ClemenceSul/FALCON_Hand/BuildingInstructions/Guide_Images/2_AssembleFinger/Components/Digital/Slide2.PNG

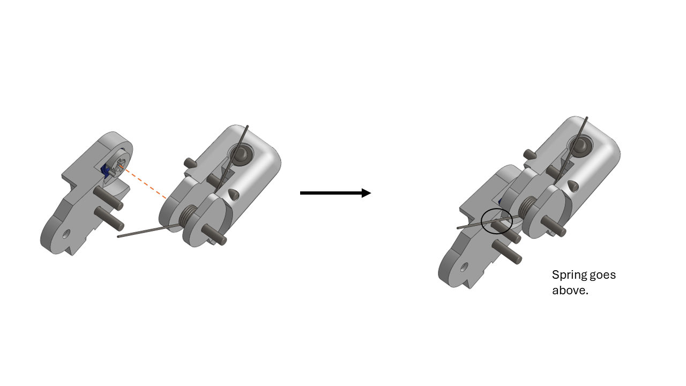
BuildingInstructions/Guide_Images/2_AssembleFinger/Components/Digital/Slide2.PNG
