ClemenceSul/FALCON_Hand/BuildingInstructions/Guide_Images/2_AssembleFinger/Components/Real/Slide4.PNG

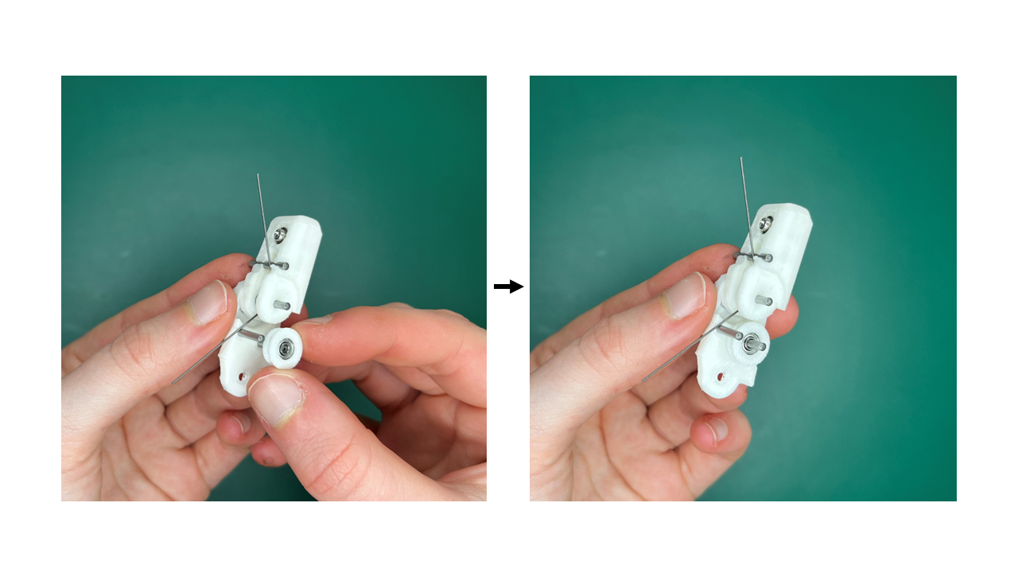
BuildingInstructions/Guide_Images/2_AssembleFinger/Components/Real/Slide4.PNG
