ClemenceSul/FALCON_Hand/3DFiles/Thumb/CMC_main.STL

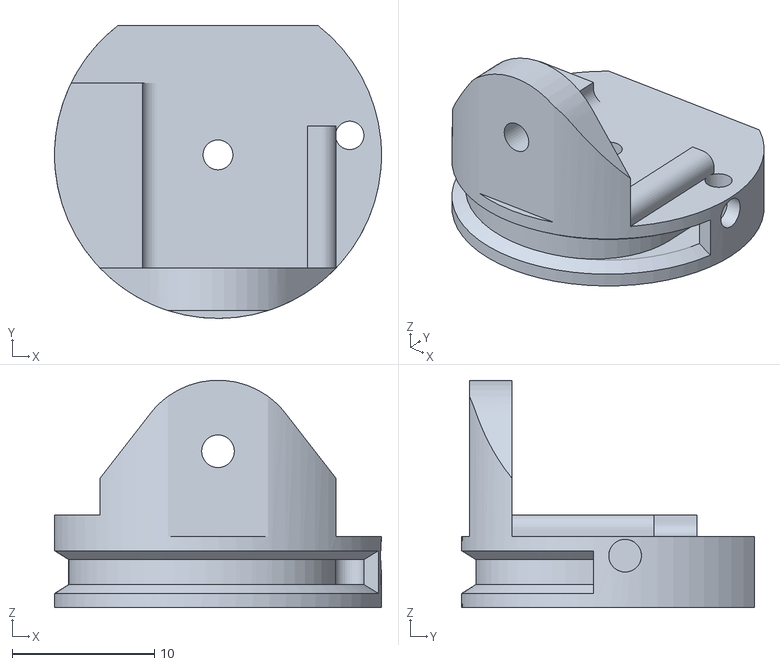
[picture p10: CAD file, 2024-06-19]
3DFiles/Thumb/CMC_main.STL
23.0 x 20.6 x 16.0
