ClemenceSul/FALCON_Hand/3DFiles/Fingers/PulleySpool.STL

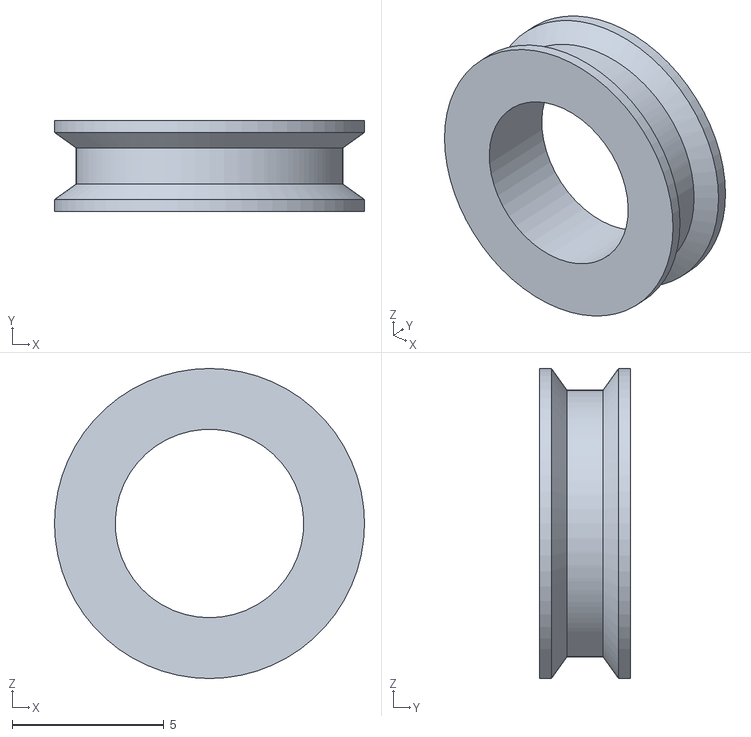
[picture p11: CAD file, 2024-06-19]
3DFiles/Fingers/PulleySpool.STL
10.2 x 3.00 x 10.2
