ClemenceSul/FALCON_Hand/3DFiles/Palm/Knuckles.STL

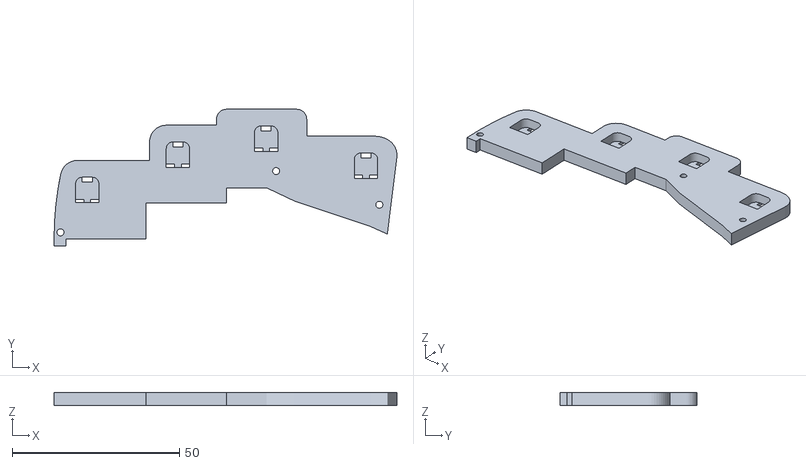
[picture p12: CAD file, 2024-06-19]
3DFiles/Palm/Knuckles.STL
102.6 x 40.8 x 4.00
