ClemenceSul/FALCON_Hand/3DFiles/Practice.STL

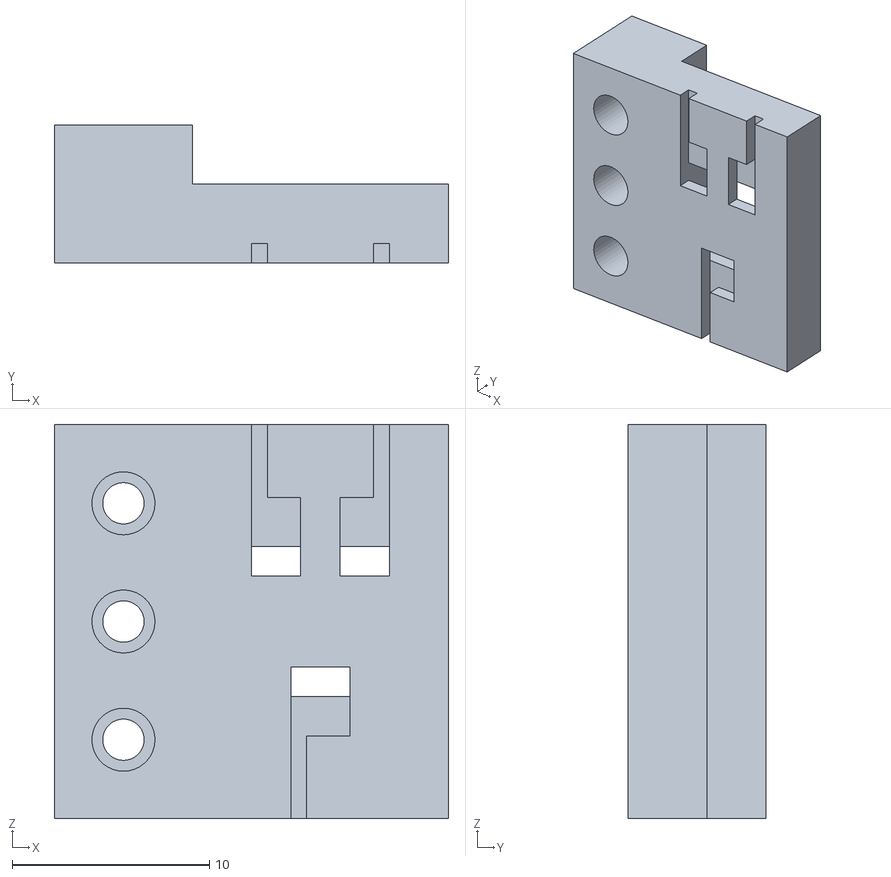
[picture p13: CAD file, 2024-06-19]
3DFiles/Practice.STL
20.0 x 7.00 x 20.0
