ClemenceSul/FALCON_Hand/3DFiles/Thumb/Thumb_ProximalRight.STL

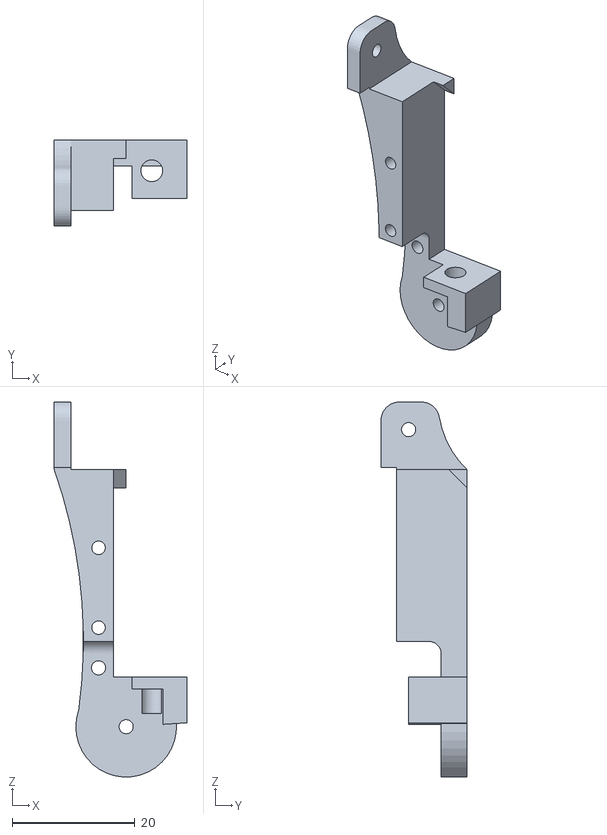
[picture p14: CAD file, 2024-06-19]
3DFiles/Thumb/Thumb_ProximalRight.STL
21.6 x 14.0 x 61.1
