ClemenceSul/FALCON_Hand/3DFiles/Fingers/MI_Metacarpal.STL

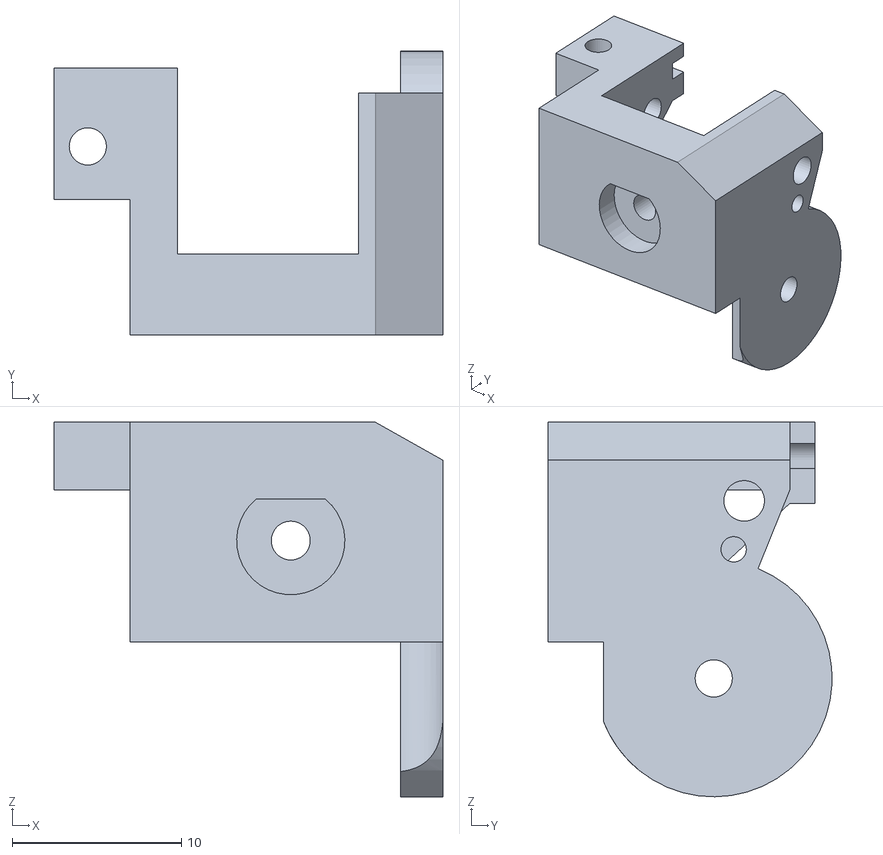
[picture p15: CAD file, 2024-06-19]
3DFiles/Fingers/MI_Metacarpal.STL
23.0 x 16.8 x 22.1
