ClemenceSul/FALCON_Hand/3DFiles/Palm/Palm.STL

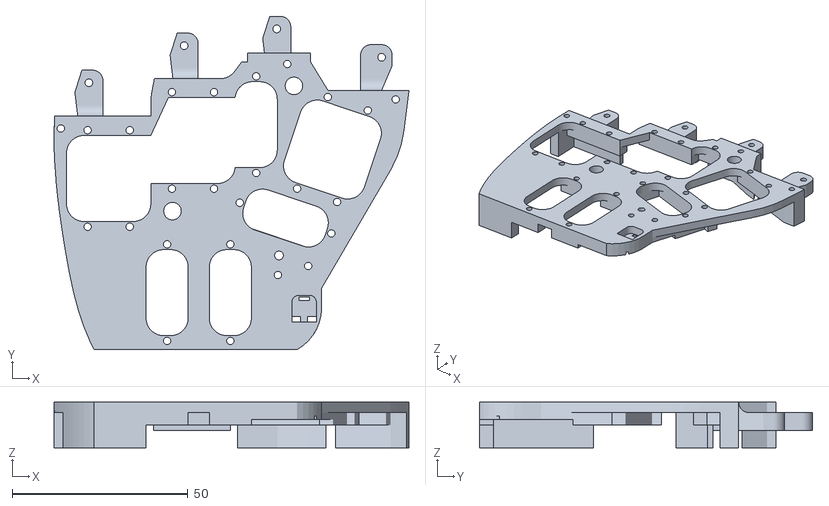
[picture p16: CAD file, 2024-06-19]
3DFiles/Palm/Palm.STL
101.1 x 94.9 x 13.0
