ClemenceSul/FALCON_Hand/3DFiles/Fingers/PR_ProximalRight_vN.STL

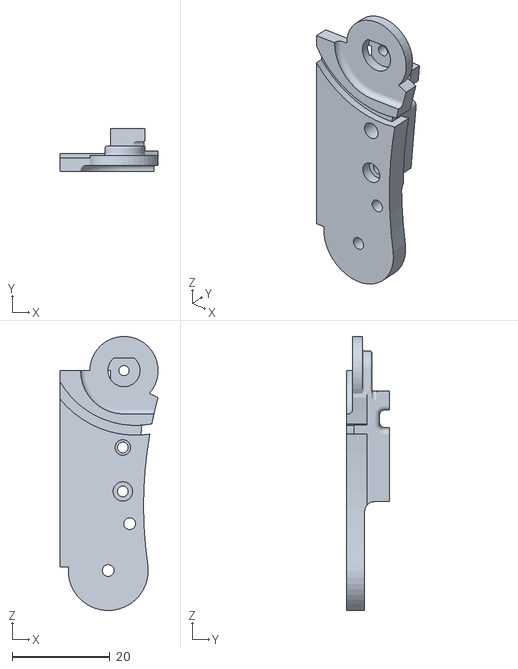
[picture p17: CAD file, 2024-06-19]
3DFiles/Fingers/PR_ProximalRight_vN.STL
20.1 x 8.75 x 56.1
