ClemenceSul/FALCON_Hand/3DFiles/Palm/Thumb_attach.STL

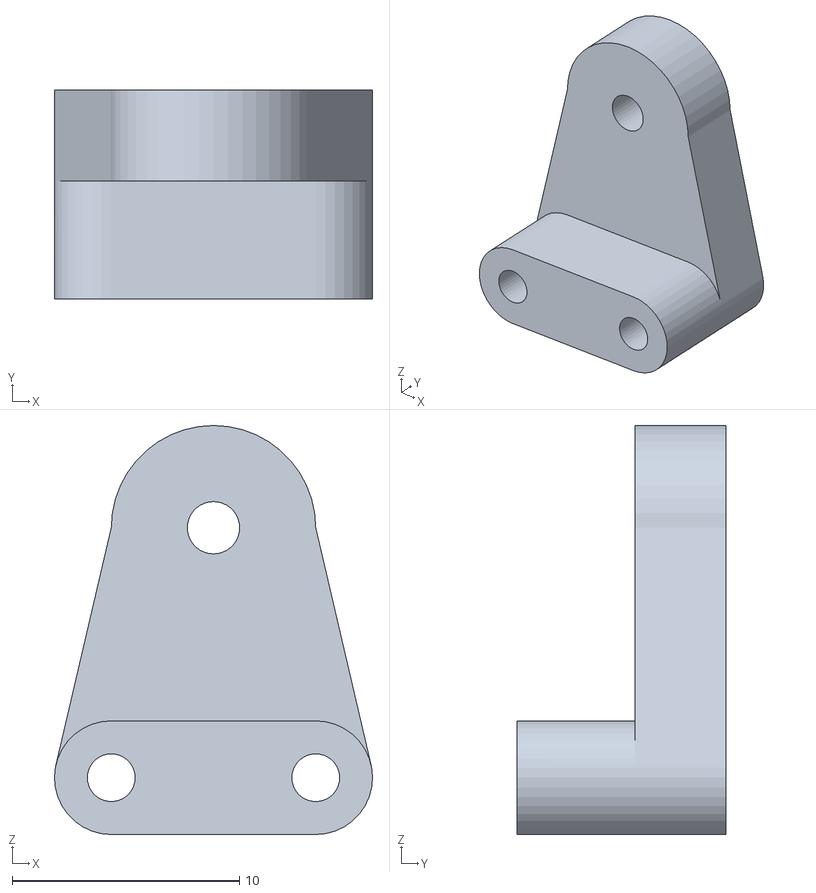
[picture p18: CAD file, 2024-06-19]
3DFiles/Palm/Thumb_attach.STL
14.0 x 9.20 x 18.0
