ClemenceSul/FALCON_Hand/3DFiles/Thumb/Thumb_MedialRight.STL

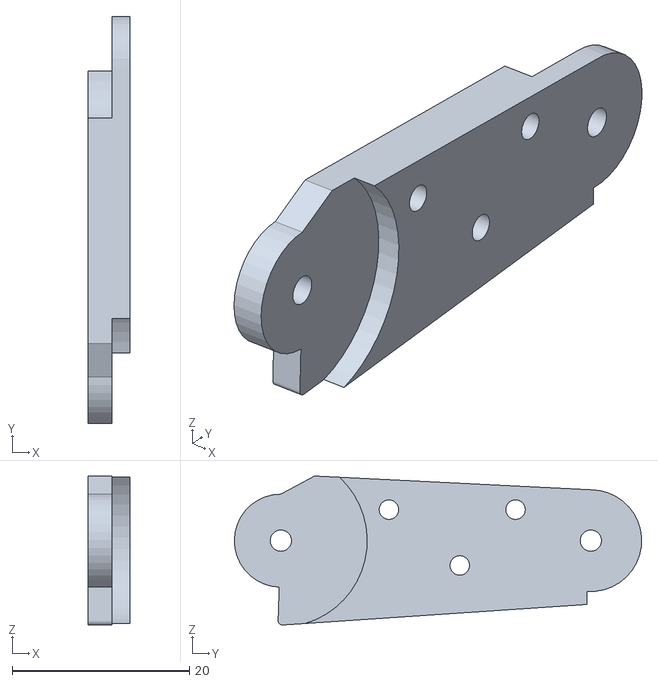
[picture p19: CAD file, 2024-06-19]
3DFiles/Thumb/Thumb_MedialRight.STL
4.70 x 46.0 x 16.8
