ClemenceSul/FALCON_Hand/3DFiles/Fingers/Motor_spool.STL

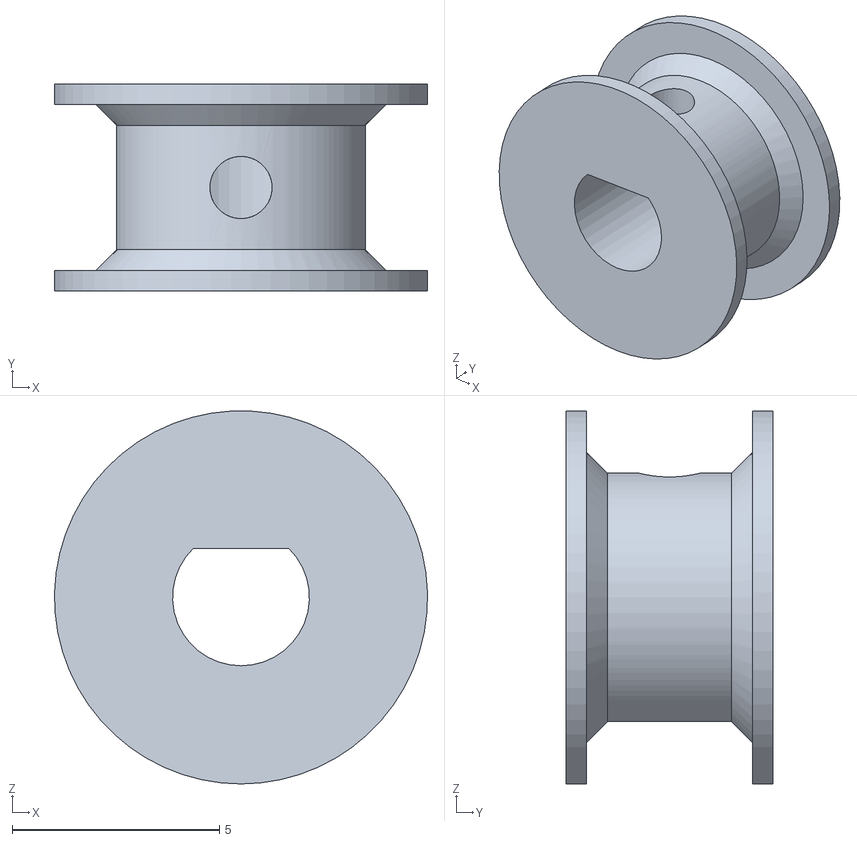
[picture p20: CAD file, 2024-06-19]
3DFiles/Fingers/Motor_spool.STL
9.00 x 5.00 x 8.99
