ClemenceSul/FALCON_Hand/3DFiles/Palm/FrontCover.STL

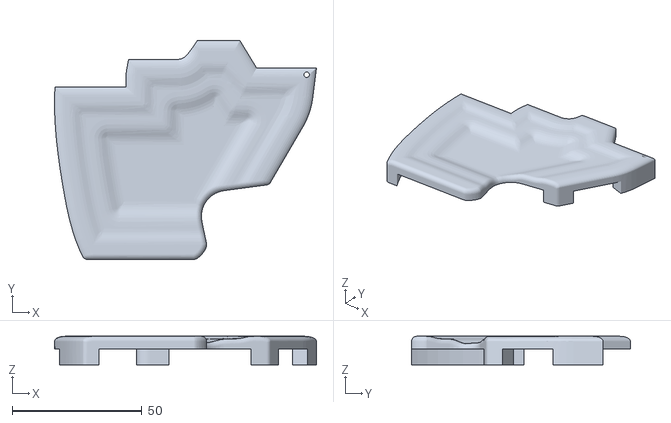
[picture p21: CAD file, 2024-06-19]
3DFiles/Palm/FrontCover.STL
101.1 x 84.4 x 11.0
