ClemenceSul/FALCON_Hand/3DFiles/Thumb/CMC_link.STL

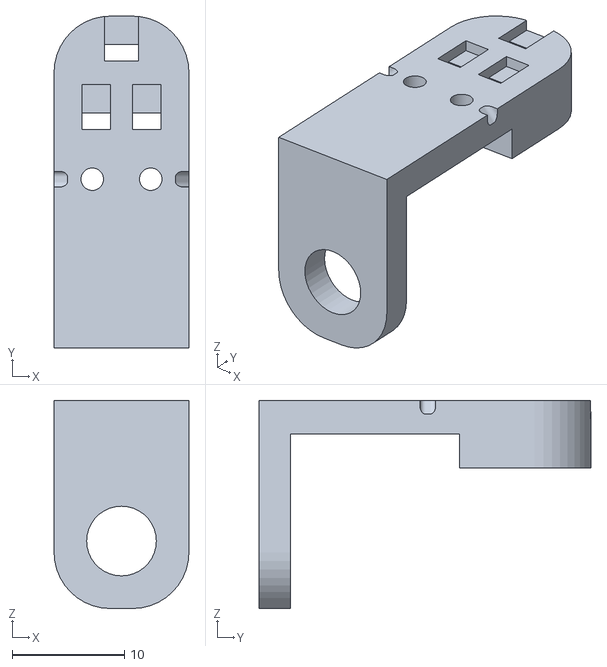
[picture p22: CAD file, 2024-06-19]
3DFiles/Thumb/CMC_link.STL
12.0 x 29.5 x 18.5
