ClemenceSul/FALCON_Hand/3DFiles/Fingers/PR_ProximalLeft_vN.STL

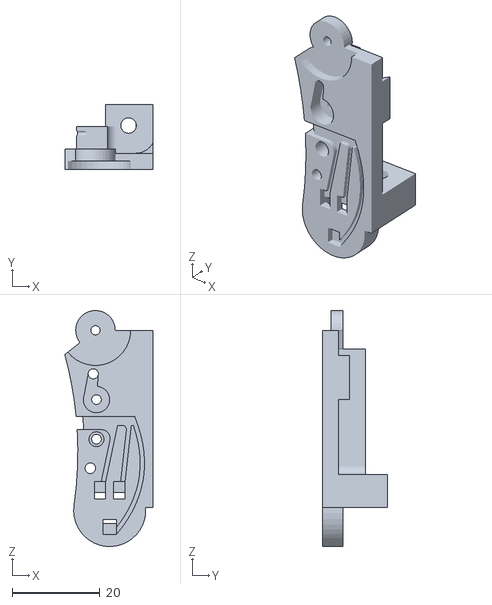
[picture p23: CAD file, 2024-06-19]
3DFiles/Fingers/PR_ProximalLeft_vN.STL
20.1 x 14.8 x 53.6
