ClemenceSul/FALCON_Hand/3DFiles/Thumb/CMC_part1.STL

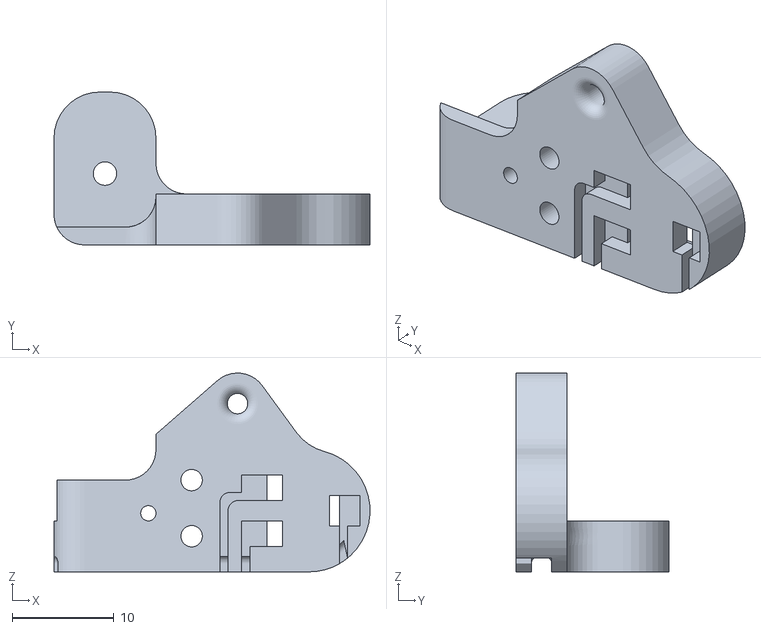
[picture p24: CAD file, 2024-06-19]
3DFiles/Thumb/CMC_part1.STL
31.0 x 15.0 x 19.5
