ClemenceSul/FALCON_Hand/3DFiles/Fingers/MedialLeft.STL

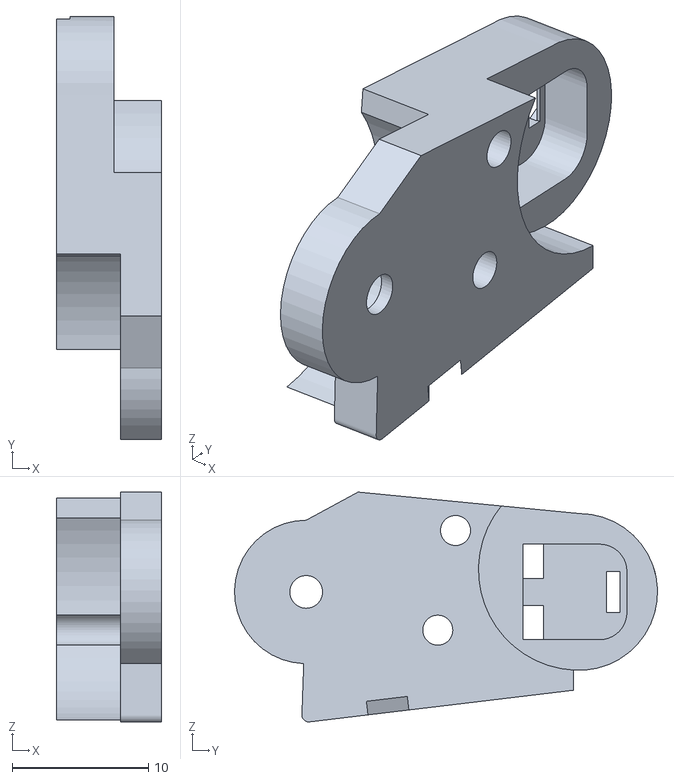
[picture p25: CAD file, 2024-06-19]
3DFiles/Fingers/MedialLeft.STL
7.70 x 31.0 x 16.8
