ClemenceSul/FALCON_Hand/3DFiles/Thumb/Thumb_MedialLeft.STL

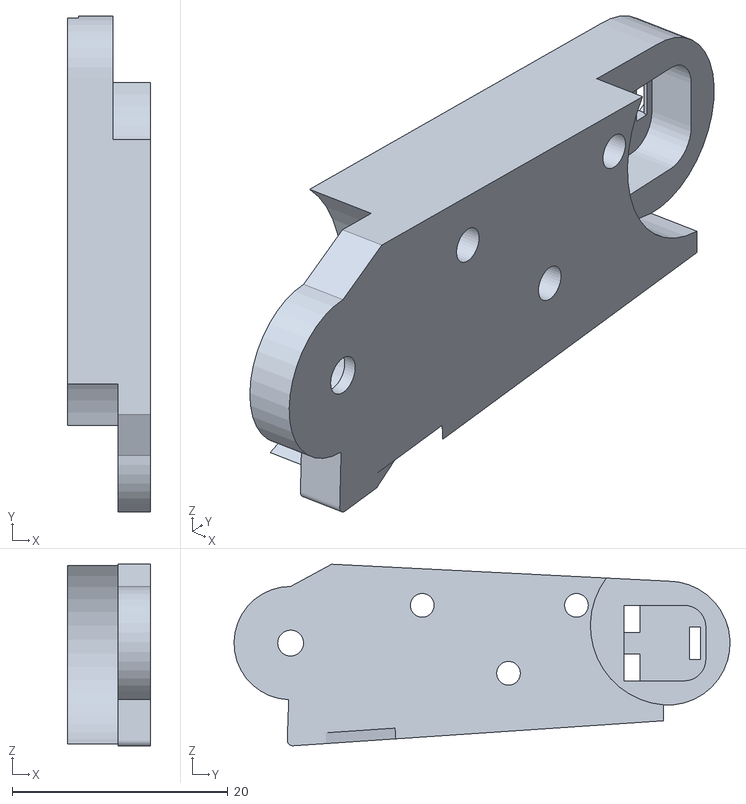
[picture p26: CAD file, 2024-06-19]
3DFiles/Thumb/Thumb_MedialLeft.STL
7.70 x 46.0 x 16.8
