ClemenceSul/FALCON_Hand/3DFiles/Thumb/CMC_part2.STL

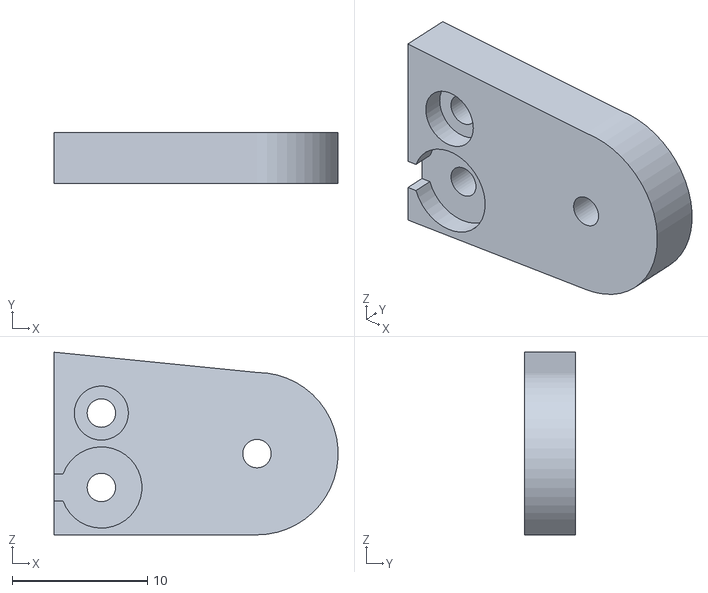
[picture p28: CAD file, 2024-06-19]
3DFiles/Thumb/CMC_part2.STL
21.0 x 3.75 x 13.5
