ClemenceSul/FALCON_Hand/3DFiles/Fingers/PR_MetacarpalBranch.STL

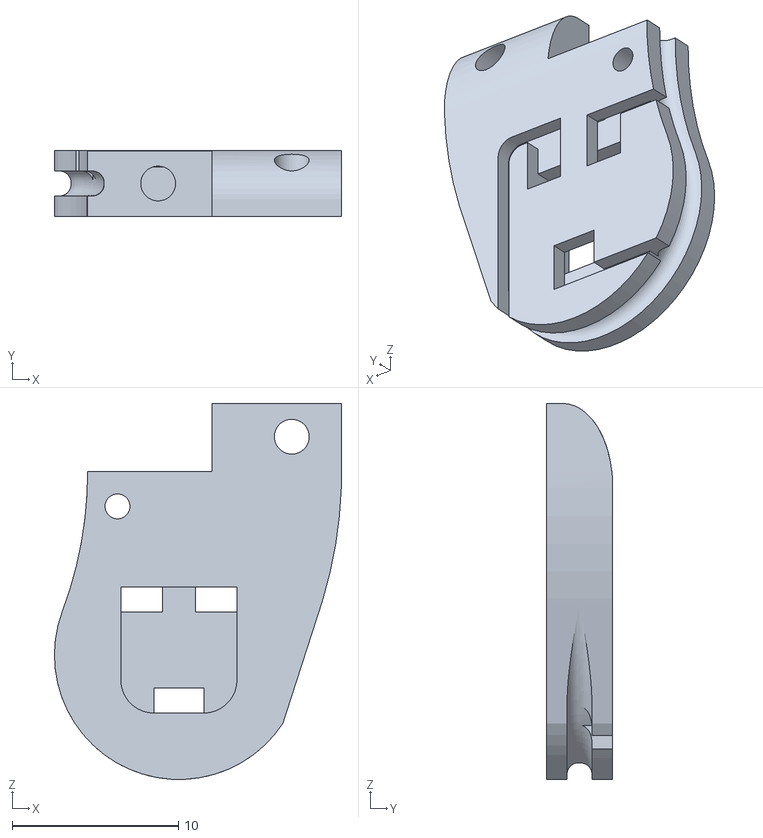
[picture p29: CAD file, 2024-06-19]
3DFiles/Fingers/PR_MetacarpalBranch.STL
17.3 x 4.00 x 22.6
