ClemenceSul/FALCON_Hand/3DFiles/Fingers/MedialRight.STL

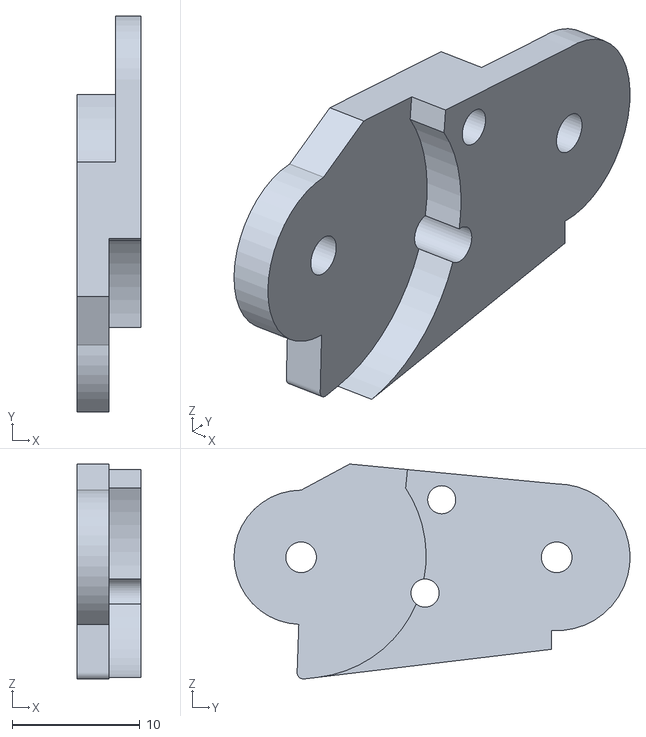
[picture p30: CAD file, 2024-06-19]
3DFiles/Fingers/MedialRight.STL
5.00 x 31.0 x 16.8
