ClemenceSul/FALCON_Hand/3DFiles/Thumb/Thumb_ProximalLeft.STL

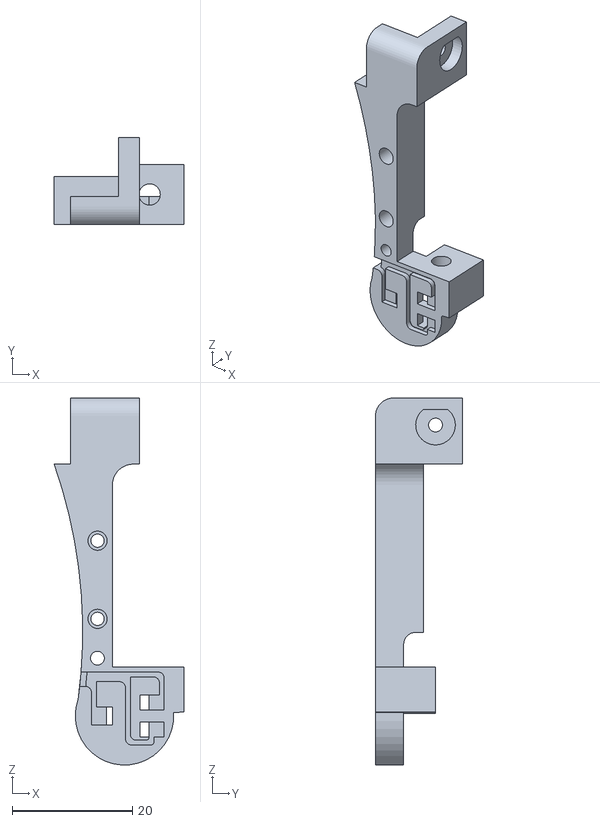
[picture p31: CAD file, 2024-06-19]
3DFiles/Thumb/Thumb_ProximalLeft.STL
21.6 x 14.5 x 61.1
