ClemenceSul/FALCON_Hand/3DFiles/Fingers/Fingertip.STL

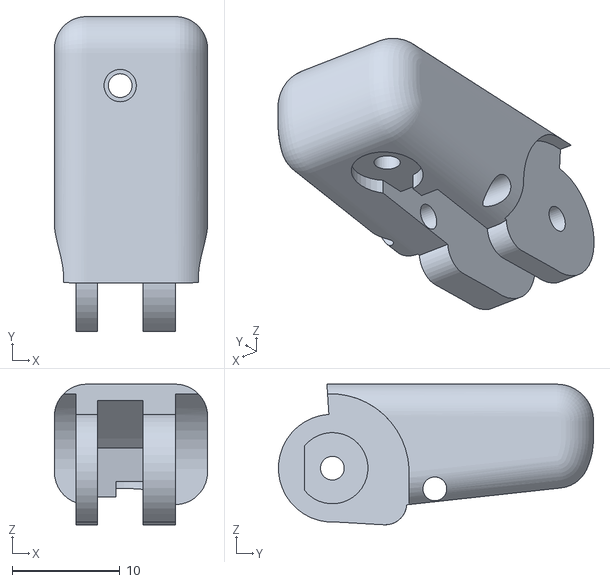
[picture p32: CAD file, 2024-06-19]
3DFiles/Fingers/Fingertip.STL
14.2 x 29.2 x 13.0
