ClemenceSul/FALCON_Hand/3DFiles/Thumb/Thumb_Fingertip.STL

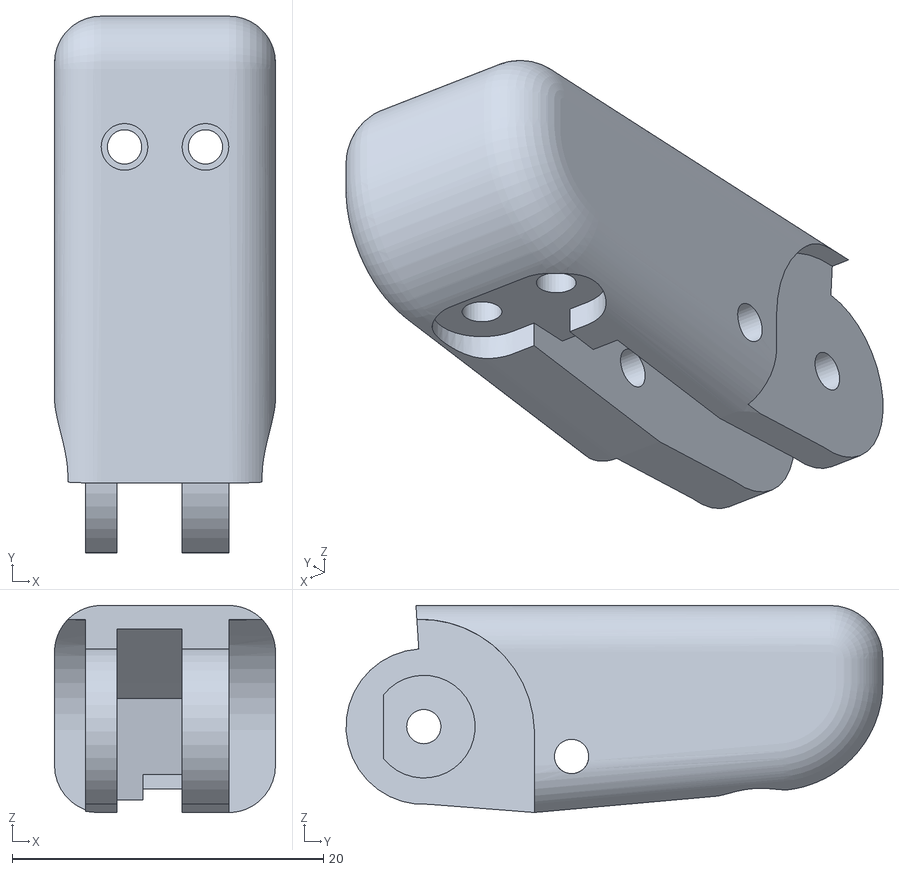
[picture p33: CAD file, 2024-06-19]
3DFiles/Thumb/Thumb_Fingertip.STL
14.2 x 34.5 x 13.3
