ClemenceSul/FALCON_Hand/3DFiles/Fingers/MI_ProximalLeft.STL

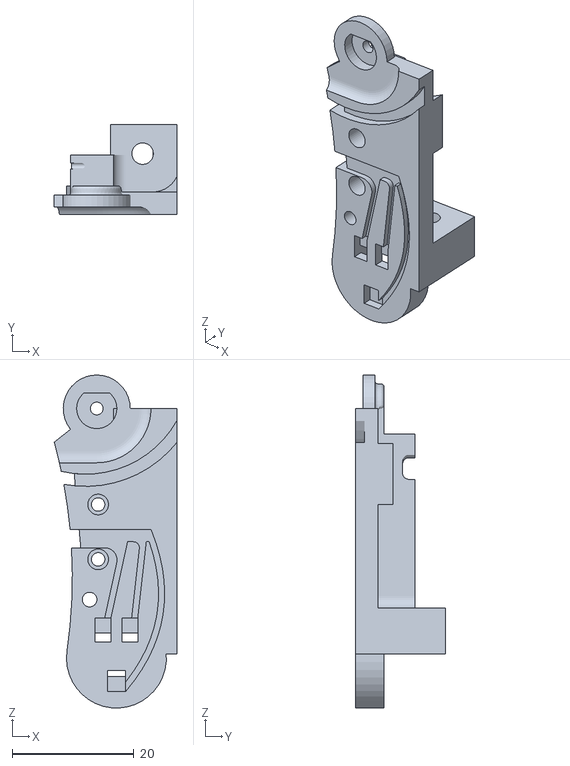
[picture p34: CAD file, 2024-06-19]
3DFiles/Fingers/MI_ProximalLeft.STL
20.1 x 14.8 x 54.6
