ClemenceSul/FALCON_Hand/3DFiles/Fingers/MI_ProximalRight.STL

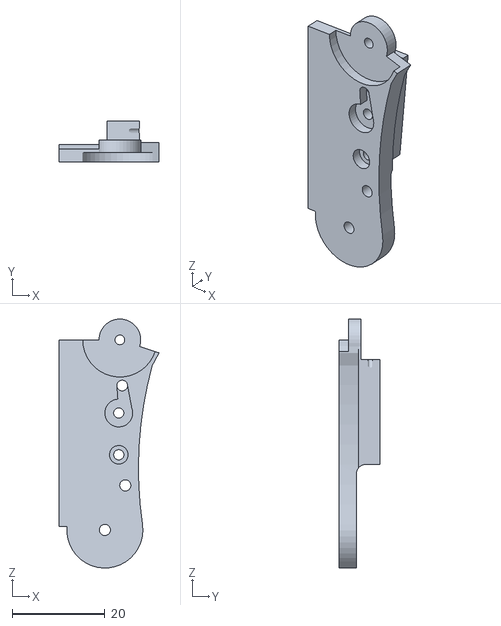
[picture p35: CAD file, 2024-06-19]
3DFiles/Fingers/MI_ProximalRight.STL
21.6 x 8.75 x 53.6
