ClemenceSul/FALCON_Hand/(list of files, cad)

Other CAD files:
3DFiles/Fingers/MI_MetacarpalBranch.STL
