ClemenceSul/FALCON_Hand/BuildingInstructions/Guide_Images/1_PrepPieces/DCMotor/Real/Frame1.png

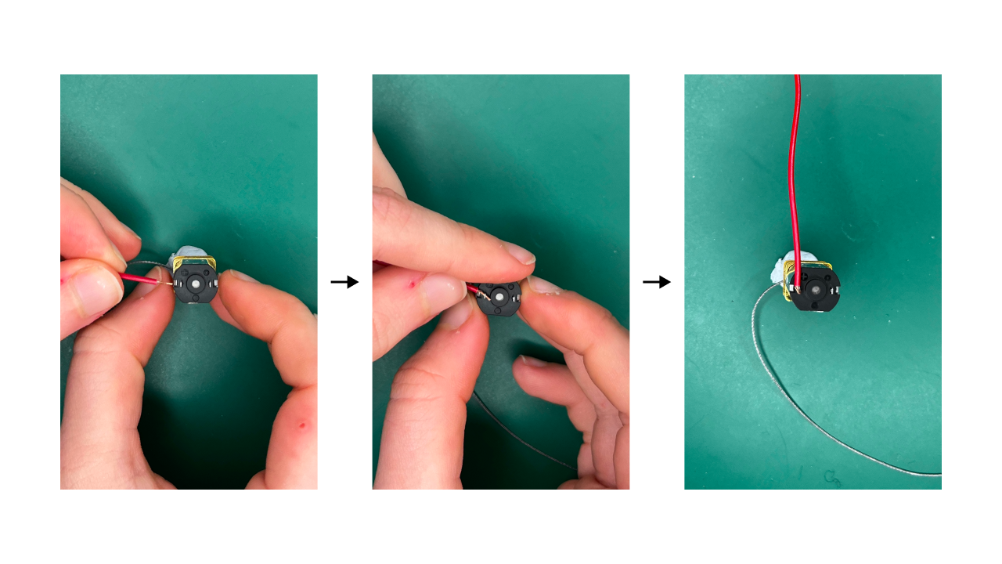
BuildingInstructions/Guide_Images/1_PrepPieces/DCMotor/Real/Frame1.png
