ClemenceSul/FALCON_Hand/BuildingInstructions/Guide_Images/1_PrepPieces/DCMotor/Real/Frame8.png

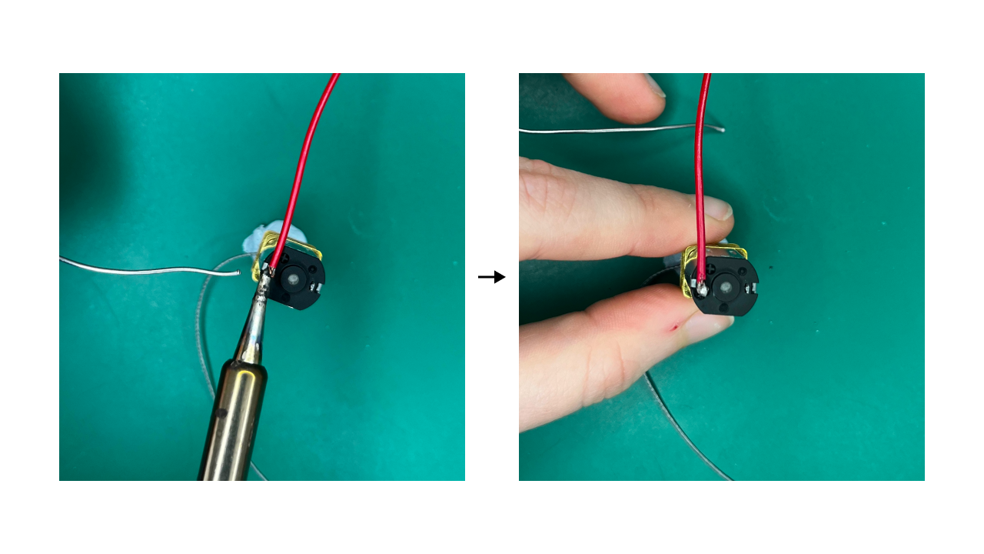
BuildingInstructions/Guide_Images/1_PrepPieces/DCMotor/Real/Frame8.png
