ClemenceSul/FALCON_Hand/BuildingInstructions/Guide_Images/1_PrepPieces/DCMotor/Real/Frame9.png

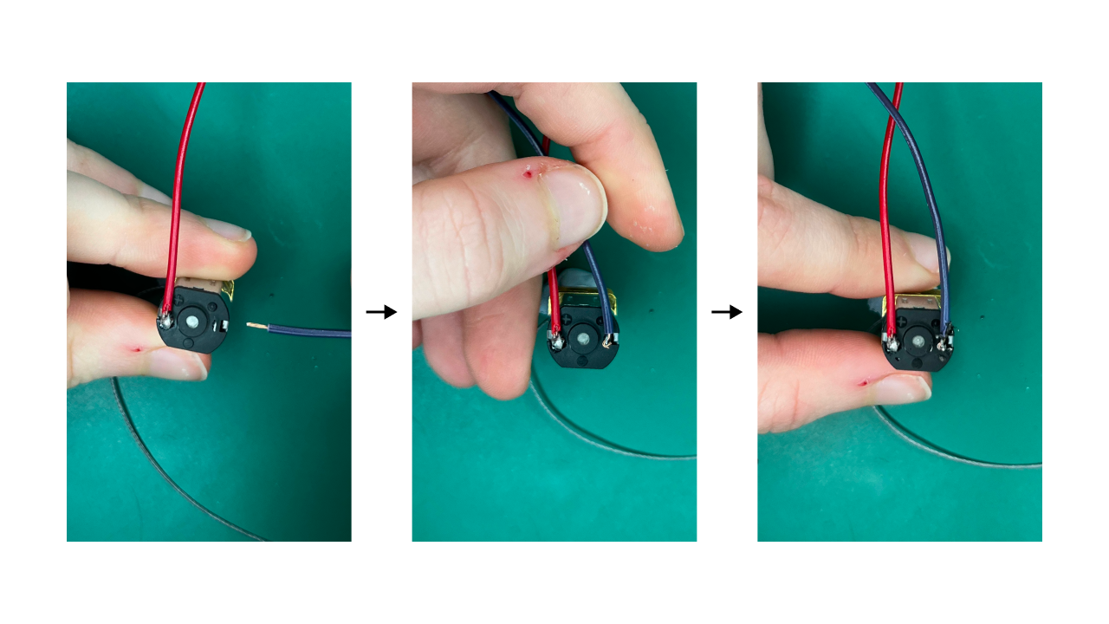
BuildingInstructions/Guide_Images/1_PrepPieces/DCMotor/Real/Frame9.png
