ClemenceSul/FALCON_Hand/BuildingInstructions/Guide_Images/1_PrepPieces/MedialRight/Digital/doc.png

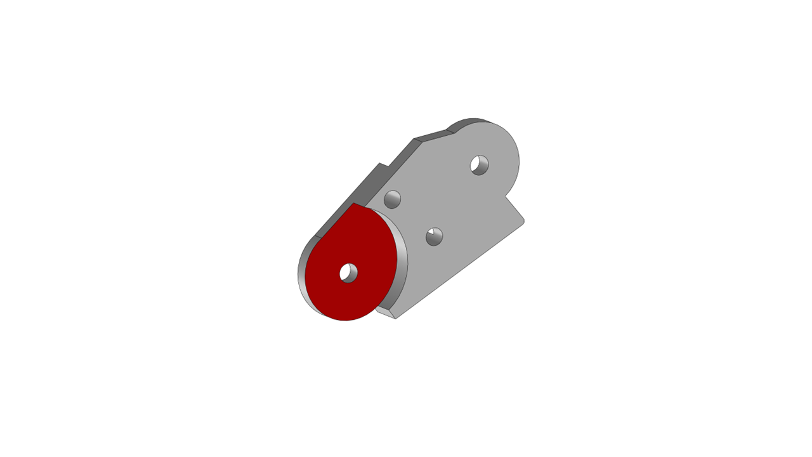
BuildingInstructions/Guide_Images/1_PrepPieces/MedialRight/Digital/doc.png
