ClemenceSul/FALCON_Hand/BuildingInstructions/Guide_Images/1_PrepPieces/MedialRight/Real/Slide5.PNG

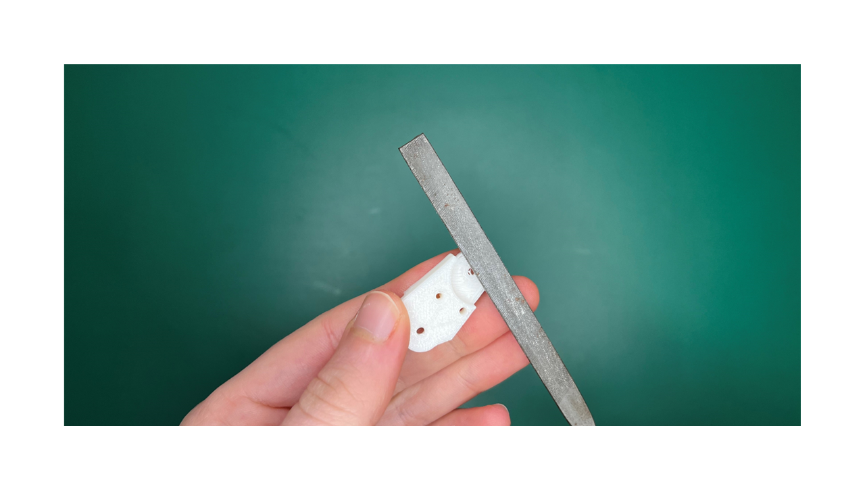
BuildingInstructions/Guide_Images/1_PrepPieces/MedialRight/Real/Slide5.PNG
