ClemenceSul/FALCON_Hand/BuildingInstructions/Guide_Images/1_PrepPieces/MedialRight_T/Slide5.PNG

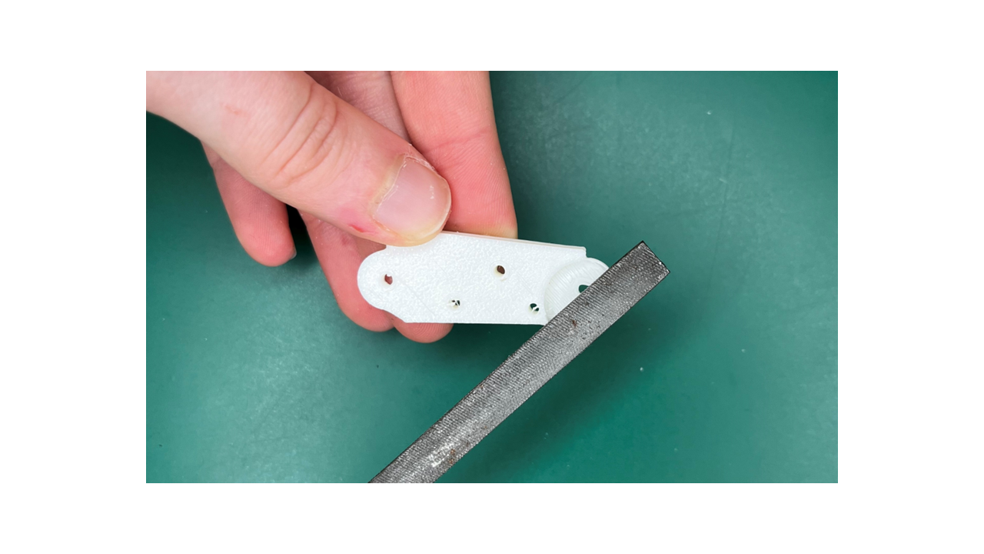
BuildingInstructions/Guide_Images/1_PrepPieces/MedialRight_T/Slide5.PNG
