ClemenceSul/FALCON_Hand/BuildingInstructions/Guide_Images/1_PrepPieces/ProximalRight_T/Slide12.PNG

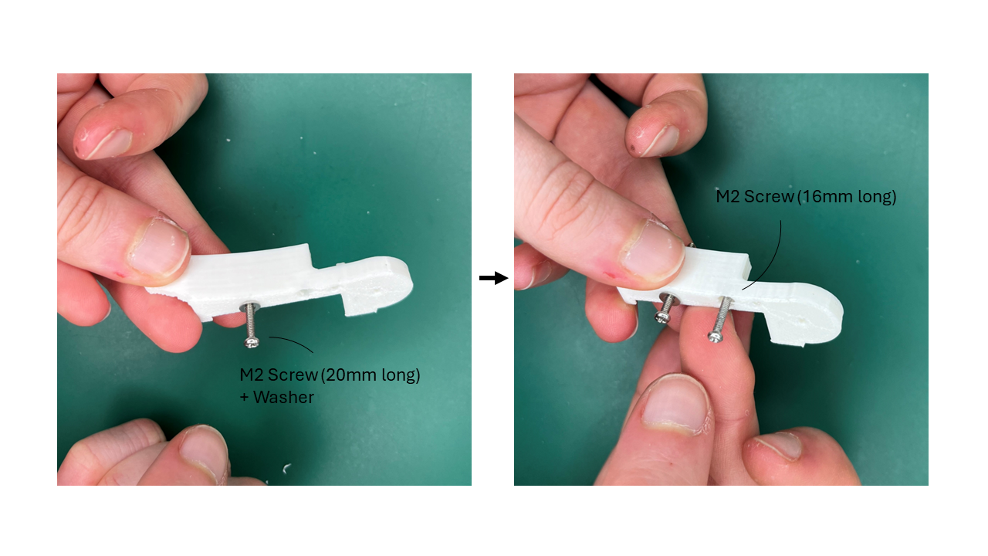
BuildingInstructions/Guide_Images/1_PrepPieces/ProximalRight_T/Slide12.PNG
