ClemenceSul/FALCON_Hand/BuildingInstructions/Guide_Images/1_PrepPieces/Pulley/Digital/Slide4.PNG

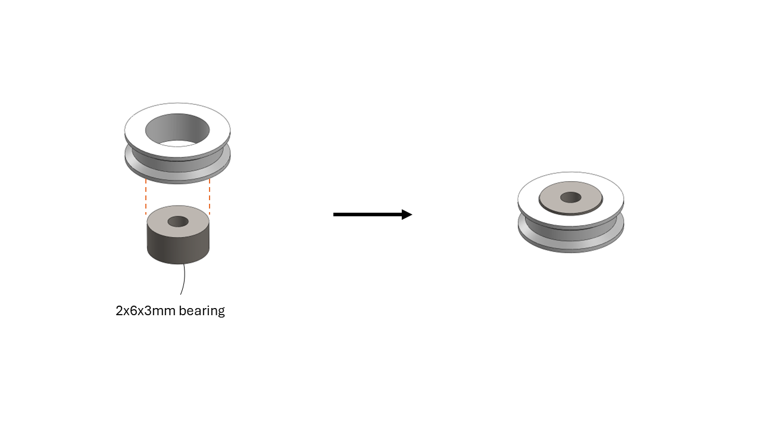
BuildingInstructions/Guide_Images/1_PrepPieces/Pulley/Digital/Slide4.PNG
