ClemenceSul/FALCON_Hand/BuildingInstructions/Guide_Images/1_PrepPieces/Pulley/Real/Slide4.PNG

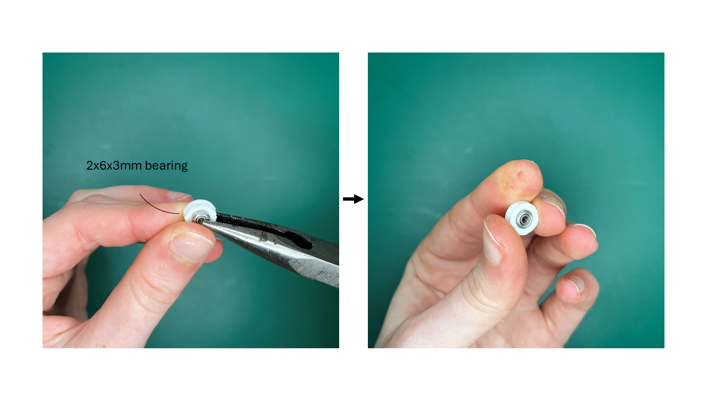
BuildingInstructions/Guide_Images/1_PrepPieces/Pulley/Real/Slide4.PNG
