ClemenceSul/FALCON_Hand/BuildingInstructions/Guide_Images/2_AssembleFinger/Padding/Slide2.PNG

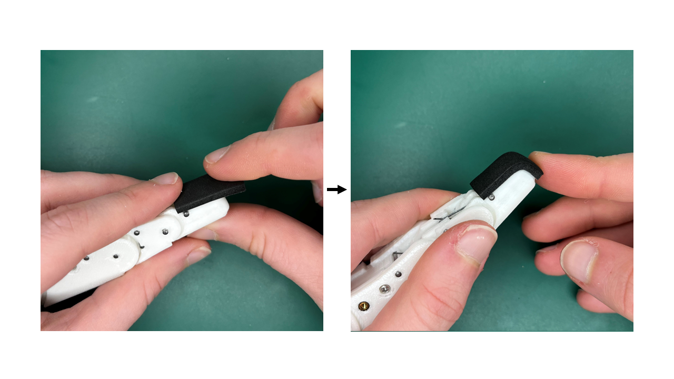
BuildingInstructions/Guide_Images/2_AssembleFinger/Padding/Slide2.PNG
