ClemenceSul/FALCON_Hand/BuildingInstructions/Guide_Images/2_AssembleFinger/Padding/Slide3.PNG

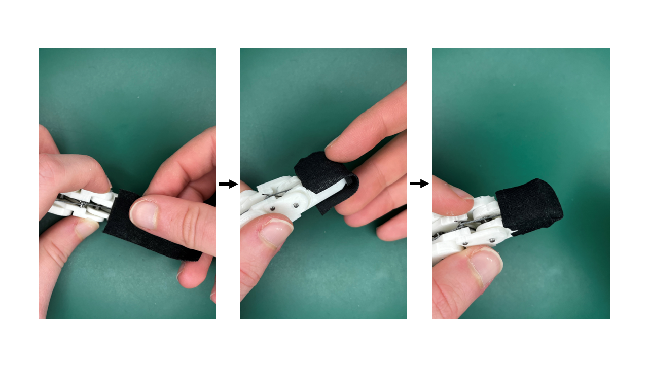
BuildingInstructions/Guide_Images/2_AssembleFinger/Padding/Slide3.PNG
