ClemenceSul/FALCON_Hand/BuildingInstructions/Guide_Images/2_AssembleFinger/Tendon/Digital/Frame130.png

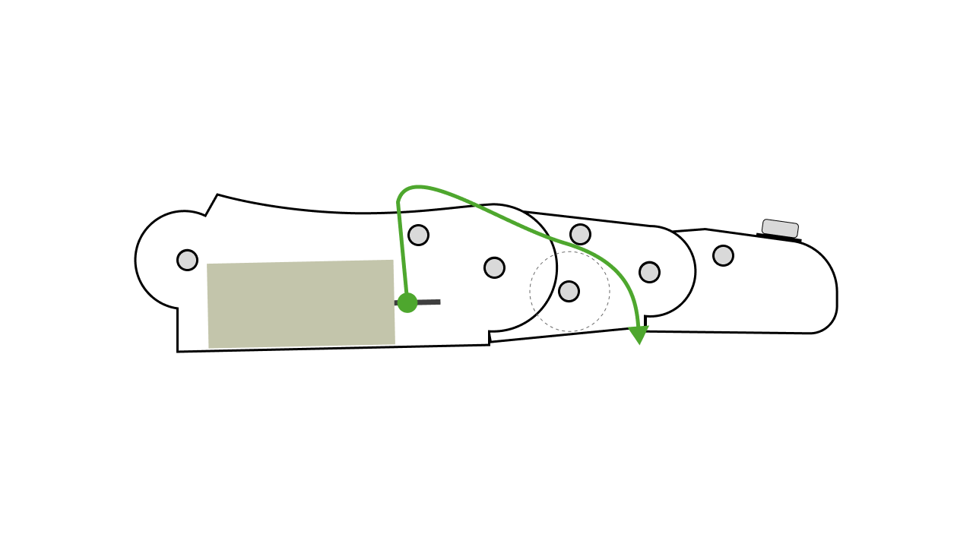
BuildingInstructions/Guide_Images/2_AssembleFinger/Tendon/Digital/Frame130.png
