ClemenceSul/FALCON_Hand/BuildingInstructions/Guide_Images/2_AssembleFinger/Tendon/Real/Slide2.PNG

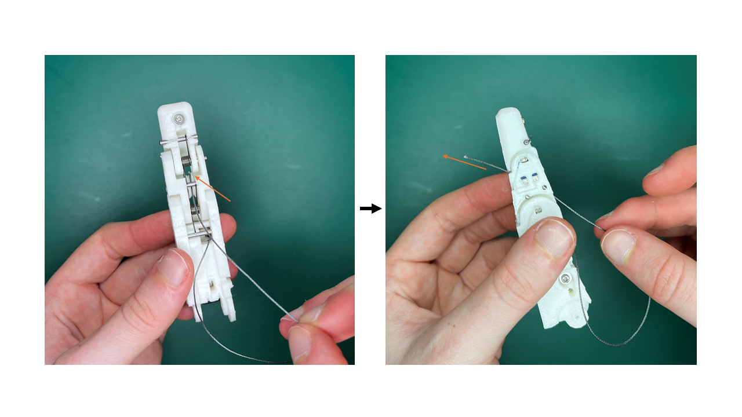
BuildingInstructions/Guide_Images/2_AssembleFinger/Tendon/Real/Slide2.PNG
