ClemenceSul/FALCON_Hand/BuildingInstructions/Guide_Images/2_AssembleFinger/Thumb/Frame1.png

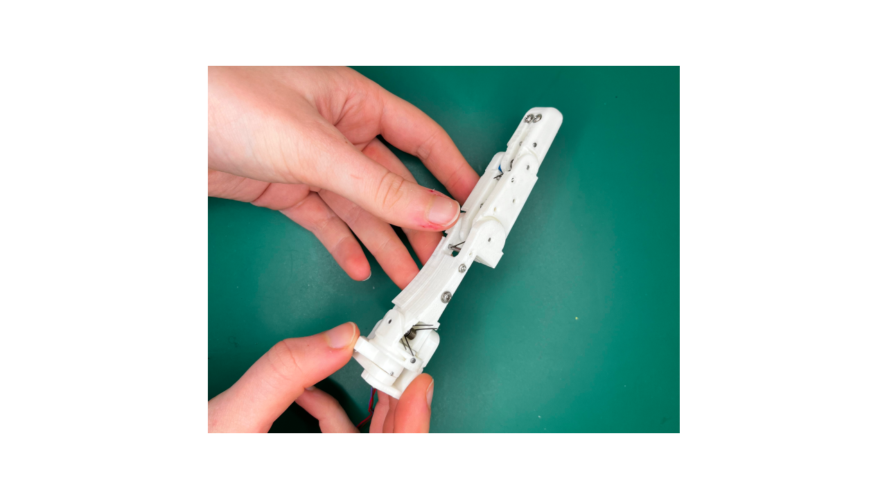
BuildingInstructions/Guide_Images/2_AssembleFinger/Thumb/Frame1.png
