ClemenceSul/FALCON_Hand/BuildingInstructions/Guide_Images/3_Metacarpal/Joint/Digital/Slide6.PNG

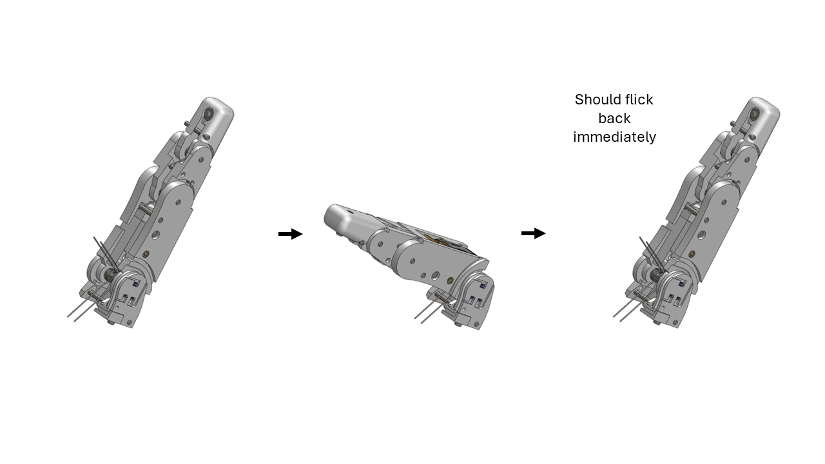
BuildingInstructions/Guide_Images/3_Metacarpal/Joint/Digital/Slide6.PNG
