ClemenceSul/FALCON_Hand/BuildingInstructions/Guide_Images/3_Metacarpal/Joint/Digital/Slide8.PNG

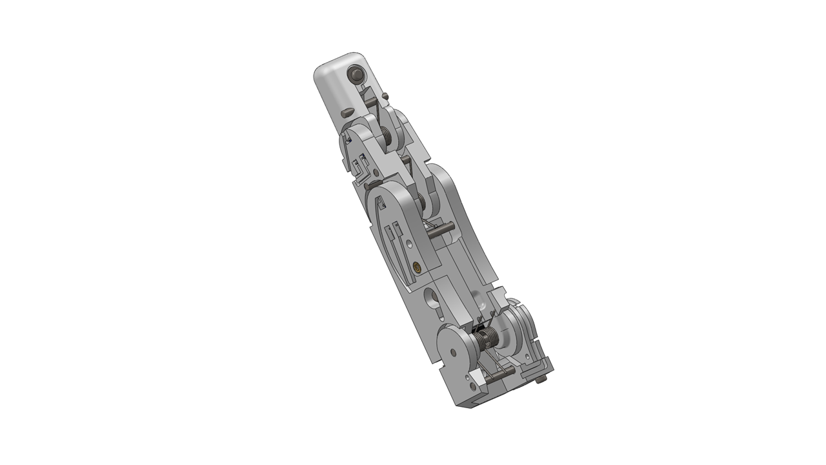
BuildingInstructions/Guide_Images/3_Metacarpal/Joint/Digital/Slide8.PNG
