ClemenceSul/FALCON_Hand/BuildingInstructions/Guide_Images/3_Metacarpal/Joint/Real/Slide1.PNG

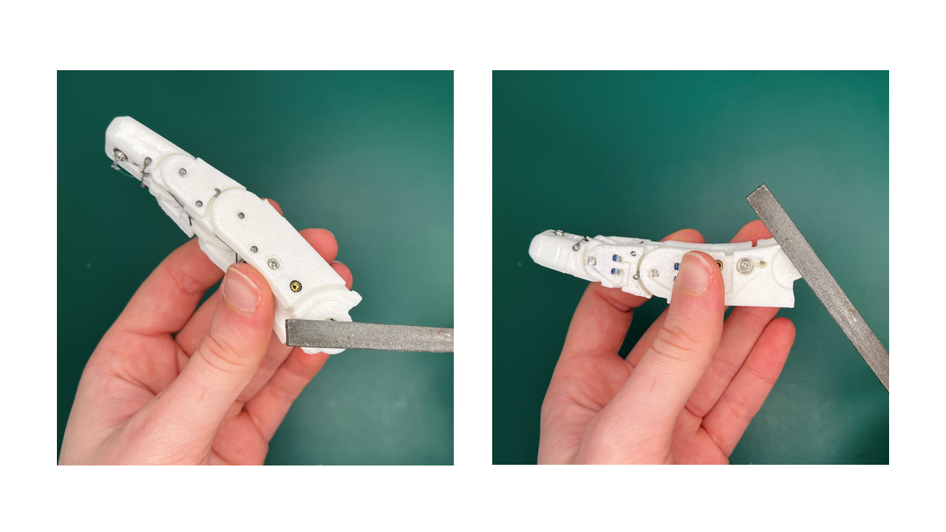
BuildingInstructions/Guide_Images/3_Metacarpal/Joint/Real/Slide1.PNG
