ClemenceSul/FALCON_Hand/BuildingInstructions/Guide_Images/3_Metacarpal/Joint/Real/Slide4.PNG

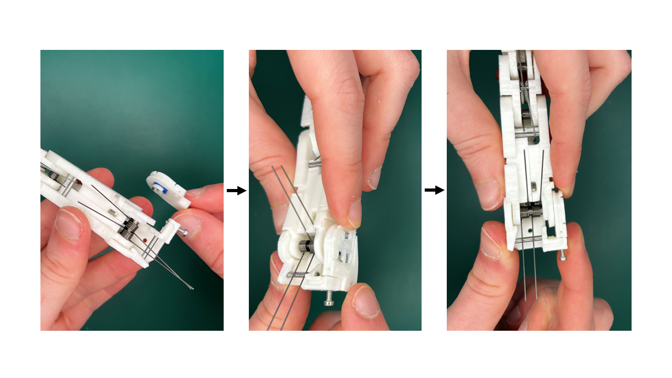
BuildingInstructions/Guide_Images/3_Metacarpal/Joint/Real/Slide4.PNG
