ClemenceSul/FALCON_Hand/BuildingInstructions/Guide_Images/3_Metacarpal/Joint_I/Digital/Slide7.PNG

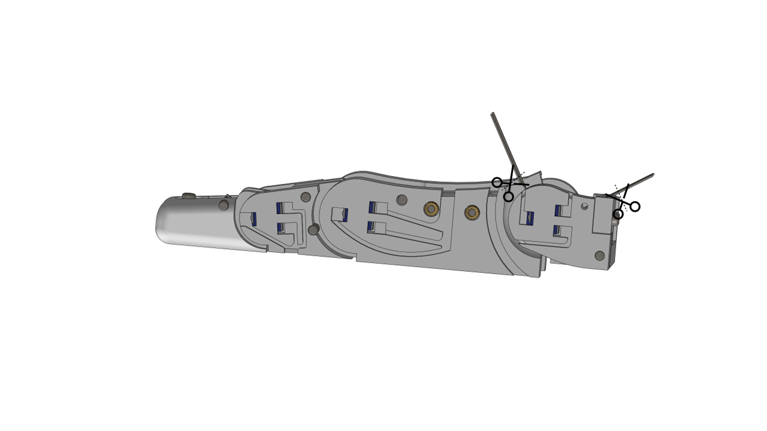
BuildingInstructions/Guide_Images/3_Metacarpal/Joint_I/Digital/Slide7.PNG
