ClemenceSul/FALCON_Hand/BuildingInstructions/Guide_Images/3_Metacarpal/Joint_I/Real/Slide3.PNG

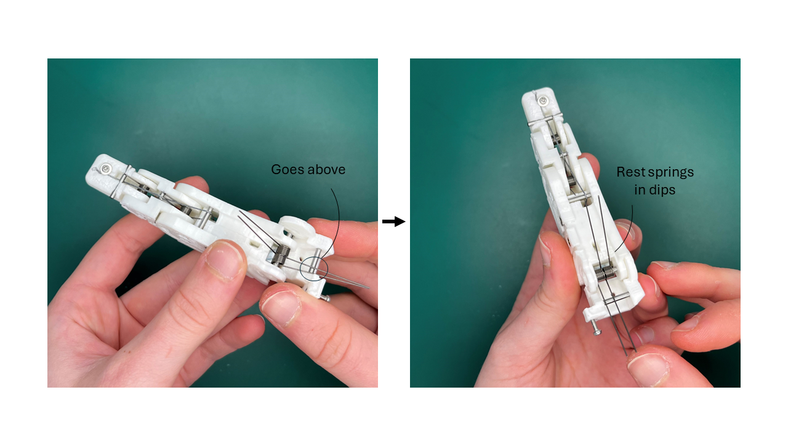
BuildingInstructions/Guide_Images/3_Metacarpal/Joint_I/Real/Slide3.PNG
