ClemenceSul/FALCON_Hand/BuildingInstructions/Guide_Images/3_Metacarpal/Metacarpal/Digital/Slide1.png

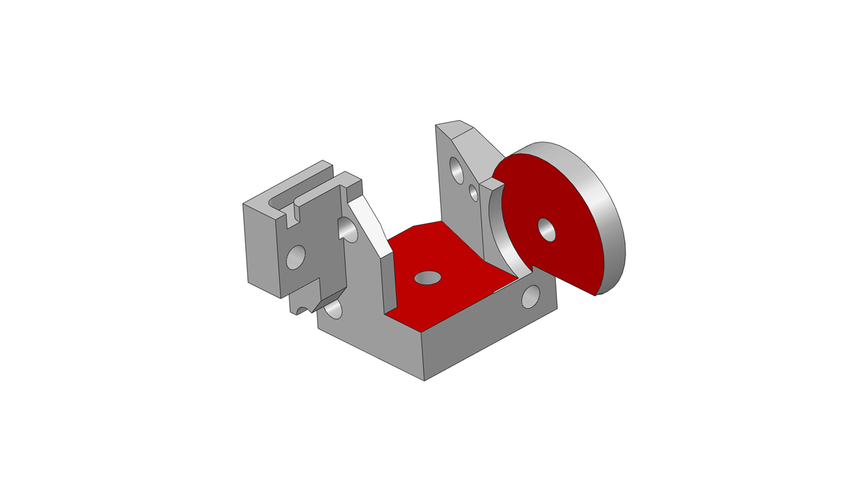
BuildingInstructions/Guide_Images/3_Metacarpal/Metacarpal/Digital/Slide1.png
