ClemenceSul/FALCON_Hand/BuildingInstructions/Guide_Images/3_Metacarpal/Metacarpal/Real/Slide1.PNG

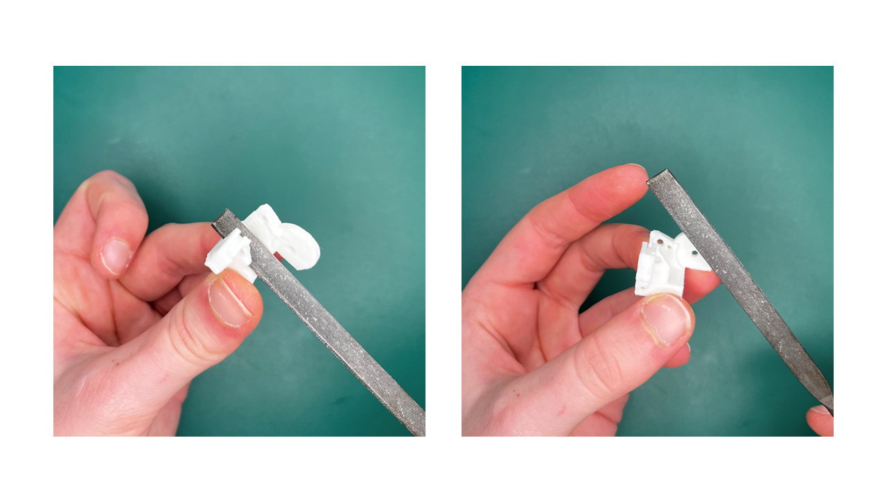
BuildingInstructions/Guide_Images/3_Metacarpal/Metacarpal/Real/Slide1.PNG
