ClemenceSul/FALCON_Hand/BuildingInstructions/Guide_Images/3_Metacarpal/Metacarpal_I/Digital/Slide3.PNG

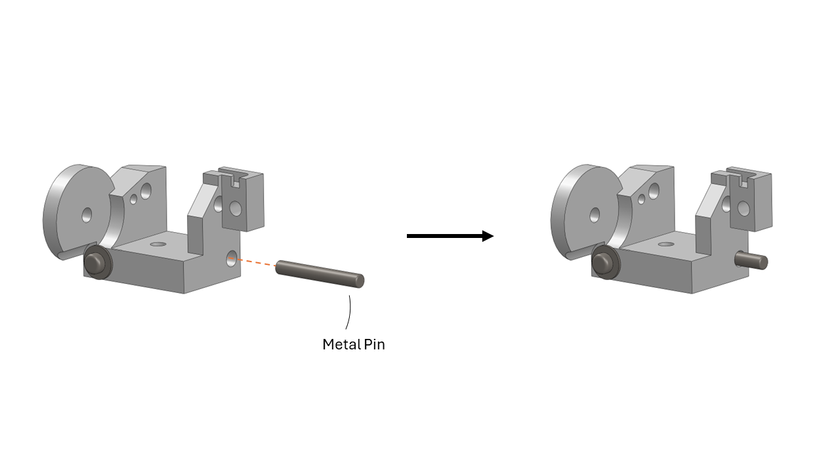
BuildingInstructions/Guide_Images/3_Metacarpal/Metacarpal_I/Digital/Slide3.PNG
