ClemenceSul/FALCON_Hand/BuildingInstructions/Guide_Images/3_Metacarpal/Metacarpal_I/Digital/Slide5.PNG

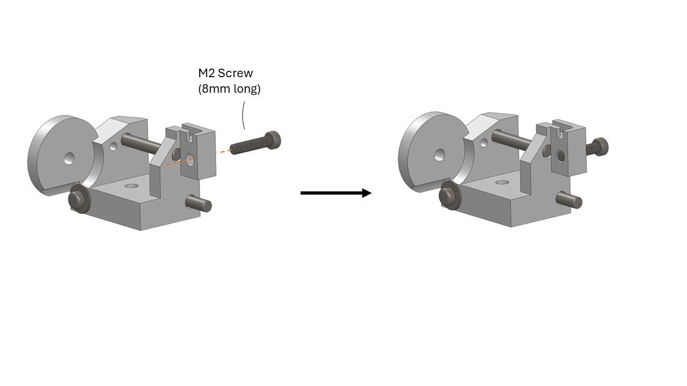
BuildingInstructions/Guide_Images/3_Metacarpal/Metacarpal_I/Digital/Slide5.PNG
