ClemenceSul/FALCON_Hand/BuildingInstructions/Guide_Images/3_Metacarpal/MetacarpalBranch/Digital/Slide1.PNG

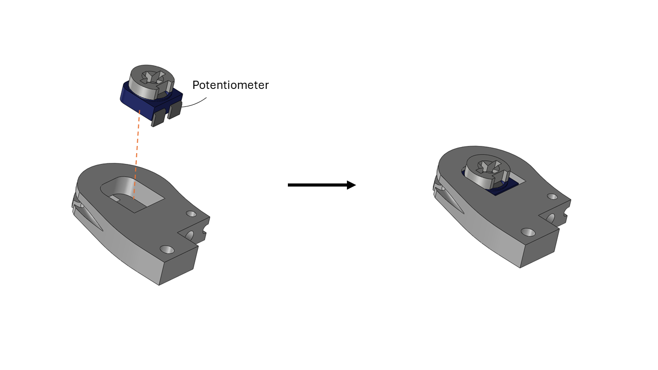
BuildingInstructions/Guide_Images/3_Metacarpal/MetacarpalBranch/Digital/Slide1.PNG
