ClemenceSul/FALCON_Hand/BuildingInstructions/Guide_Images/3_Metacarpal/MetacarpalBranch_I/Digital/MetacarpalBranchDOC.png

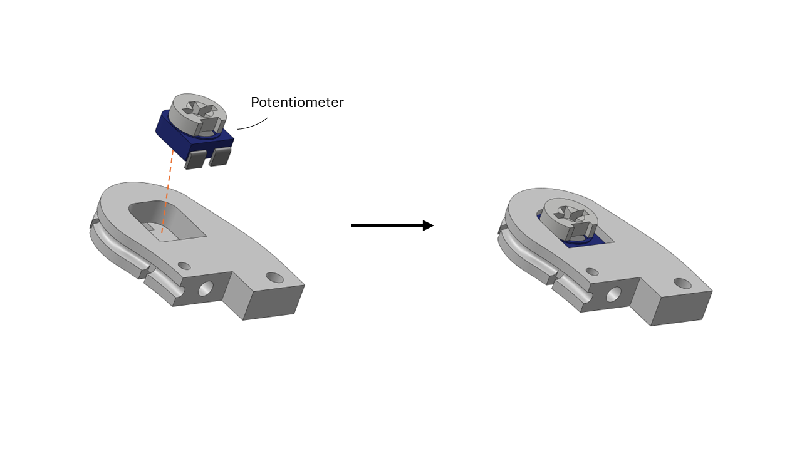
BuildingInstructions/Guide_Images/3_Metacarpal/MetacarpalBranch_I/Digital/MetacarpalBranchDOC.png
