ClemenceSul/FALCON_Hand/BuildingInstructions/Guide_Images/3_Metacarpal/MetacarpalBranch_I/Real/Slide2.PNG

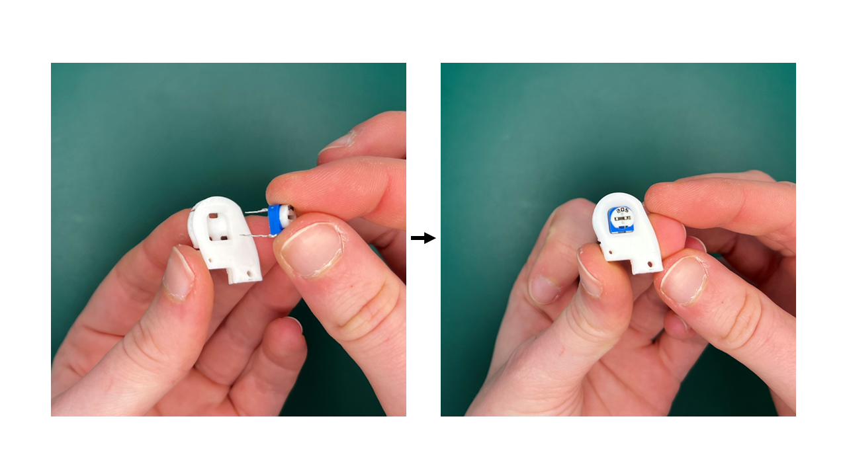
BuildingInstructions/Guide_Images/3_Metacarpal/MetacarpalBranch_I/Real/Slide2.PNG
