ClemenceSul/FALCON_Hand/BuildingInstructions/Guide_Images/4_Wiring/Finger/Slide1.PNG

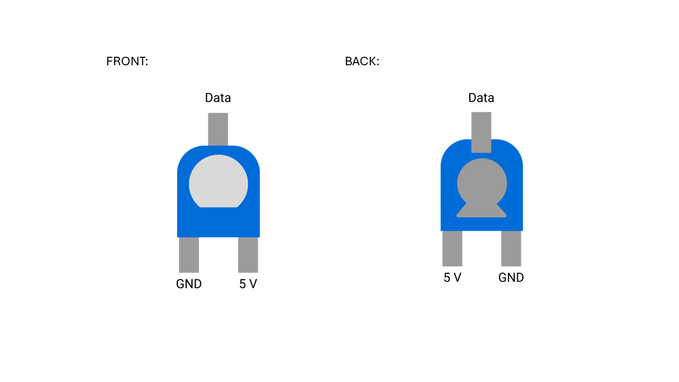
BuildingInstructions/Guide_Images/4_Wiring/Finger/Slide1.PNG
