ClemenceSul/FALCON_Hand/BuildingInstructions/Guide_Images/4_Wiring/Finger/Slide6.PNG

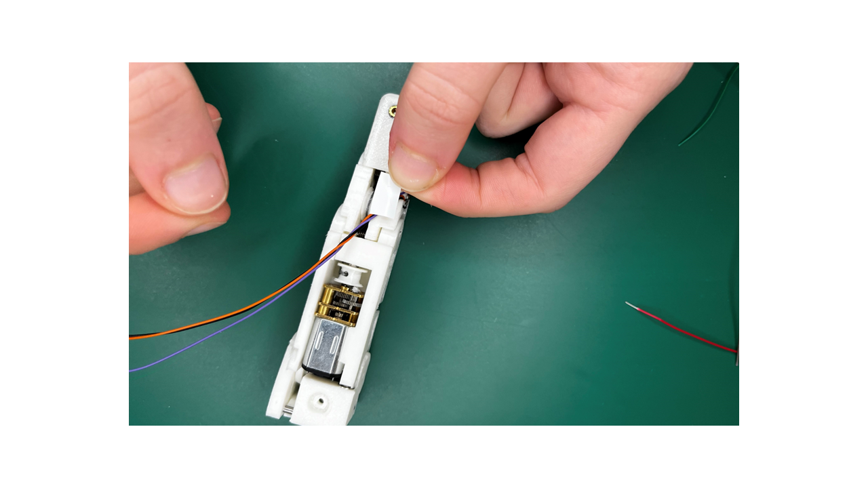
BuildingInstructions/Guide_Images/4_Wiring/Finger/Slide6.PNG
