ClemenceSul/FALCON_Hand/BuildingInstructions/Guide_Images/4_Wiring/Finger/Slide9.PNG

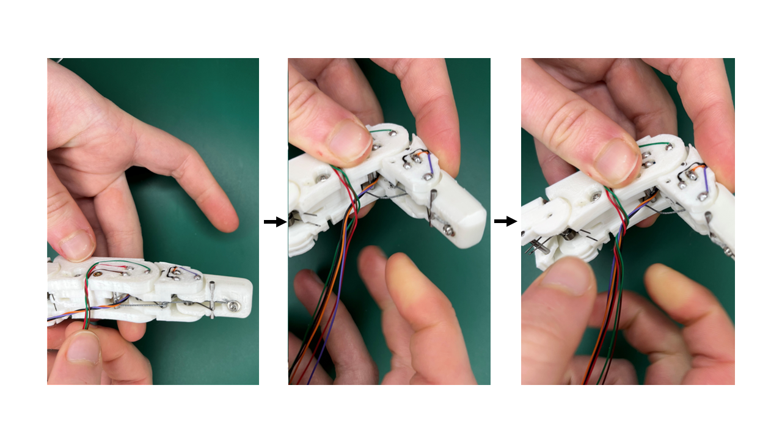
BuildingInstructions/Guide_Images/4_Wiring/Finger/Slide9.PNG
