ClemenceSul/FALCON_Hand/BuildingInstructions/Guide_Images/5_Thumb/1_CMC/Prepare/Frame5.png

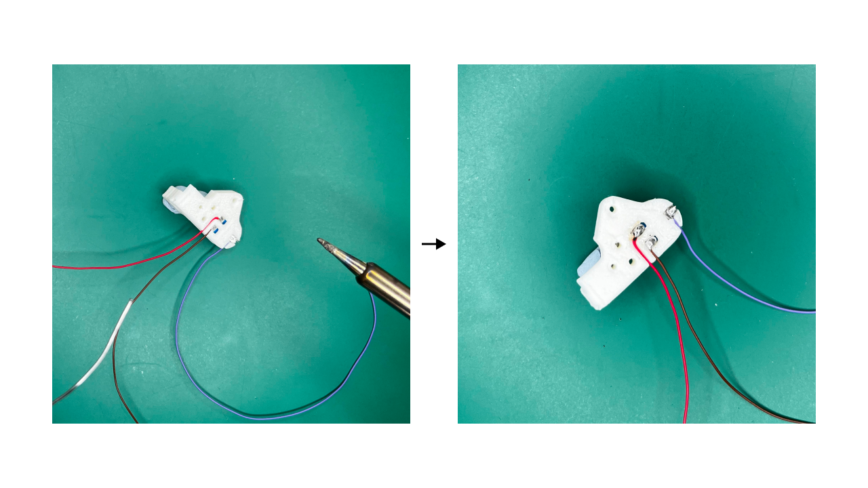
BuildingInstructions/Guide_Images/5_Thumb/1_CMC/Prepare/Frame5.png
