ClemenceSul/FALCON_Hand/BuildingInstructions/Guide_Images/5_Thumb/1_CMC/Prepare/Frame7.png

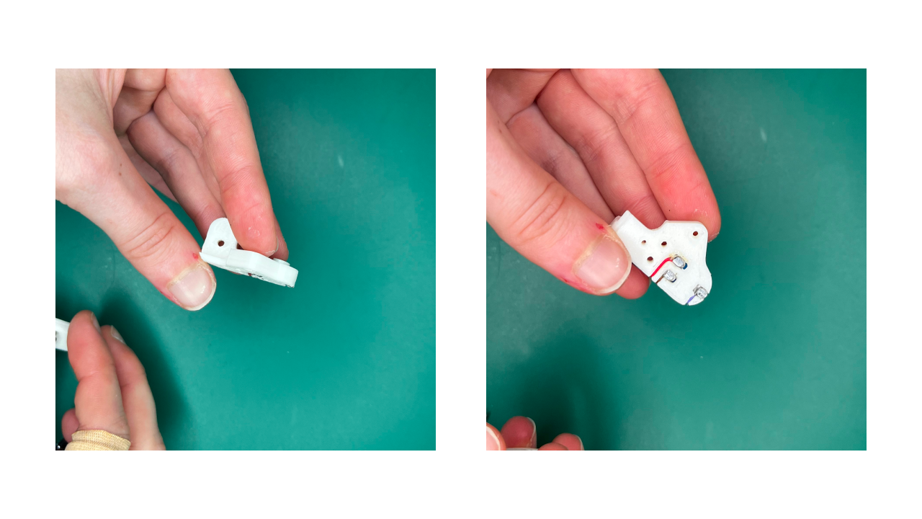
BuildingInstructions/Guide_Images/5_Thumb/1_CMC/Prepare/Frame7.png
