ClemenceSul/FALCON_Hand/BuildingInstructions/Guide_Images/5_Thumb/3_Tendon/Frame12.png

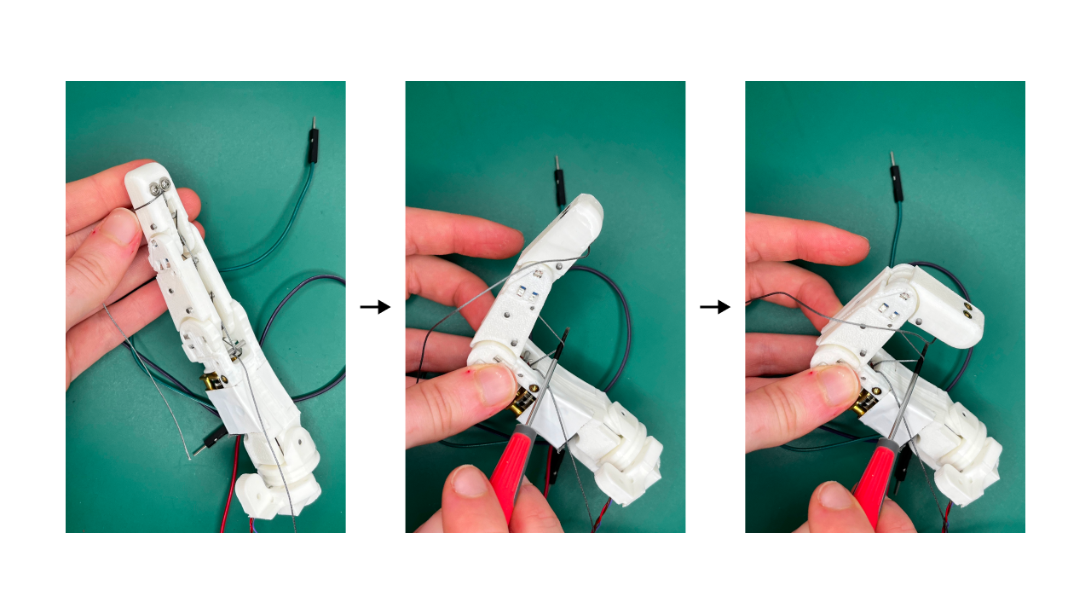
BuildingInstructions/Guide_Images/5_Thumb/3_Tendon/Frame12.png
