ClemenceSul/FALCON_Hand/BuildingInstructions/Guide_Images/5_Thumb/4_Wiring/Frame12.png

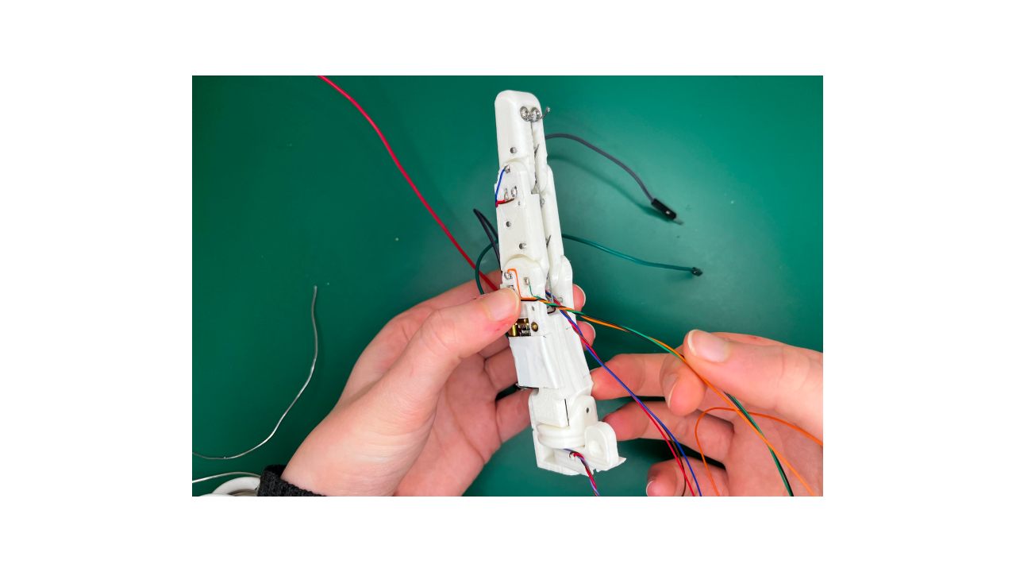
BuildingInstructions/Guide_Images/5_Thumb/4_Wiring/Frame12.png
