ClemenceSul/FALCON_Hand/BuildingInstructions/Guide_Images/5_Thumb/5_Padding/Frame8.png

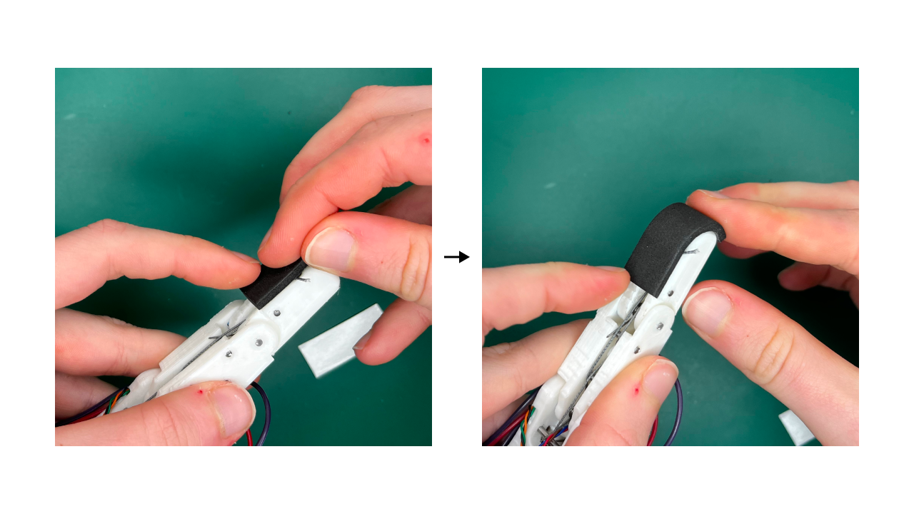
BuildingInstructions/Guide_Images/5_Thumb/5_Padding/Frame8.png
