ClemenceSul/FALCON_Hand/BuildingInstructions/Guide_Images/5_Thumb/5_Padding/Frame9.png

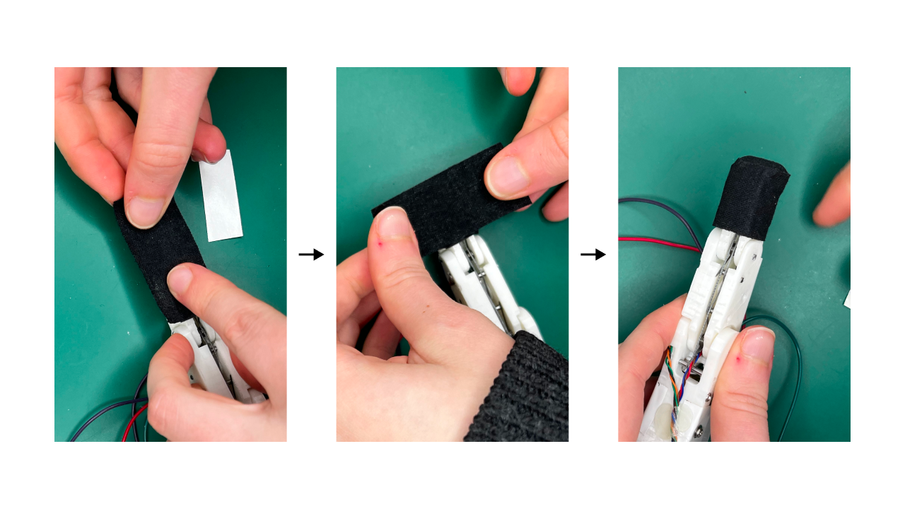
BuildingInstructions/Guide_Images/5_Thumb/5_Padding/Frame9.png
