ClemenceSul/FALCON_Hand/BuildingInstructions/Guide_Images/6_Palm/ADC_Block/Frame1.png

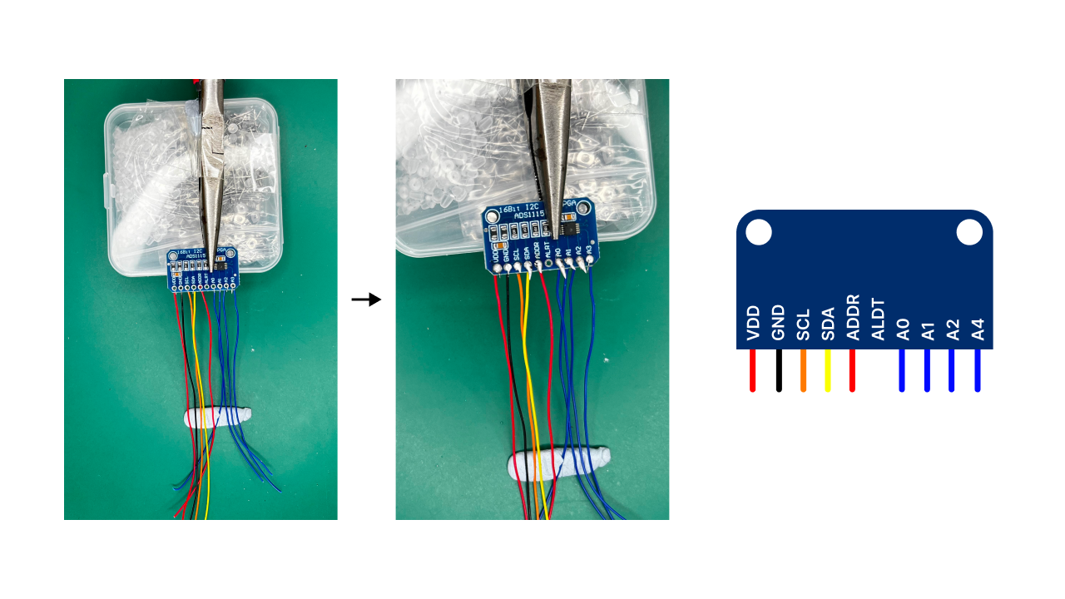
BuildingInstructions/Guide_Images/6_Palm/ADC_Block/Frame1.png
