ClemenceSul/FALCON_Hand/BuildingInstructions/Guide_Images/6_Palm/ADC_Block/Frame9.png

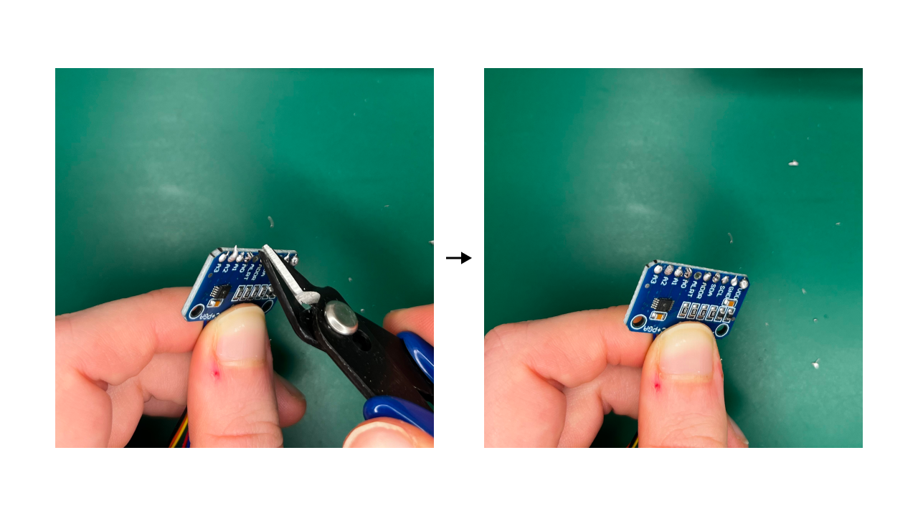
BuildingInstructions/Guide_Images/6_Palm/ADC_Block/Frame9.png
