ClemenceSul/FALCON_Hand/BuildingInstructions/Guide_Images/6_Palm/ADC_Block/Frame18.png

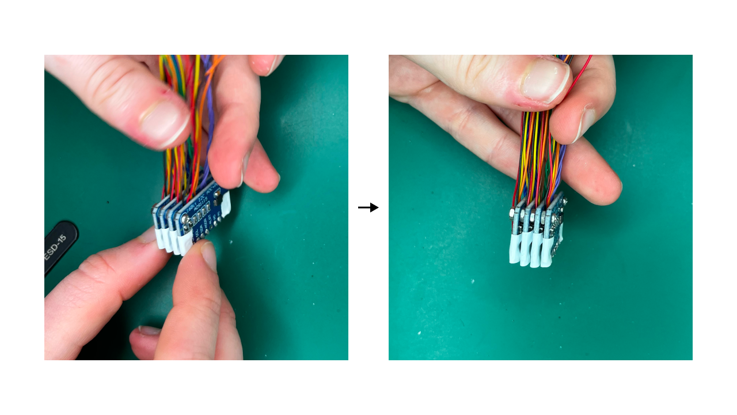
BuildingInstructions/Guide_Images/6_Palm/ADC_Block/Frame18.png
