ClemenceSul/FALCON_Hand/BuildingInstructions/Guide_Images/6_Palm/AddFingers/4.png

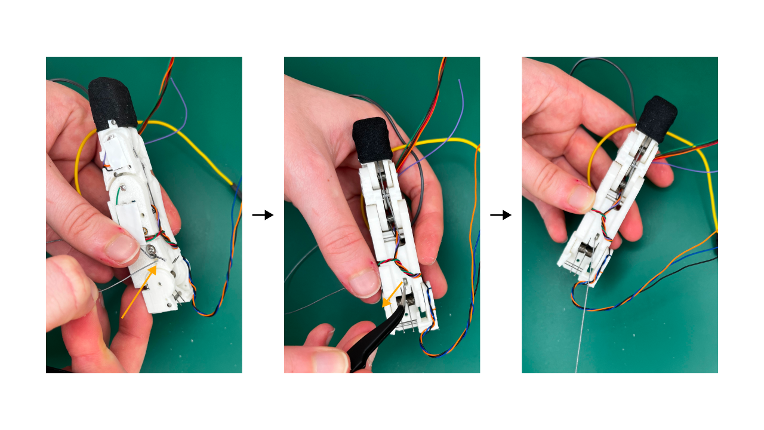
BuildingInstructions/Guide_Images/6_Palm/AddFingers/4.png
