ClemenceSul/FALCON_Hand/BuildingInstructions/Guide_Images/6_Palm/AddFingers/13.png

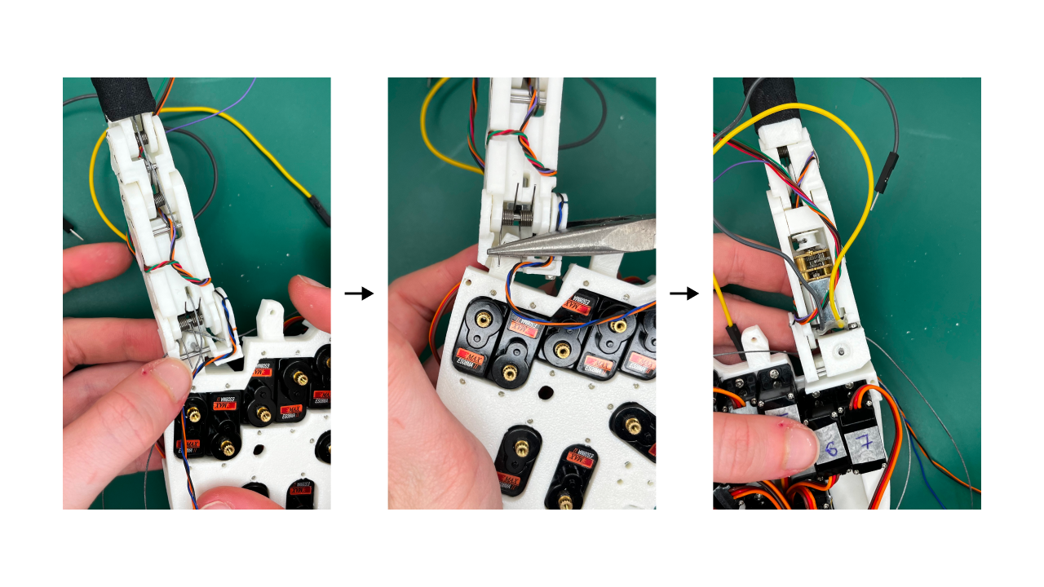
BuildingInstructions/Guide_Images/6_Palm/AddFingers/13.png
