ClemenceSul/FALCON_Hand/BuildingInstructions/Guide_Images/6_Palm/AddFingers/17.png

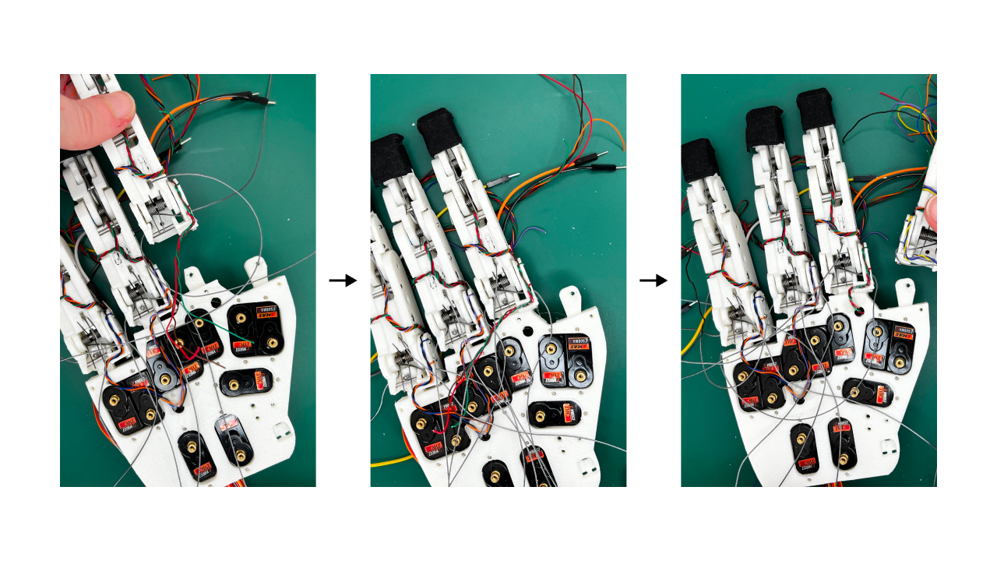
BuildingInstructions/Guide_Images/6_Palm/AddFingers/17.png
