ClemenceSul/FALCON_Hand/BuildingInstructions/Guide_Images/6_Palm/AddFingers/19.png

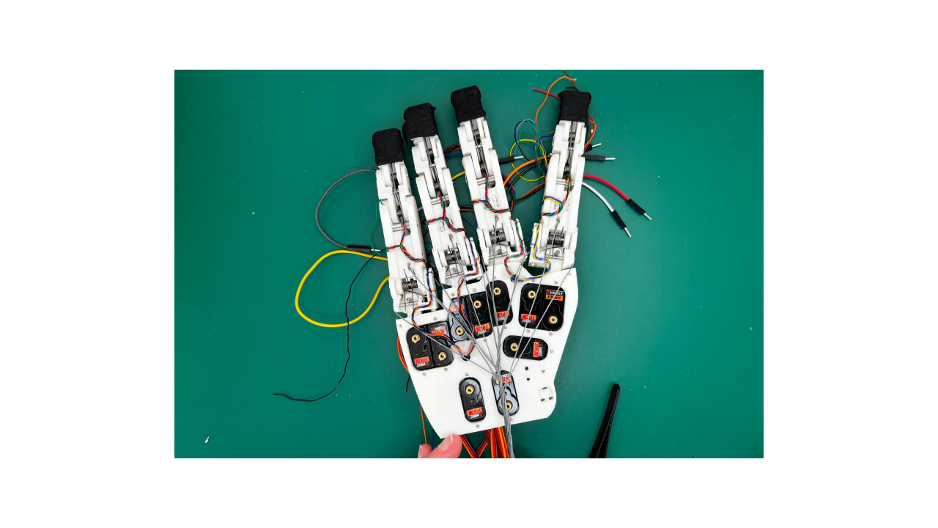
BuildingInstructions/Guide_Images/6_Palm/AddFingers/19.png
