ClemenceSul/FALCON_Hand/BuildingInstructions/Guide_Images/6_Palm/Assembly/Slide8.PNG

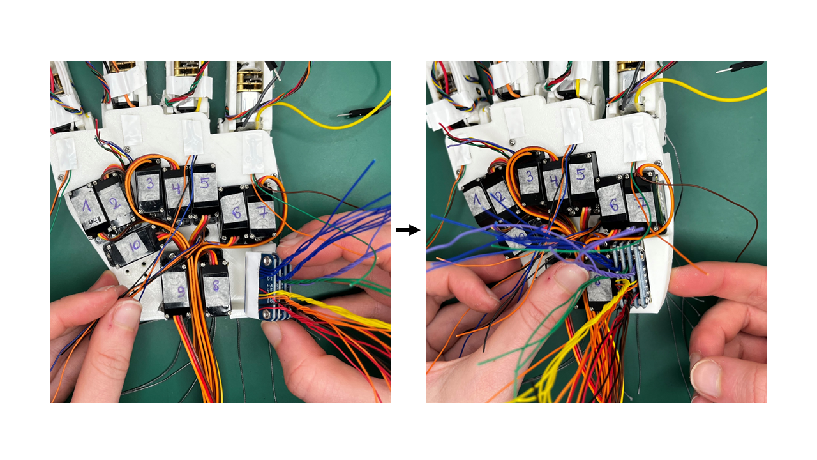
BuildingInstructions/Guide_Images/6_Palm/Assembly/Slide8.PNG
