ClemenceSul/FALCON_Hand/BuildingInstructions/Guide_Images/6_Palm/Assembly/Slide11.PNG

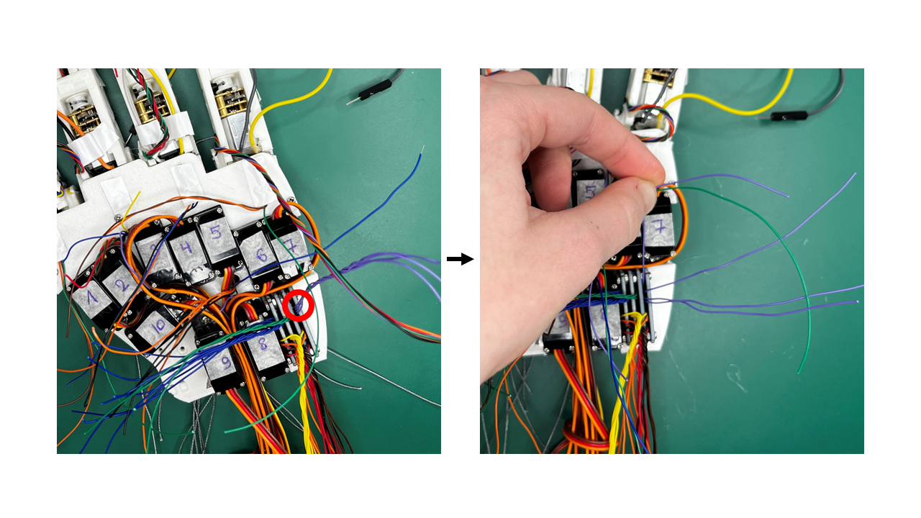
BuildingInstructions/Guide_Images/6_Palm/Assembly/Slide11.PNG
