ClemenceSul/FALCON_Hand/BuildingInstructions/Guide_Images/6_Palm/Assembly/Slide12.PNG

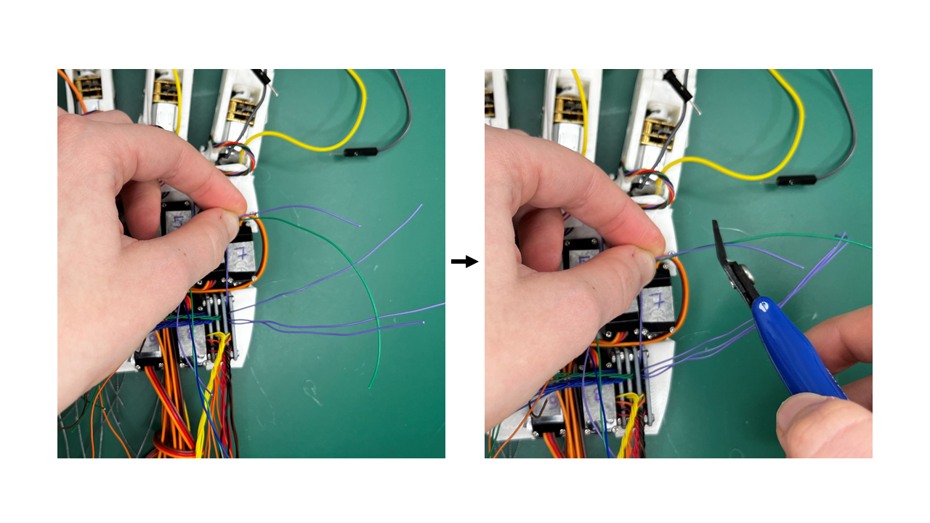
BuildingInstructions/Guide_Images/6_Palm/Assembly/Slide12.PNG
