ClemenceSul/FALCON_Hand/BuildingInstructions/Guide_Images/6_Palm/Assembly/Slide13.PNG

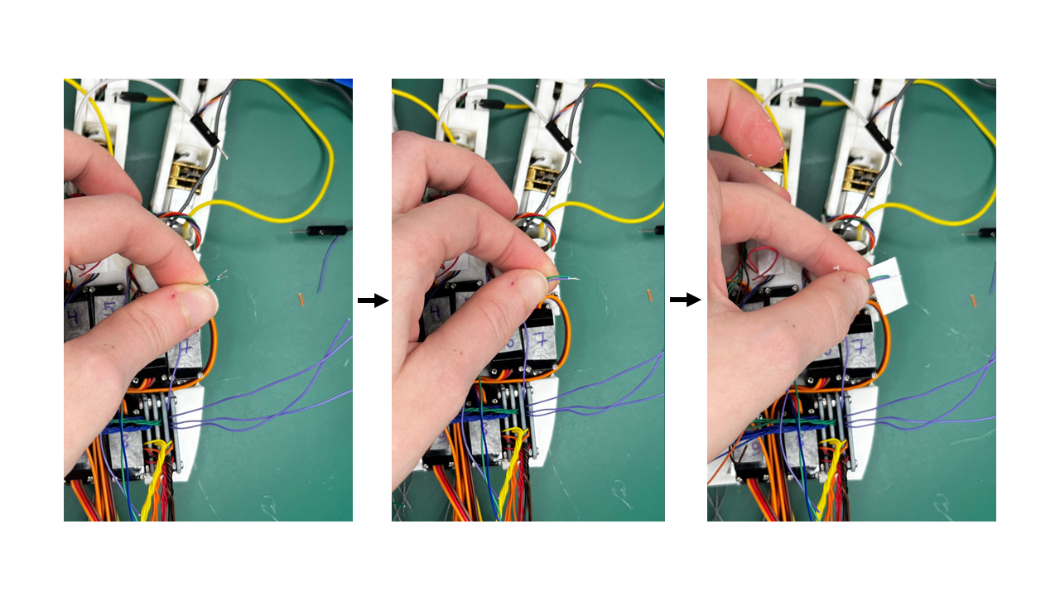
BuildingInstructions/Guide_Images/6_Palm/Assembly/Slide13.PNG
