ClemenceSul/FALCON_Hand/BuildingInstructions/Guide_Images/6_Palm/Assembly/Slide14.PNG

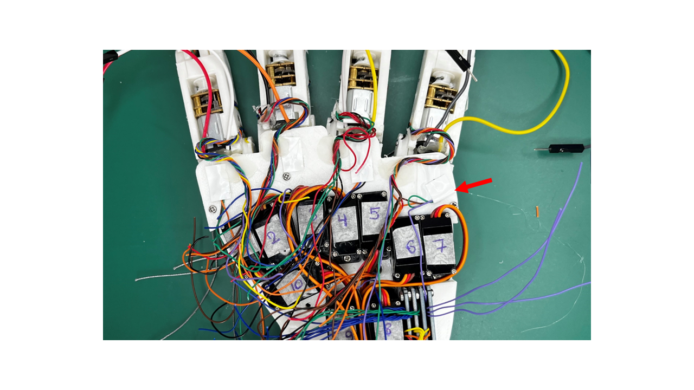
BuildingInstructions/Guide_Images/6_Palm/Assembly/Slide14.PNG
