ClemenceSul/FALCON_Hand/BuildingInstructions/Guide_Images/6_Palm/Assembly/Slide16.PNG

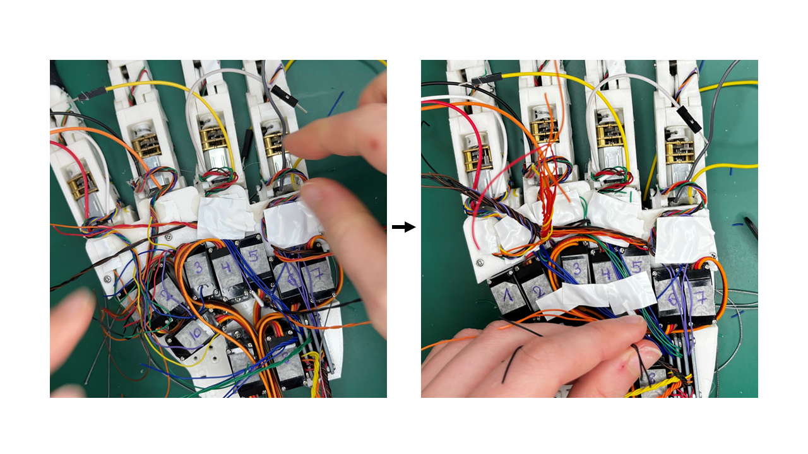
BuildingInstructions/Guide_Images/6_Palm/Assembly/Slide16.PNG
