ClemenceSul/FALCON_Hand/BuildingInstructions/Guide_Images/6_Palm/Assembly/Slide20.PNG

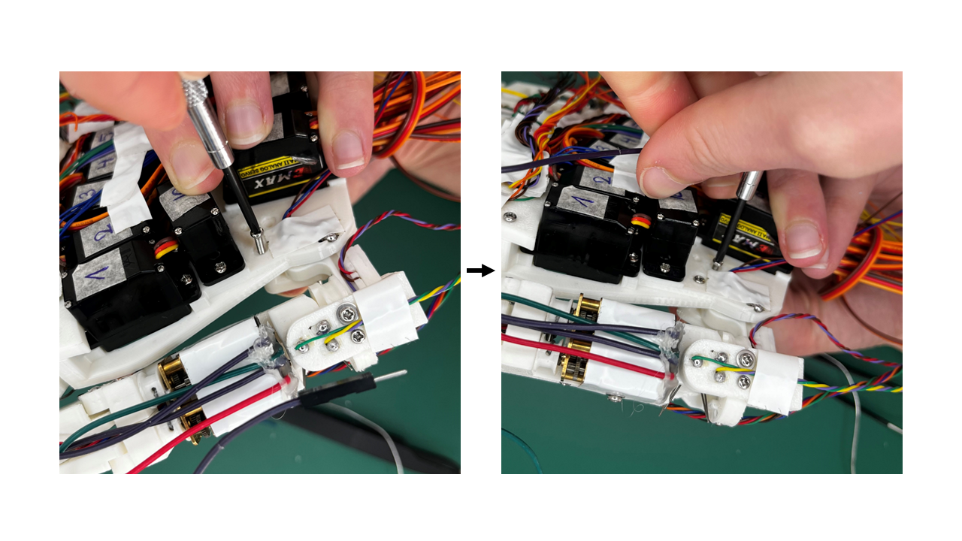
BuildingInstructions/Guide_Images/6_Palm/Assembly/Slide20.PNG
