ClemenceSul/FALCON_Hand/BuildingInstructions/Guide_Images/6_Palm/Assembly/Slide23.PNG

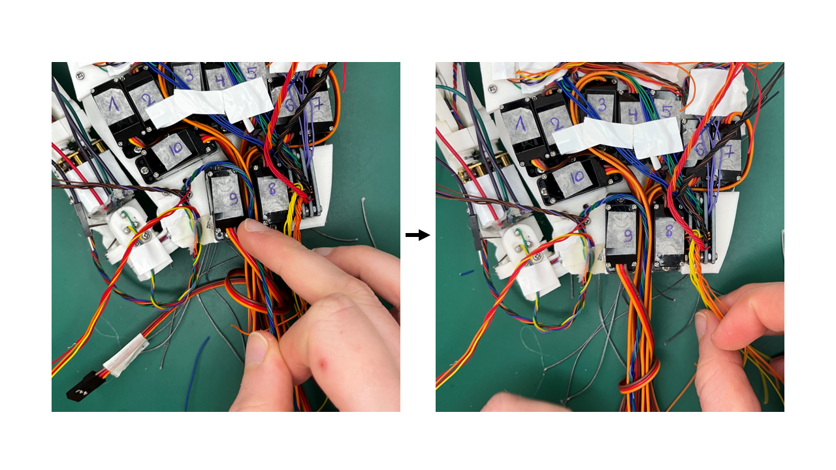
BuildingInstructions/Guide_Images/6_Palm/Assembly/Slide23.PNG
