ClemenceSul/FALCON_Hand/BuildingInstructions/Guide_Images/6_Palm/Assembly/Slide24.PNG

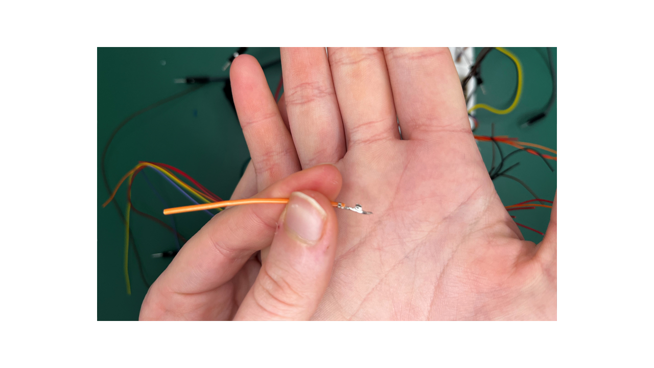
BuildingInstructions/Guide_Images/6_Palm/Assembly/Slide24.PNG
