ClemenceSul/FALCON_Hand/BuildingInstructions/Guide_Images/6_Palm/Assembly/Slide25.PNG

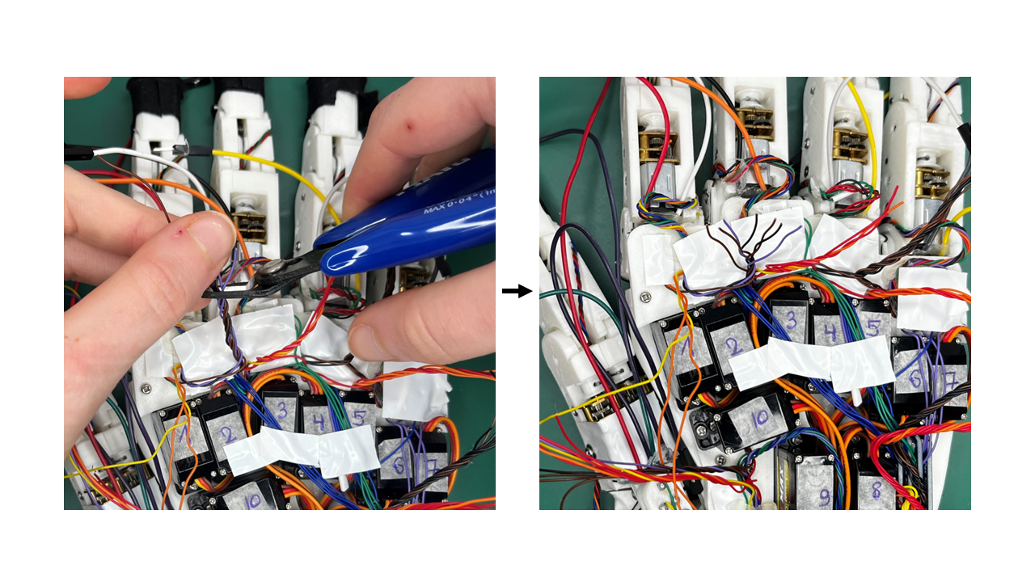
BuildingInstructions/Guide_Images/6_Palm/Assembly/Slide25.PNG
