ClemenceSul/FALCON_Hand/BuildingInstructions/Guide_Images/6_Palm/Assembly/Slide30.PNG

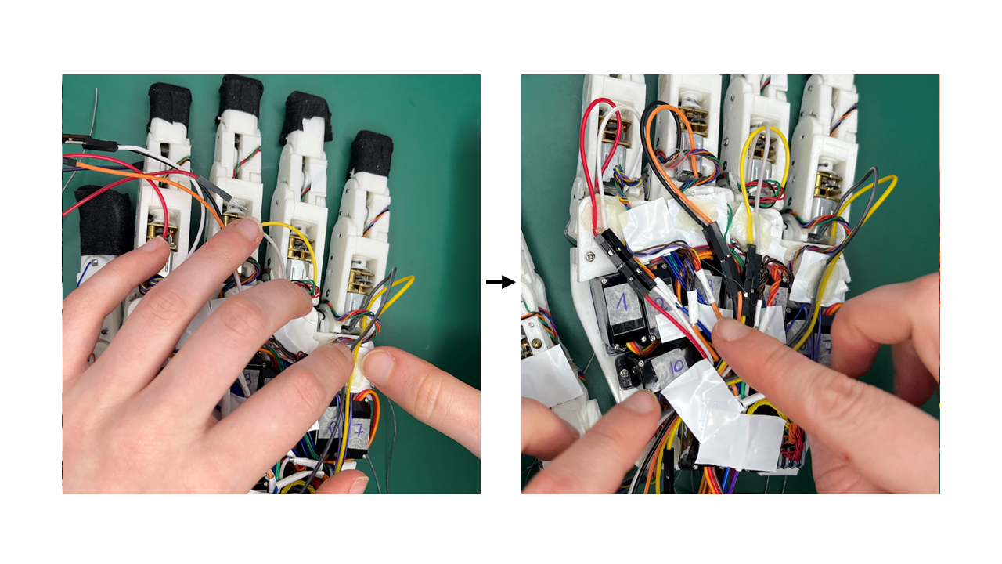
BuildingInstructions/Guide_Images/6_Palm/Assembly/Slide30.PNG
