ClemenceSul/FALCON_Hand/BuildingInstructions/Guide_Images/6_Palm/Assembly/Slide31.PNG

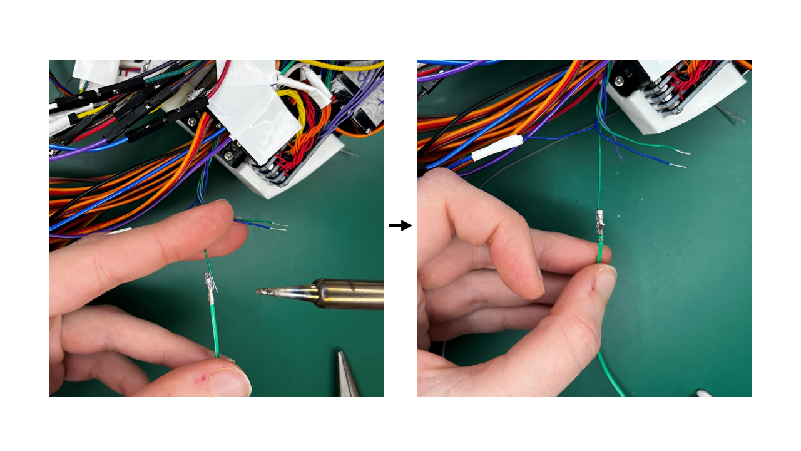
BuildingInstructions/Guide_Images/6_Palm/Assembly/Slide31.PNG
