ClemenceSul/FALCON_Hand/BuildingInstructions/Guide_Images/6_Palm/MCPTendonThumb/Slide2.PNG

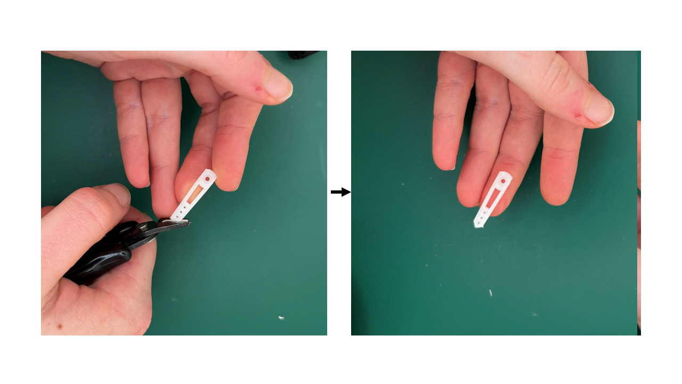
BuildingInstructions/Guide_Images/6_Palm/MCPTendonThumb/Slide2.PNG
