ClemenceSul/FALCON_Hand/BuildingInstructions/Guide_Images/6_Palm/MCPTendonThumb/Slide4.PNG

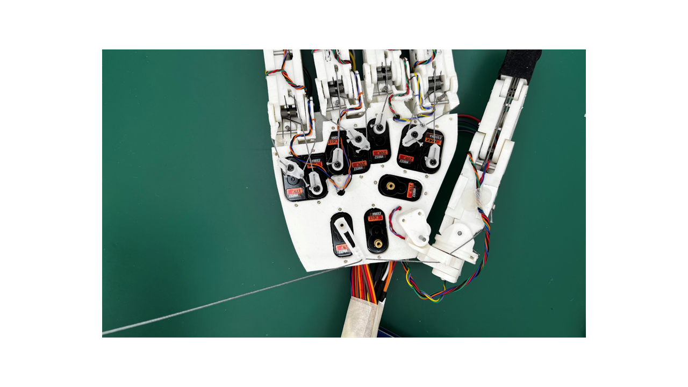
BuildingInstructions/Guide_Images/6_Palm/MCPTendonThumb/Slide4.PNG
