ClemenceSul/FALCON_Hand/BuildingInstructions/Guide_Images/6_Palm/MCPTendonThumb/Slide5.PNG

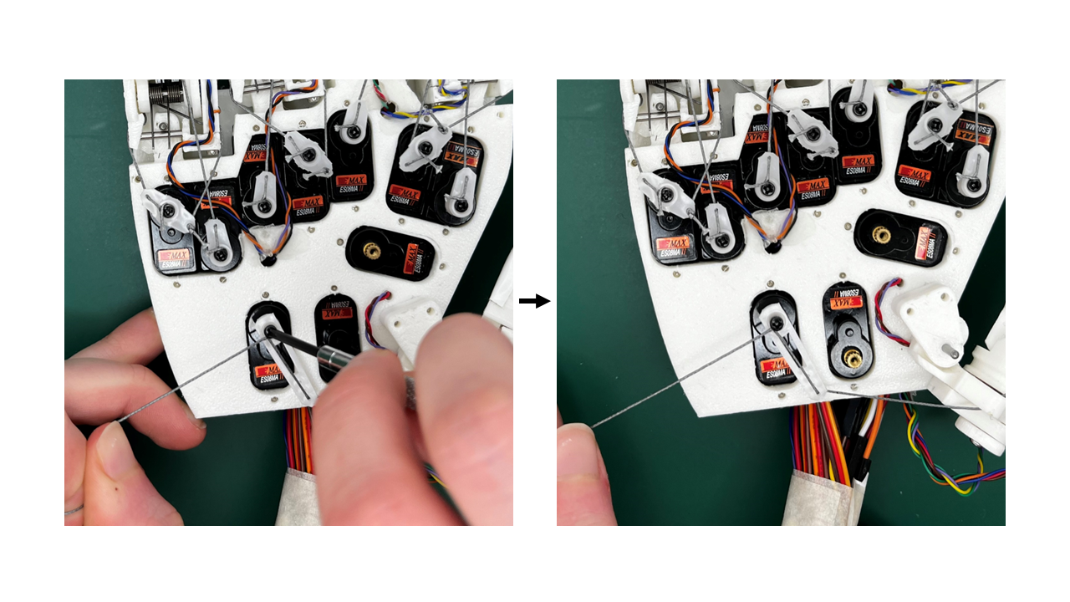
BuildingInstructions/Guide_Images/6_Palm/MCPTendonThumb/Slide5.PNG
