ClemenceSul/FALCON_Hand/BuildingInstructions/Guide_Images/6_Palm/MCPTendonThumb/Slide8.PNG

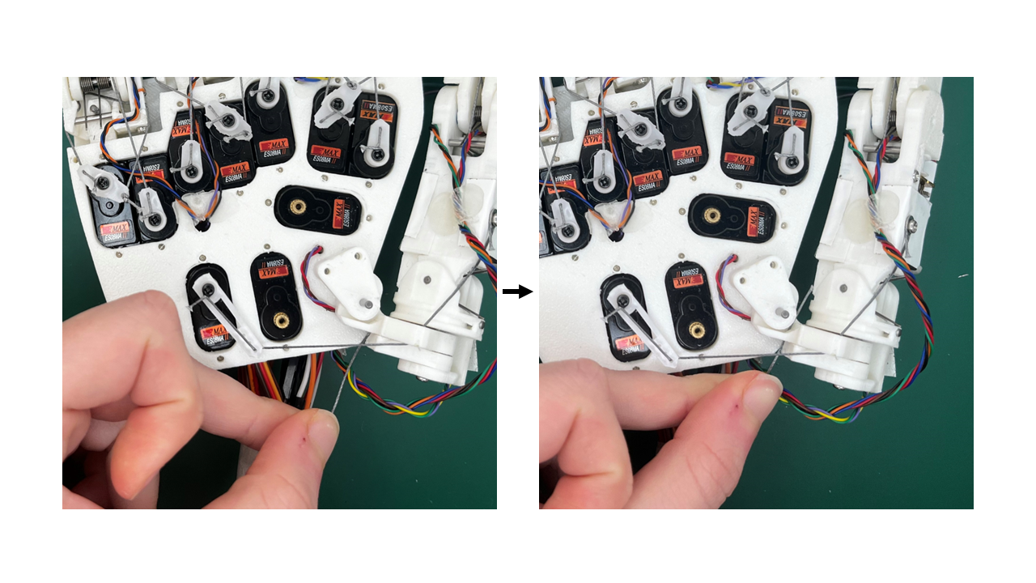
BuildingInstructions/Guide_Images/6_Palm/MCPTendonThumb/Slide8.PNG
