ClemenceSul/FALCON_Hand/BuildingInstructions/Guide_Images/6_Palm/MCPTendonThumb/Slide11.PNG

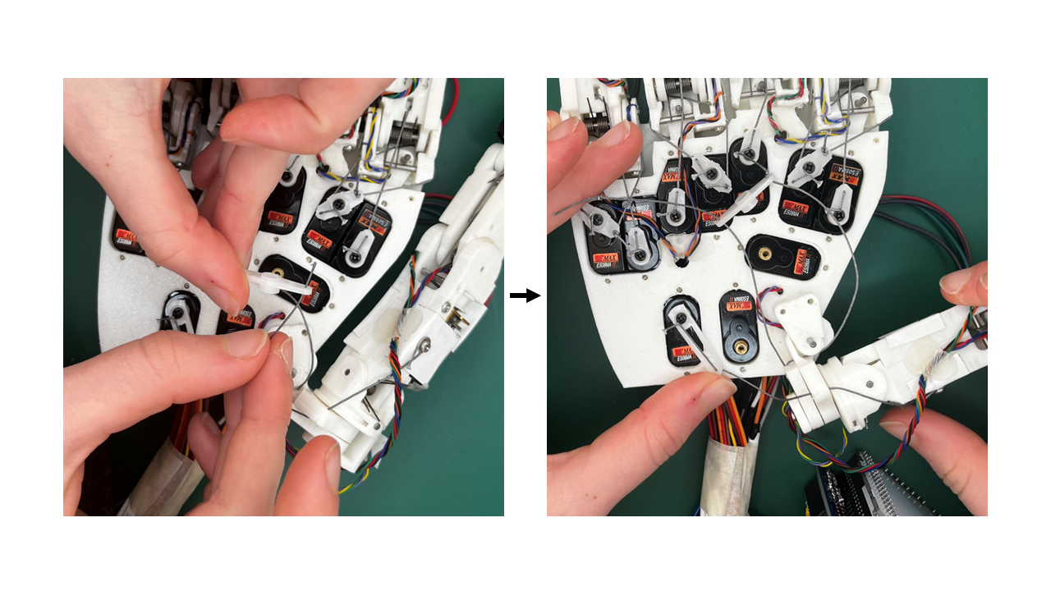
BuildingInstructions/Guide_Images/6_Palm/MCPTendonThumb/Slide11.PNG
