ClemenceSul/FALCON_Hand/BuildingInstructions/Guide_Images/6_Palm/MCPTendonThumb/Slide12.PNG

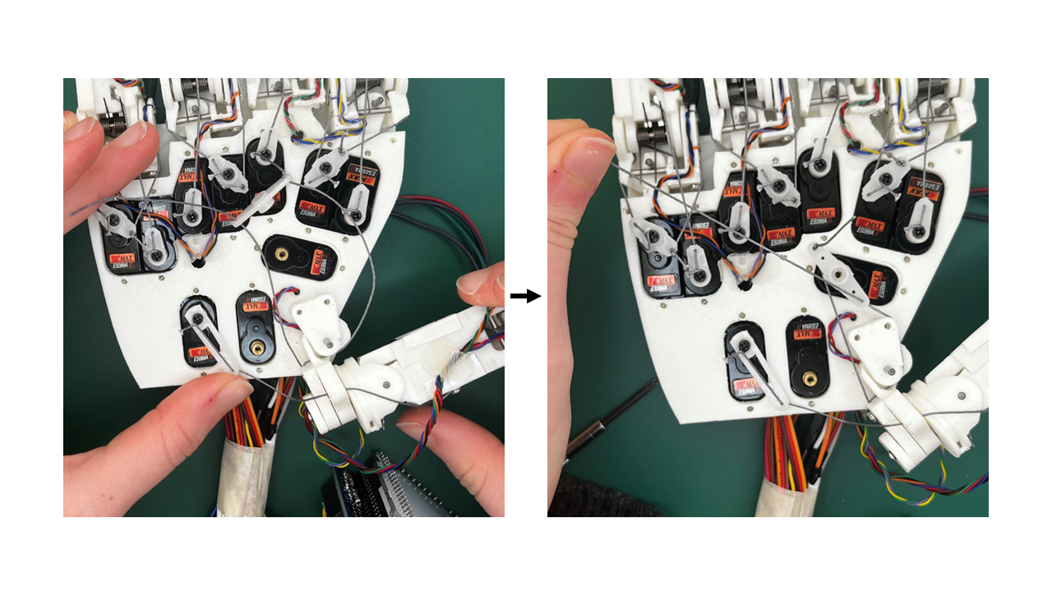
BuildingInstructions/Guide_Images/6_Palm/MCPTendonThumb/Slide12.PNG
