ClemenceSul/FALCON_Hand/BuildingInstructions/Guide_Images/6_Palm/MCPTendonThumb/Slide13.PNG

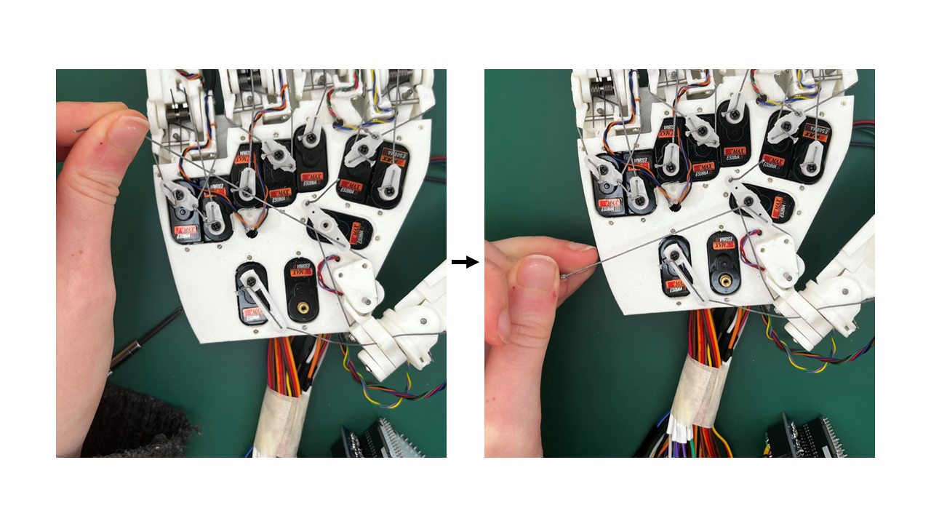
BuildingInstructions/Guide_Images/6_Palm/MCPTendonThumb/Slide13.PNG
