ClemenceSul/FALCON_Hand/BuildingInstructions/Guide_Images/6_Palm/MCPTendonThumb/Slide14.PNG

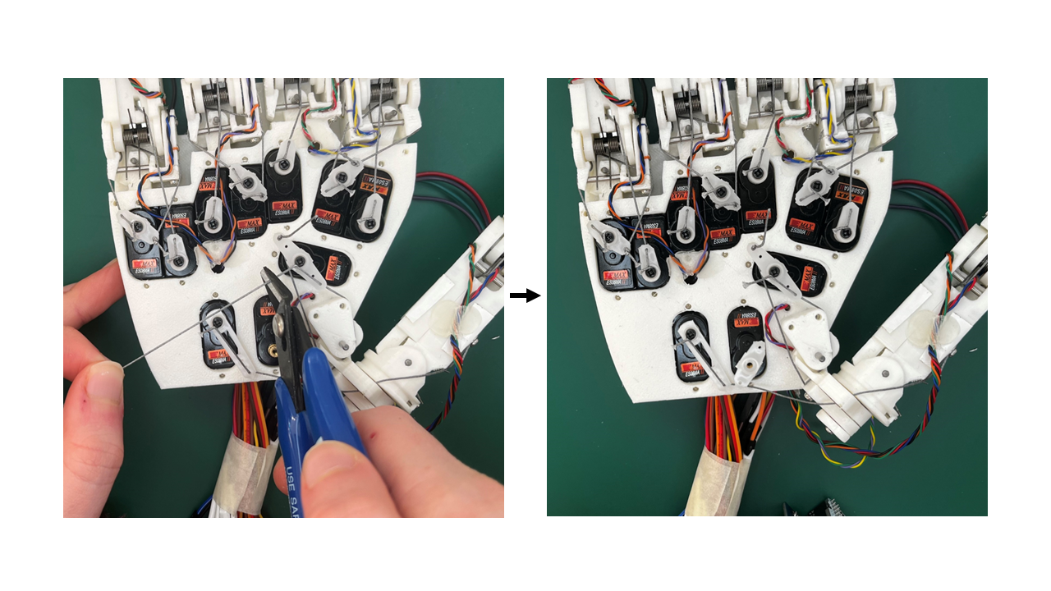
BuildingInstructions/Guide_Images/6_Palm/MCPTendonThumb/Slide14.PNG
