ClemenceSul/FALCON_Hand/BuildingInstructions/Guide_Images/6_Palm/MCPTendonThumb/Slide16.PNG

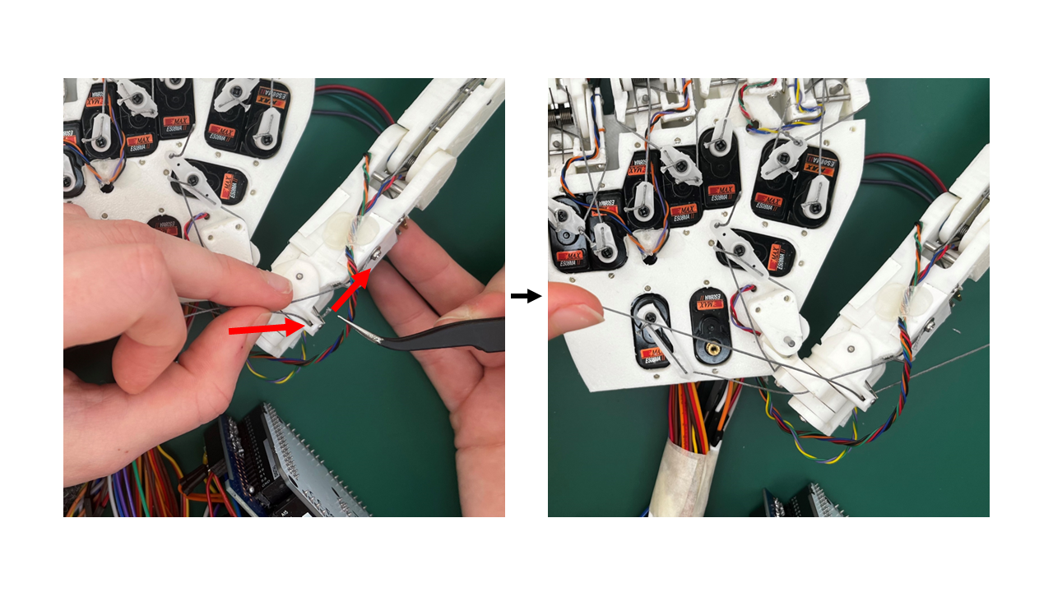
BuildingInstructions/Guide_Images/6_Palm/MCPTendonThumb/Slide16.PNG
