ClemenceSul/FALCON_Hand/BuildingInstructions/Guide_Images/6_Palm/MCPTendonThumb/Slide17.PNG

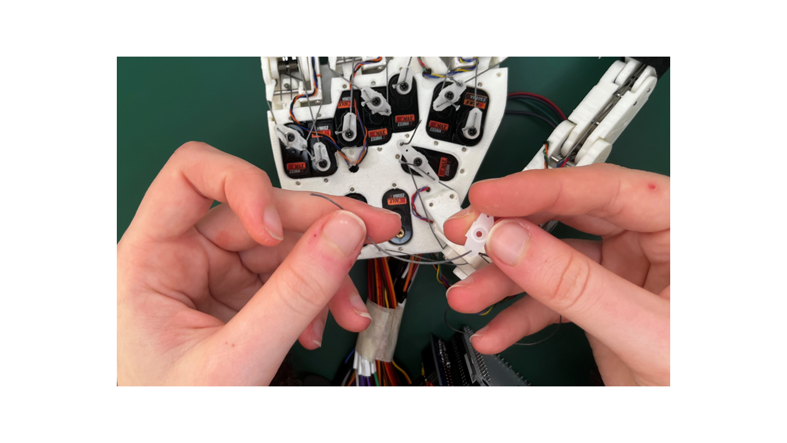
BuildingInstructions/Guide_Images/6_Palm/MCPTendonThumb/Slide17.PNG
