ClemenceSul/FALCON_Hand/BuildingInstructions/Guide_Images/6_Palm/MCPTendonThumb/Slide19.PNG

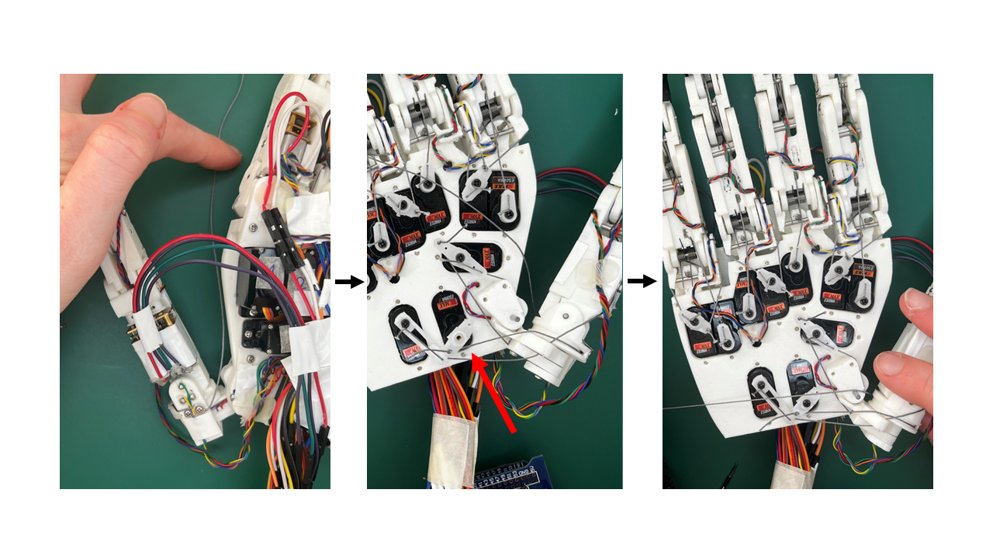
BuildingInstructions/Guide_Images/6_Palm/MCPTendonThumb/Slide19.PNG
