ClemenceSul/FALCON_Hand/BuildingInstructions/Guide_Images/6_Palm/MCPTendonThumb/Slide20.PNG

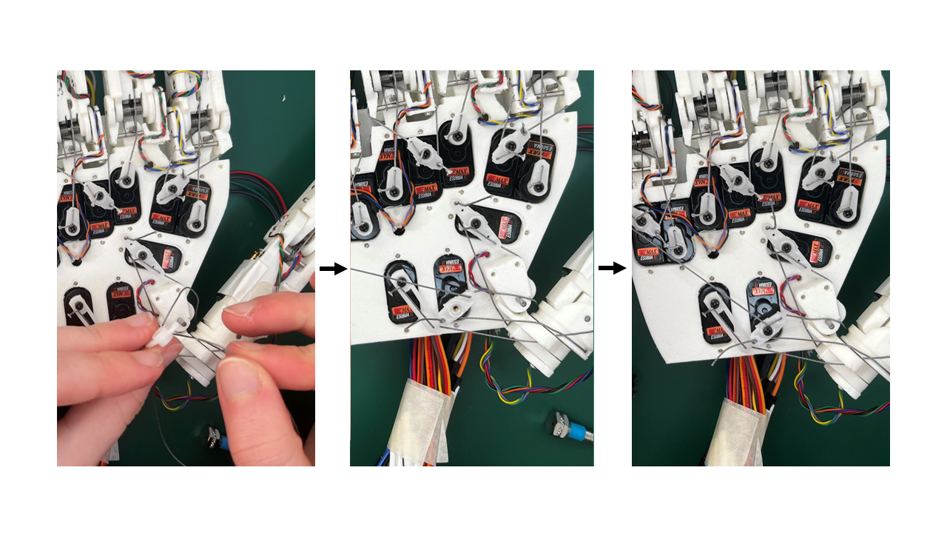
BuildingInstructions/Guide_Images/6_Palm/MCPTendonThumb/Slide20.PNG
