ClemenceSul/FALCON_Hand/BuildingInstructions/Guide_Images/6_Palm/MCPTendonThumb/Slide21.PNG

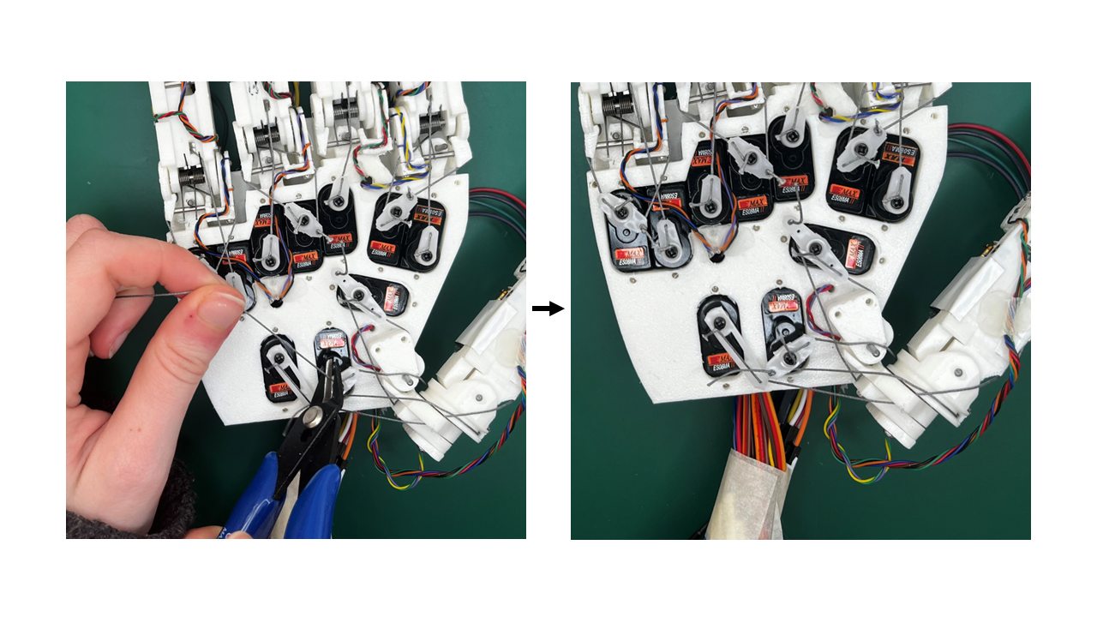
BuildingInstructions/Guide_Images/6_Palm/MCPTendonThumb/Slide21.PNG
