ClemenceSul/FALCON_Hand/BuildingInstructions/Guide_Images/6_Palm/Prepare/Frame8.png

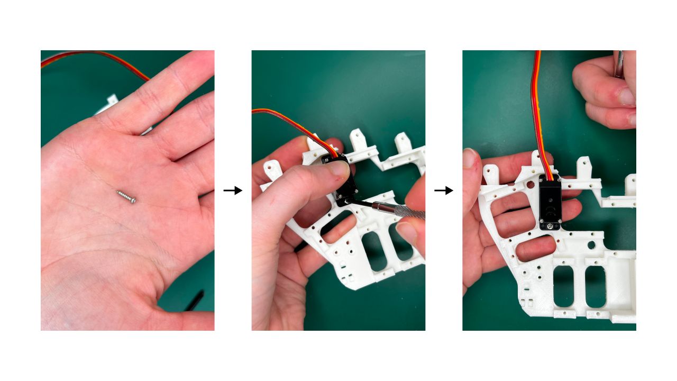
BuildingInstructions/Guide_Images/6_Palm/Prepare/Frame8.png
