ClemenceSul/FALCON_Hand/BuildingInstructions/Guide_Images/6_Palm/Prepare/Frame9.png

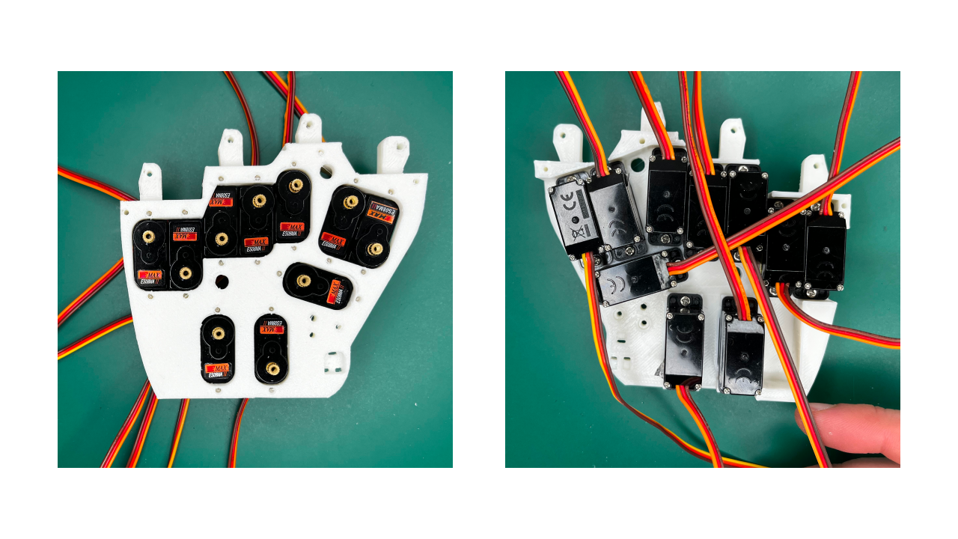
BuildingInstructions/Guide_Images/6_Palm/Prepare/Frame9.png
