ClemenceSul/FALCON_Hand/BuildingInstructions/Guide_Images/6_Palm/Prepare/Frame10.png

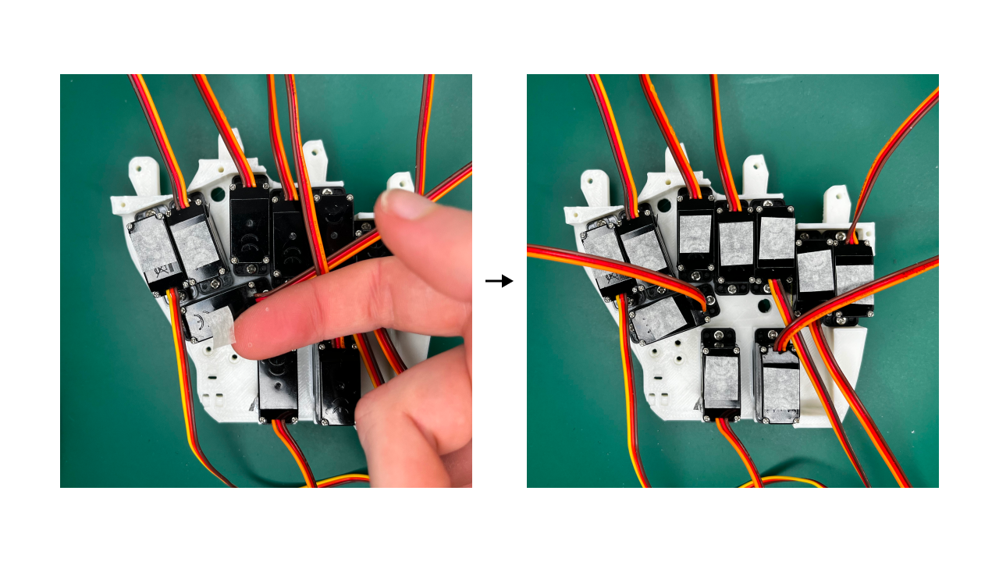
BuildingInstructions/Guide_Images/6_Palm/Prepare/Frame10.png
