ClemenceSul/FALCON_Hand/BuildingInstructions/Guide_Images/6_Palm/Prepare/Frame11.png

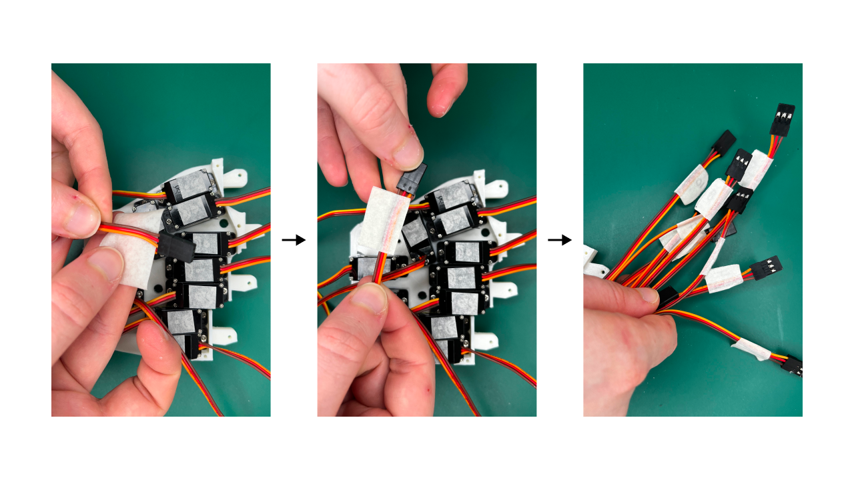
BuildingInstructions/Guide_Images/6_Palm/Prepare/Frame11.png
