ClemenceSul/FALCON_Hand/BuildingInstructions/Guide_Images/6_Palm/Prepare/Frame13.png

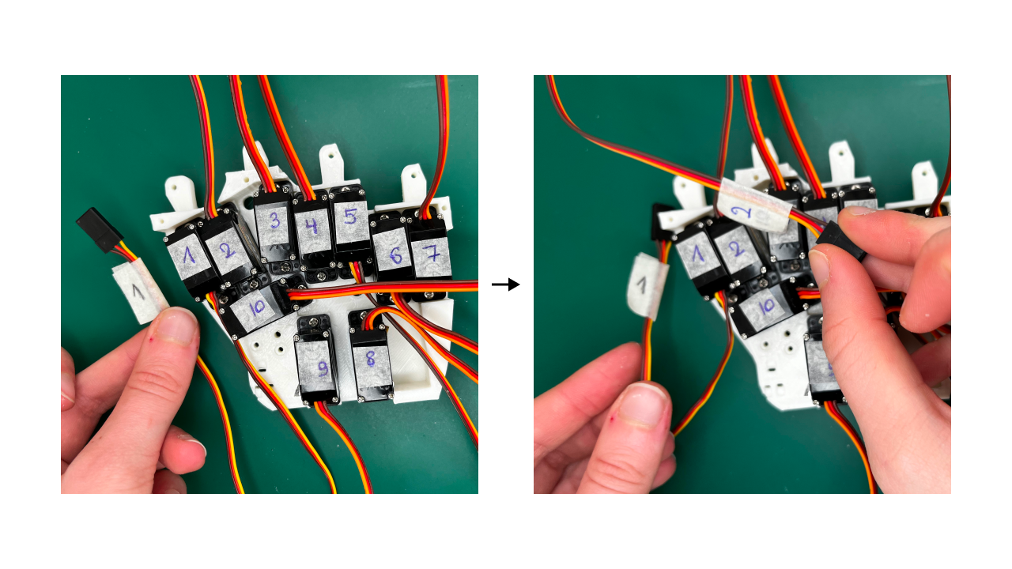
BuildingInstructions/Guide_Images/6_Palm/Prepare/Frame13.png
