ClemenceSul/FALCON_Hand/BuildingInstructions/Guide_Images/not_ready.png

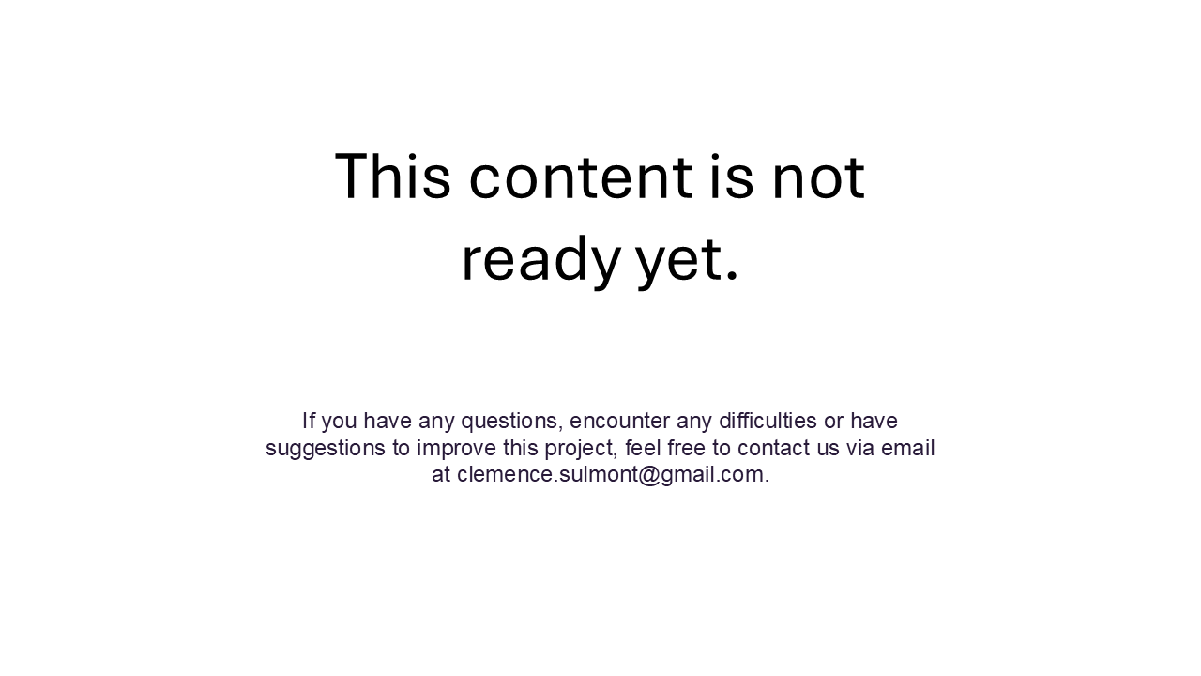
BuildingInstructions/Guide_Images/not_ready.png
