ClemenceSul/FALCON_Hand/BuildingInstructions/Other_Resources/tabs_content.js

/*
This file is part of FALCON_Hand.

FALCON_Hand is licensed under the Creative Commons Attribution-NonCommercial-ShareAlike 4.0 International License.
To view a copy of this license, visit http://creativecommons.org/licenses/by-nc-sa/4.0/. 
*/


const database = {
    "prep": {
        "tab1": {   //fingertip
            "digital": [
                "../Guide_Images/1_PrepPieces/Fingertip/Digital/Slide2.PNG",
                "../Guide_Images/1_PrepPieces/Fingertip/Digital/Slide3.PNG",
                "../Guide_Images/1_PrepPieces/Fingertip/Digital/Slide4.PNG",
                "../Guide_Images/1_PrepPieces/Fingertip/Digital/Slide5.PNG"
            ],
            "real": [
                "../Guide_Images/1_PrepPieces/Fingertip/Real/Slide1.PNG",
                "../Guide_Images/1_PrepPieces/Fingertip/Real/Slide2.PNG",
                "../Guide_Images/1_PrepPieces/Fingertip/Real/Slide3.PNG",
                "../Guide_Images/1_PrepPieces/Fingertip/Real/Slide4.PNG"
            ],
            "text": [
                "File to remove small irregularities.",
                "Add M2 insert as shown in tutorial.",
                "Screw in 8mm long screw with a washer.",
                "Push in a 15mm metal dowel."
            ]
        },
        "tab2": {   //medial right
            "digital": [
                "../Guide_Images/1_PrepPieces/MedialRight/Digital/doc.PNG"
            ],
            "real": [
                "../Guide_Images/1_PrepPieces/MedialRight/Real/Slide5.PNG"
            ],
            "text": ["File to remove small irregularities."]
        },
        "tab3": {   //medial left
            "digital": [
                "../Guide_Images/1_PrepPieces/MedialLeft/Digital/Slide1.PNG",
                "../Guide_Images/1_PrepPieces/MedialLeft/Digital/Slide2.PNG",
                "../Guide_Images/1_PrepPieces/MedialLeft/Digital/Slide3.PNG"
            ],
            "real": [
                "../Guide_Images/1_PrepPieces/MedialLeft/Real/Slide1.PNG",
                "../Guide_Images/1_PrepPieces/MedialLeft/Real/Slide2.PNG",
                "../Guide_Images/1_PrepPieces/MedialLeft/Real/Slide3.PNG"
            ],
            "text": [
                "File to remove small irregularities.",
                "Place potentiometer as shown in tutorial.",
                "Push in both 15mm metal pins."
            ]
        },
        "tab4": {   //proximal right
            "digital": [
                "../Guide_Images/1_PrepPieces/ProximalRight/Digital/Slide1.PNG",
                "../Guide_Images/1_PrepPieces/ProximalRight/Digital/Slide2.PNG",
                "../Guide_Images/1_PrepPieces/ProximalRight/Digital/Slide3.PNG"
            ],
            "real": [
                "../Guide_Images/1_PrepPieces/ProximalRight/Real/Slide1.PNG",
                "../Guide_Images/1_PrepPieces/ProximalRight/Real/Slide2.PNG",
                "../Guide_Images/1_PrepPieces/ProximalRight/Real/Slide3.PNG"
            ],
            "text": [
                "File to remove small irregularities.",
                "Add M2 insert as shown in tutorial.",
                "Screw in 16mm long screw."
            ]
        },
        "tab5": {   //proximal left
            "digital": [
                "../Guide_Images/1_PrepPieces/ProximalLeft/Digital/Slide1.PNG",
                "../Guide_Images/1_PrepPieces/ProximalLeft/Digital/Slide2.PNG",
                "../Guide_Images/1_PrepPieces/ProximalLeft/Digital/Slide3.PNG",
                "../Guide_Images/1_PrepPieces/ProximalLeft/Digital/Slide4.PNG"
            ],
            "real": [
                "../Guide_Images/1_PrepPieces/ProximalLeft/Real/Slide1.PNG",
                "../Guide_Images/1_PrepPieces/ProximalLeft/Real/Slide2.PNG",
                "../Guide_Images/1_PrepPieces/ProximalLeft/Real/Slide3.PNG",
                "../Guide_Images/1_PrepPieces/ProximalLeft/Real/Slide4.PNG"
            ],
            "text": [
                "File to remove small irregularities.",
                "Add M2 insert as shown in tutorial.",
                "Place potentiometer as shown in tutorial.",
                "Screw in 16mm long screw with a washer.",
            ]
        },
        "tab6": {   //pulley
            "digital": [
                "../Guide_Images/1_PrepPieces/Pulley/Digital/Slide4.PNG"
            ],
            "real": [
                "../Guide_Images/1_PrepPieces/Pulley/Real/Slide4.PNG"
            ],
            "text": ["Push bearing in the spool."]
        },
        "tab7": {   //DC motor
            "digital": [
                "../Guide_Images/1_PrepPieces/DCMotor/Digital/Slide1.PNG",
                "../Guide_Images/1_PrepPieces/DCMotor/Digital/Slide2.PNG",
                "../Guide_Images/1_PrepPieces/DCMotor/Digital/Slide3.PNG",
                "../Guide_Images/1_PrepPieces/DCMotor/Digital/Slide4.PNG",
                "../Guide_Images/1_PrepPieces/DCMotor/Digital/Slide5.PNG",
                "../Guide_Images/1_PrepPieces/DCMotor/Digital/Slide6.PNG",
                "../Guide_Images/1_PrepPieces/DCMotor/Digital/Slide7.PNG",
                "../Guide_Images/1_PrepPieces/DCMotor/Digital/Slide8.PNG",
                "../Guide_Images/1_PrepPieces/DCMotor/Digital/Slide9.PNG",
                "../Guide_Images/1_PrepPieces/DCMotor/Digital/Slide10.PNG"
            ],
            "real": [
                "../Guide_Images/1_PrepPieces/DCMotor/Real/Slide1.PNG",
                "../Guide_Images/1_PrepPieces/DCMotor/Real/Slide2.PNG",
                "../Guide_Images/1_PrepPieces/DCMotor/Real/Slide3.PNG",
                "../Guide_Images/1_PrepPieces/DCMotor/Real/Slide4.PNG",
                "../Guide_Images/1_PrepPieces/DCMotor/Real/Slide5.PNG",
                "../Guide_Images/1_PrepPieces/DCMotor/Real/Slide6.PNG",
                "../Guide_Images/1_PrepPieces/DCMotor/Real/Slide7.PNG",
                "../Guide_Images/1_PrepPieces/DCMotor/Real/Slide8.PNG",
                "../Guide_Images/1_PrepPieces/DCMotor/Real/Slide9.PNG",
                "../Guide_Images/1_PrepPieces/DCMotor/Real/Slide10.PNG"
            ],
            "text": [
                "Cut the tendon to obtain a 25cmm long piece.",
                "Thread tendon into the motor spool from the side hole. Be aware of the direction it should come out of.",
                "Holding both sides of the tendon, push it onto the motor shaft, aligning the flat surfaces.",
                "Pull the thread coming out the bottom to have roughly 8cm.",
                "Make a loop.",
                "Pass the tendon around the motor shaft and through the loop.",
                "Holding the tendon which comes out the side hole, pull on the other end until you can't anymore.",
                "Now, pull on the tendon coming out of the side hole.",
                "Push the motor spool down.",
                "Cut the excess."
            ]
        }
    }, // DONE
    "I_prep": {
        "tab1": {   //fingertip
            "digital": [
                "../Guide_Images/1_PrepPieces/Fingertip/Digital/Slide2.PNG",
                "../Guide_Images/1_PrepPieces/Fingertip/Digital/Slide3.PNG",
                "../Guide_Images/1_PrepPieces/Fingertip/Digital/Slide4.PNG",
                "../Guide_Images/1_PrepPieces/Fingertip/Digital/Slide5.PNG"
            ],
            "real": [
                "../Guide_Images/1_PrepPieces/Fingertip/Real/Slide1.PNG",
                "../Guide_Images/1_PrepPieces/Fingertip/Real/Slide2.PNG",
                "../Guide_Images/1_PrepPieces/Fingertip/Real/Slide3.PNG",
                "../Guide_Images/1_PrepPieces/Fingertip/Real/Slide4.PNG"
            ],
            "text": [
                "File to remove small irregularities.",
                "Add M2 insert as shown in tutorial.",
                "Screw in 8mm long screw with a washer.",
                "Push in a 15mm metal dowel."
            ]
        },
        "tab2": {   //medial right
            "digital": [
                "../Guide_Images/1_PrepPieces/MedialRight/Digital/doc.PNG"
            ],
            "real": [
                "../Guide_Images/1_PrepPieces/MedialRight/Real/Slide5.PNG"
            ],
            "text": ["File to remove small irregularities."]
        },
        "tab3": {   //medial left
            "digital": [
                "../Guide_Images/1_PrepPieces/MedialLeft/Digital/Slide1.PNG",
                "../Guide_Images/1_PrepPieces/MedialLeft/Digital/Slide2.PNG",
                "../Guide_Images/1_PrepPieces/MedialLeft/Digital/Slide3.PNG"
            ],
            "real": [
                "../Guide_Images/1_PrepPieces/MedialLeft/Real/Slide1.PNG",
                "../Guide_Images/1_PrepPieces/MedialLeft/Real/Slide2.PNG",
                "../Guide_Images/1_PrepPieces/MedialLeft/Real/Slide3.PNG"
            ],
            "text": [
                "File to remove small irregularities.",
                "Place potentiometer as shown in tutorial.",
                "Push in both 15mm metal pins."
            ]
        },
        "tab4": {   //proximal right
            "digital": [
                "../Guide_Images/1_PrepPieces/ProximalRight_I/Digital/Slide1.PNG",
                "../Guide_Images/1_PrepPieces/ProximalRight_I/Digital/Slide2.PNG",
                "../Guide_Images/1_PrepPieces/ProximalRight_I/Digital/Slide3.PNG"
            ],
            "real": [
                "../Guide_Images/1_PrepPieces/ProximalRight_I/Real/Slide1.PNG",
                "../Guide_Images/1_PrepPieces/ProximalRight_I/Real/Slide2.PNG",
                "../Guide_Images/1_PrepPieces/ProximalRight_I/Real/Slide3.PNG"
            ],
            "text": [
                "File to remove small irregularities.",
                "Place potentiometer as shown in tutorial.",
                "Add two M2 insert as shown in tutorial."
            ]
        },
        "tab5": {   //proximal left
            "digital": [
                "../Guide_Images/1_PrepPieces/ProximalLeft_I/Digital/Slide1.PNG",
                "../Guide_Images/1_PrepPieces/ProximalLeft_I/Digital/Slide2.PNG",
                "../Guide_Images/1_PrepPieces/ProximalLeft_I/Digital/Slide3.PNG"
            ],
            "real": [
                "../Guide_Images/1_PrepPieces/ProximalLeft_I/Real/Slide1.PNG",
                "../Guide_Images/1_PrepPieces/ProximalLeft_I/Real/Slide2.PNG",
                "../Guide_Images/1_PrepPieces/ProximalLeft_I/Real/Slide3.PNG"
            ],
            "text": [
                "File to remove small irregularities.",
                "Screw in 16mm long screw.",
                "Screw in 16mm long screw with a washer."
            ]
        },
        "tab6": {   //pulley
            "digital": [
                "../Guide_Images/1_PrepPieces/Pulley/Digital/Slide4.PNG"
            ],
            "real": [
                "../Guide_Images/1_PrepPieces/Pulley/Real/Slide4.PNG"
            ],
            "text": ["Push bearing in the spool."]
        },
        "tab7": {   //DC motor
            "digital": [
                "../Guide_Images/1_PrepPieces/DCMotor/Digital/Slide1.PNG",
                "../Guide_Images/1_PrepPieces/DCMotor/Digital/Slide2.PNG",
                "../Guide_Images/1_PrepPieces/DCMotor/Digital/Slide3.PNG",
                "../Guide_Images/1_PrepPieces/DCMotor/Digital/Slide4.PNG",
                "../Guide_Images/1_PrepPieces/DCMotor/Digital/Slide5.PNG",
                "../Guide_Images/1_PrepPieces/DCMotor/Digital/Slide6.PNG",
                "../Guide_Images/1_PrepPieces/DCMotor/Digital/Slide7.PNG",
                "../Guide_Images/1_PrepPieces/DCMotor/Digital/Slide8.PNG",
                "../Guide_Images/1_PrepPieces/DCMotor/Digital/Slide9.PNG",
                "../Guide_Images/1_PrepPieces/DCMotor/Digital/Slide10.PNG"
            ],
            "real": [
                "../Guide_Images/1_PrepPieces/DCMotor/Real/Slide1.PNG",
                "../Guide_Images/1_PrepPieces/DCMotor/Real/Slide2.PNG",
                "../Guide_Images/1_PrepPieces/DCMotor/Real/Slide3.PNG",
                "../Guide_Images/1_PrepPieces/DCMotor/Real/Slide4.PNG",
                "../Guide_Images/1_PrepPieces/DCMotor/Real/Slide5.PNG",
                "../Guide_Images/1_PrepPieces/DCMotor/Real/Slide6.PNG",
                "../Guide_Images/1_PrepPieces/DCMotor/Real/Slide7.PNG",
                "../Guide_Images/1_PrepPieces/DCMotor/Real/Slide8.PNG",
                "../Guide_Images/1_PrepPieces/DCMotor/Real/Slide9.PNG",
                "../Guide_Images/1_PrepPieces/DCMotor/Real/Slide10.PNG"
            ],
            "text": [
                "Cut the tendon to obtain a 25cmm long piece.",
                "Thread tendon into the motor spool from the side hole. Be aware of the direction it should come out of.",
                "Holding both sides of the tendon, push it onto the motor shaft, aligning the flat surfaces.",
                "Pull the thread coming out the bottom to have roughly 8cm.",
                "Make a loop.",
                "Pass the tendon around the motor shaft and through the loop.",
                "Holding the tendon which comes out the side hole, pull on the other end until you can't anymore.",
                "Now, pull on the tendon coming out of the side hole.",
                "Push the motor spool down.",
                "Cut the excess."
            ]
        }
    }, // DONE
    "T_prep": {
        "tab1": {   //fingertip
            "real": [
                "../Guide_Images/1_PrepPieces/Fingertip_T/Slide1.PNG",
                "../Guide_Images/1_PrepPieces/Fingertip_T/Slide2.PNG",
                "../Guide_Images/1_PrepPieces/Fingertip_T/Slide3.PNG",
                "../Guide_Images/1_PrepPieces/Fingertip_T/Slide4.PNG"
            ],
            "text": [
                "File to remove small irregularities.",
                "Add M2 insert as shown in tutorial.",
                "Screw in 8mm long screw with a washer.",
                "Push in a 15mm metal dowel."
            ]
        }, //DONE
        "tab2": {   //medial right
            "real": [
                "../Guide_Images/1_PrepPieces/MedialRight_T/Slide5.PNG"
            ],
            "text": ["File to remove small irregularities."]
        }, // DONE
        "tab3": {   //medial left
            "real": [
                "../Guide_Images/1_PrepPieces/MedialLeft_T/Slide6.PNG",
                "../Guide_Images/1_PrepPieces/MedialLeft_T/Slide7.PNG",
                "../Guide_Images/1_PrepPieces/MedialLeft_T/Slide8.PNG"
            ],
            "text": [
                "File to remove small irregularities.",
                "Place potentiometer as shown in tutorial.",
                "Push in three 15mm metal pins."
            ]
        }, // DONE
        "tab4": {   //proximal right
            "real": [
                "../Guide_Images/1_PrepPieces/ProximalRight_T/Slide12.PNG",
            ],
            "text": [
                "Place both screws.",
            ]
        }, //DONE
        "tab5": {   //proximal left
            "real": [
                "../Guide_Images/1_PrepPieces/ProximalLeft_T/Slide9.PNG",
                "../Guide_Images/1_PrepPieces/ProximalLeft_T/Slide10.PNG",
                "../Guide_Images/1_PrepPieces/ProximalLeft_T/Slide11.PNG"
            ],
            "text": [
                "Add two M2 inserts as shown in tutorial.",
                "Place a potentiometer as shown in tutorial.",
                "Add a metal pin."
            ]
        }, // DONE
        "tab6": {   //pulley
            "digital": [
                "../Guide_Images/1_PrepPieces/Pulley/Digital/Slide4.PNG"
            ],
            "real": [
                "../Guide_Images/1_PrepPieces/Pulley/Real/Slide4.PNG"
            ],
            "text": ["Push bearing in the spool."]
        }, // DONE
        "tab7": {   //DC motor
            "digital": [
                "../Guide_Images/1_PrepPieces/DCMotor/Digital/Slide1.PNG",
                "../Guide_Images/1_PrepPieces/DCMotor/Digital/Slide2.PNG",
                "../Guide_Images/1_PrepPieces/DCMotor/Digital/Slide3.PNG",
                "../Guide_Images/1_PrepPieces/DCMotor/Digital/Slide4.PNG",
                "../Guide_Images/1_PrepPieces/DCMotor/Digital/Slide5.PNG",
                "../Guide_Images/1_PrepPieces/DCMotor/Digital/Slide6.PNG",
                "../Guide_Images/1_PrepPieces/DCMotor/Digital/Slide7.PNG",
                "../Guide_Images/1_PrepPieces/DCMotor/Digital/Slide8.PNG",
                "../Guide_Images/1_PrepPieces/DCMotor/Digital/Slide9.PNG",
                "../Guide_Images/1_PrepPieces/DCMotor/Digital/Slide10.PNG",
                "../Guide_Images/1_PrepPieces/DCMotor/Real/Frame1.PNG",
                "../Guide_Images/1_PrepPieces/DCMotor/Real/Frame8.PNG",
                "../Guide_Images/1_PrepPieces/DCMotor/Real/Frame9.PNG"
            ],
            "real": [
                "../Guide_Images/1_PrepPieces/DCMotor/Real/Slide1.PNG",
                "../Guide_Images/1_PrepPieces/DCMotor/Real/Slide2.PNG",
                "../Guide_Images/1_PrepPieces/DCMotor/Real/Slide3.PNG",
                "../Guide_Images/1_PrepPieces/DCMotor/Real/Slide4.PNG",
                "../Guide_Images/1_PrepPieces/DCMotor/Real/Slide5.PNG",
                "../Guide_Images/1_PrepPieces/DCMotor/Real/Slide6.PNG",
                "../Guide_Images/1_PrepPieces/DCMotor/Real/Slide7.PNG",
                "../Guide_Images/1_PrepPieces/DCMotor/Real/Slide8.PNG",
                "../Guide_Images/1_PrepPieces/DCMotor/Real/Slide9.PNG",
                "../Guide_Images/1_PrepPieces/DCMotor/Real/Slide10.PNG",
                "../Guide_Images/1_PrepPieces/DCMotor/Real/Frame1.PNG",
                "../Guide_Images/1_PrepPieces/DCMotor/Real/Frame8.PNG",
                "../Guide_Images/1_PrepPieces/DCMotor/Real/Frame9.PNG"
            ],
            "text": [
                "Cut the tendon to obtain a 25cmm long piece.",
                "Thread tendon into the motor spool from the side hole. Be aware of the direction it should come out of.",
                "Holding both sides of the tendon, push it onto the motor shaft, aligning the flat surfaces.",
                "Pull the thread coming out the bottom to have roughly 8cm.",
                "Make a loop.",
                "Pass the tendon around the motor shaft and through the loop.",
                "Holding the tendon which comes out the side hole, pull on the other end until you can't anymore.",
                "Now, pull on the tendon coming out of the side hole.",
                "Push the motor spool down.",
                "Cut the excess.",
                "Pass the stripped end of a female Dupont wire through the motor pin hole, and twist the strands around the pin.",
                "Solder the wire to the pin.",
                "Repeat the last two steps on the other motor pin, then prepare a second DC motor, following the exact same steps."
            ]
        } // DONE
    }, // DONE
    "assemble": {
        "tab1": {   //assemble components
            "digital": [
                "../Guide_Images/2_AssembleFinger/Components/Digital/Slide1.png",
                "../Guide_Images/2_AssembleFinger/Components/Digital/Slide2.png",
                "../Guide_Images/2_AssembleFinger/Components/Digital/Slide3.png",
                "../Guide_Images/2_AssembleFinger/Components/Digital/Slide4.png",
                "../Guide_Images/2_AssembleFinger/Components/Digital/Slide5.png",
                "../Guide_Images/2_AssembleFinger/Components/Digital/Slide6.png",
                "../Guide_Images/2_AssembleFinger/Components/Digital/Slide7.png",
                "../Guide_Images/2_AssembleFinger/Components/Digital/Slide8.png",
                "../Guide_Images/2_AssembleFinger/Components/Digital/Slide9.png",
                "../Guide_Images/2_AssembleFinger/Components/Digital/Slide10.png",
                "../Guide_Images/2_AssembleFinger/Components/Digital/Slide11.png",
                "../Guide_Images/2_AssembleFinger/Components/Digital/Slide12.png",
                "../Guide_Images/2_AssembleFinger/Components/Digital/Slide13.png",
                "../Guide_Images/2_AssembleFinger/Components/Digital/Slide14.png",
                "../Guide_Images/2_AssembleFinger/Components/Digital/Slide15.png"
            ],
            "real": [
                "../Guide_Images/2_AssembleFinger/Components/Real/Slide1.png",
                "../Guide_Images/2_AssembleFinger/Components/Real/Slide2.png",
                "../Guide_Images/2_AssembleFinger/Components/Real/Slide3.png",
                "../Guide_Images/2_AssembleFinger/Components/Real/Slide4.png",
                "../Guide_Images/2_AssembleFinger/Components/Real/Slide5.png",
                "../Guide_Images/2_AssembleFinger/Components/Real/Slide6.png",
                "../Guide_Images/2_AssembleFinger/Components/Real/Slide7.png",
                "../Guide_Images/2_AssembleFinger/Components/Real/Slide8.png",
                "../Guide_Images/2_AssembleFinger/Components/Real/Slide9.png",
                "../Guide_Images/2_AssembleFinger/Components/Real/Slide10.png",
                "../Guide_Images/2_AssembleFinger/Components/Real/Slide11.png",
                "../Guide_Images/2_AssembleFinger/Components/Real/Slide12.png",
                "../Guide_Images/2_AssembleFinger/Components/Real/Slide13.png",
                "../Guide_Images/2_AssembleFinger/Components/Real/Slide14.png",
                "../Guide_Images/2_AssembleFinger/Components/Real/Slide15.png"
            ],
            "text": [
                "Hold the spring in position with the fingertip and pass a 10mm metal pin through.",
                "Place the medial half. The potentiometer should fit into the fingertip.",
                "Check the friction at the 1rst joint. If it doesn't flick back correctly, try to loosen the potentiometer or the data pin as shown in the tutorial.",
                "Add the pulley",
                "Place the washer",
                "Add the other half of the medial.",
                "Hold the spring in position and pass a 13mm metal pin through.",
                "Place the proximal half, the potentiometer should fit into the medial.",
                "Check the friction at the 2nd joint. If it doesn't flick back correctly, try to loosen the potentiometer or the data pin as shown in the tutorial.",
                "Place the DC Motor, the tendon should have about 1 rotation around the spool.",
                "Add the other half of the proximal. Make sure the tendon comes out correctly.",
                "Screw in the screws on both sides.",
                "Add a 15mm metal pin.",
                "Cut the springs",
                "Final result"
            ]
        }, // DONE
        "tab2": {   //tendon routing
            "digital": [
                "../Guide_Images/2_AssembleFinger/Tendon/Digital/Frame129.png",
                "../Guide_Images/2_AssembleFinger/Tendon/Digital/Frame130.png",
                "../Guide_Images/2_AssembleFinger/Tendon/Digital/Frame131.png",
                "../Guide_Images/2_AssembleFinger/Tendon/Digital/Frame132.png",
                "../Guide_Images/2_AssembleFinger/Tendon/Digital/Frame133.png",
                "../Guide_Images/2_AssembleFinger/Tendon/Real/Slide6.png",
                "../Guide_Images/2_AssembleFinger/Tendon/Digital/Frame136.png"
            ],
            "real": [
                "../Guide_Images/2_AssembleFinger/Tendon/Real/Slide1.png",
                "../Guide_Images/2_AssembleFinger/Tendon/Real/Slide2.png",
                "../Guide_Images/2_AssembleFinger/Tendon/Real/Slide3.png",
                "../Guide_Images/2_AssembleFinger/Tendon/Real/Slide4.png",
                "../Guide_Images/2_AssembleFinger/Tendon/Real/Slide5.png",
                "../Guide_Images/2_AssembleFinger/Tendon/Real/Slide6.png",
                "../Guide_Images/2_AssembleFinger/Tendon/Real/Slide7.png"
            ],
            "text": [
                "Current build",
                "Pass the tendon between the pulley and the metal rod above.",
                "Bring the tendon around the pulley, and back to the front.",
                "Pass the tendon under the metal pin of the fingertip.",
                "Unscrew the fingertip screw, pass the tendon under the washer, and screw it in again.",
                "To confirm it works properly, pull on the tendon.",
                "Cut of the excess tendon."
            ]
        }, // DONE
        "tab3": {   //fingertip padding
            "digital": [
                "../Guide_Images/2_AssembleFinger/Padding/Slide1.png",
                "../Guide_Images/2_AssembleFinger/Padding/Slide2.png",
                "../Guide_Images/2_AssembleFinger/Padding/Slide3.png",
                "../Guide_Images/2_AssembleFinger/Padding/Slide4.png",
                "../Guide_Images/2_AssembleFinger/Padding/Slide5.png",
                "../Guide_Images/2_AssembleFinger/Padding/Slide6.png",
                "../Guide_Images/2_AssembleFinger/Padding/Slide7.png",
                "../Guide_Images/2_AssembleFinger/Padding/Slide8.png",
                "../Guide_Images/2_AssembleFinger/Padding/Slide9.png"
            ],
            "real": [
                "../Guide_Images/2_AssembleFinger/Padding/Slide1.png",
                "../Guide_Images/2_AssembleFinger/Padding/Slide2.png",
                "../Guide_Images/2_AssembleFinger/Padding/Slide3.png",
                "../Guide_Images/2_AssembleFinger/Padding/Slide4.png",
                "../Guide_Images/2_AssembleFinger/Padding/Slide5.png",
                "../Guide_Images/2_AssembleFinger/Padding/Slide6.png",
                "../Guide_Images/2_AssembleFinger/Padding/Slide7.png",
                "../Guide_Images/2_AssembleFinger/Padding/Slide8.png",
                "../Guide_Images/2_AssembleFinger/Padding/Slide9.png"
            ],
            "text": [
                "Cut the 3mm foam to obtain a rectangle of 25mm by 13mm.",
                "Place the foam on the fingertip.",
                "Wrap the grip tape around the fingertip, minimising folds as much as possible.",
                "Final result",
                "Cut two pieces of self-adhesive silicone tape.",
                "Place them together as shown.",
                "Wrap the large flaps around the fingertip, joining them at the back.",
                "Pull the remaining top flap towards the back.",
                "Final result"
            ]
        }
    }, // DONE
    "I_assemble": {
        "tab1": {   //assemble components
            "digital": [
                "../Guide_Images/2_AssembleFinger/Components_I/Digital/Slide1.png",
                "../Guide_Images/2_AssembleFinger/Components_I/Digital/Slide2.png",
                "../Guide_Images/2_AssembleFinger/Components_I/Digital/Slide3.png",
                "../Guide_Images/2_AssembleFinger/Components_I/Digital/Slide4.png",
                "../Guide_Images/2_AssembleFinger/Components_I/Digital/Slide5.png",
                "../Guide_Images/2_AssembleFinger/Components_I/Digital/Slide6.png",
                "../Guide_Images/2_AssembleFinger/Components_I/Digital/Slide7.png",
                "../Guide_Images/2_AssembleFinger/Components_I/Digital/Slide8.png",
                "../Guide_Images/2_AssembleFinger/Components_I/Digital/Slide9.png",
                "../Guide_Images/2_AssembleFinger/Components_I/Digital/Slide10.png",
                "../Guide_Images/2_AssembleFinger/Components_I/Digital/Slide11.png",
                "../Guide_Images/2_AssembleFinger/Components_I/Digital/Slide12.png",
                "../Guide_Images/2_AssembleFinger/Components_I/Digital/Slide13.png",
                "../Guide_Images/2_AssembleFinger/Components_I/Digital/Slide14.png",
                "../Guide_Images/2_AssembleFinger/Components_I/Digital/Slide15.png"
            ],
            "real": [
                "../Guide_Images/2_AssembleFinger/Components/Real/Slide1.png",
                "../Guide_Images/2_AssembleFinger/Components/Real/Slide2.png",
                "../Guide_Images/2_AssembleFinger/Components/Real/Slide3.png",
                "../Guide_Images/2_AssembleFinger/Components/Real/Slide4.png",
                "../Guide_Images/2_AssembleFinger/Components/Real/Slide5.png",
                "../Guide_Images/2_AssembleFinger/Components/Real/Slide6.png",
                "../Guide_Images/2_AssembleFinger/Components/Real/Slide7.png",
                "../Guide_Images/2_AssembleFinger/Components_I/Real/Slide8.png",
                "../Guide_Images/2_AssembleFinger/Components_I/Real/Slide9.png",
                "../Guide_Images/2_AssembleFinger/Components_I/Real/Slide10.png",
                "../Guide_Images/2_AssembleFinger/Components_I/Real/Slide11.png",
                "../Guide_Images/2_AssembleFinger/Components_I/Real/Slide12.png",
                "../Guide_Images/2_AssembleFinger/Components/Real/Slide13.png",
                "../Guide_Images/2_AssembleFinger/Components/Real/Slide14.png",
                "../Guide_Images/2_AssembleFinger/Components/Real/Slide15.png"
            ],
            "text": [
                "Hold the spring in position with the fingertip and pass a 10mm metal pin through.",
                "Place the medial half. The potentiometer should fit into the fingertip.",
                "Check the friction at the 1rst joint. If it doesn't flick back correctly, try to loosen the potentiometer or the data pin as shown in the tutorial.",
                "Add the pulley",
                "Place the washer",
                "Add the other half of the medial.",
                "Hold the spring in position and pass a 13mm metal pin through.",
                "Place the proximal half, the potentiometer should fit into the medial.",
                "Check the friction at the 2nd joint. If it doesn't flick back correctly, try to loosen the potentiometer or the data pin as shown in the tutorial.",
                "Place the DC Motor, the tendon should have about 1 rotation around the spool.",
                "Add the other half of the proximal. Make sure the tendon comes out correctly.",
                "Screw in the screws.",
                "Add a 15mm metal pin.",
                "Cut the springs",
                "Final result"
            ]
        }, // DONE
        "tab2": {   //tendon routing
            "digital": [
                "../Guide_Images/2_AssembleFinger/Tendon/Digital/Frame129.png",
                "../Guide_Images/2_AssembleFinger/Tendon/Digital/Frame130.png",
                "../Guide_Images/2_AssembleFinger/Tendon/Digital/Frame131.png",
                "../Guide_Images/2_AssembleFinger/Tendon/Digital/Frame132.png",
                "../Guide_Images/2_AssembleFinger/Tendon/Digital/Frame133.png",
                "../Guide_Images/2_AssembleFinger/Tendon/Real/Slide6.png",
                "../Guide_Images/2_AssembleFinger/Tendon/Digital/Frame136.png"
            ],
            "real": [
                "../Guide_Images/2_AssembleFinger/Tendon/Real/Slide1.png",
                "../Guide_Images/2_AssembleFinger/Tendon/Real/Slide2.png",
                "../Guide_Images/2_AssembleFinger/Tendon/Real/Slide3.png",
                "../Guide_Images/2_AssembleFinger/Tendon/Real/Slide4.png",
                "../Guide_Images/2_AssembleFinger/Tendon/Real/Slide5.png",
                "../Guide_Images/2_AssembleFinger/Tendon/Real/Slide6.png",
                "../Guide_Images/2_AssembleFinger/Tendon/Real/Slide7.png"
            ],
            "text": [
                "Current build",
                "Pass the tendon between the pulley and the metal rod above.",
                "Bring the tendon around the pulley, and back to the front.",
                "Pass the tendon under the metal pin of the fingertip.",
                "Unscrew the fingertip screw, pass the tendon under the washer, and screw it in again.",
                "To confirm it works properly, pull on the tendon.",
                "Cut of the excess tendon."
            ]
        } // DONE
    }, // DONE
    "metacarpal": {
        "tab1": {   //prep metacarpal
            "digital": [
                "../Guide_Images/3_Metacarpal/Metacarpal/Digital/Slide1.PNG",
                "../Guide_Images/3_Metacarpal/Metacarpal/Digital/Slide2.PNG",
                "../Guide_Images/3_Metacarpal/Metacarpal/Digital/Slide3.PNG",
                "../Guide_Images/3_Metacarpal/Metacarpal/Digital/Slide4.PNG",
                "../Guide_Images/3_Metacarpal/Metacarpal/Digital/Slide5.PNG"
            ],
            "real": [
                "../Guide_Images/3_Metacarpal/Metacarpal/Real/Slide1.PNG",
                "../Guide_Images/3_Metacarpal/Metacarpal/Real/Slide2.PNG",
                "../Guide_Images/3_Metacarpal/Metacarpal/Real/Slide3.PNG",
                "../Guide_Images/3_Metacarpal/Metacarpal/Real/Slide4.PNG",
                "../Guide_Images/3_Metacarpal/Metacarpal/Real/Slide5.PNG"
            ],
            "text": [
                "File to remove small irregularities.",
                "Screw in 8mm long screw with a washer.",
                "Push in a 15mm metal pin.",
                "Push in a 15mm metal pin.",
                "Screw in 8mm long screw."
            ]
        }, //DONE
        "tab2": {   //prep metacarpal branch
            "digital": [
                "../Guide_Images/3_Metacarpal/MetacarpalBranch/Digital/Slide1.PNG"
            ],
            "real": [
                "../Guide_Images/3_Metacarpal/MetacarpalBranch/Real/Slide1.PNG"
            ],
            "text": [
                "Place potentiometer as shown in tutorial."
            ]
        }, // DONE
        "tab3": {   //assemble joint
            "digital": [
                "../Guide_Images/3_Metacarpal/Joint/Digital/Slide1.PNG",
                "../Guide_Images/3_Metacarpal/Joint/Digital/Slide2.PNG",
                "../Guide_Images/3_Metacarpal/Joint/Digital/Slide3.PNG",
                "../Guide_Images/3_Metacarpal/Joint/Digital/Slide4.PNG",
                "../Guide_Images/3_Metacarpal/Joint/Digital/Slide5.PNG",
                "../Guide_Images/3_Metacarpal/Joint/Digital/Slide6.PNG",
                "../Guide_Images/3_Metacarpal/Joint/Digital/Slide7.PNG",
                "../Guide_Images/3_Metacarpal/Joint/Digital/Slide8.PNG"
            ],
            "real": [
                "../Guide_Images/3_Metacarpal/Joint/Real/Slide1.PNG",
                "../Guide_Images/3_Metacarpal/Joint/Real/Slide2.PNG",
                "../Guide_Images/3_Metacarpal/Joint/Real/Slide3.PNG",
                "../Guide_Images/3_Metacarpal/Joint/Real/Slide4.PNG",
                "../Guide_Images/3_Metacarpal/Joint/Real/Slide5.PNG",
                "../Guide_Images/3_Metacarpal/Joint/Real/Slide6.PNG",
                "../Guide_Images/3_Metacarpal/Joint/Real/Slide7.PNG",
                "../Guide_Images/3_Metacarpal/Joint/Real/Slide8.PNG"
            ],
            "text": [
                "File to remove any irregularities.",
                "Align both springs, and slide metal pin into place.",
                "Place the metacarpal.",
                "Place the metacarpal branch on the other side. The potentiometer should fit into the proximal.",
                "Screw in the screw.",
                "Check the friction at the joint. If it doesn't flick back correctly, try to loosen the potentiometer or the data pin as shown in the tutorial.",
                "Cut the excess.",
                "Final result"
            ]
        } // DONE
    }, // DONE
    "I_metacarpal": {
        "tab1": {   //prep metacarpal
            "digital": [
                "../Guide_Images/3_Metacarpal/Metacarpal_I/Digital/Slide1.PNG",
                "../Guide_Images/3_Metacarpal/Metacarpal_I/Digital/Slide2.PNG",
                "../Guide_Images/3_Metacarpal/Metacarpal_I/Digital/Slide3.PNG",
                "../Guide_Images/3_Metacarpal/Metacarpal_I/Digital/Slide4.PNG",
                "../Guide_Images/3_Metacarpal/Metacarpal_I/Digital/Slide5.PNG"
            ],
            "real": [
                "../Guide_Images/3_Metacarpal/Metacarpal_I/Real/Slide1.PNG",
                "../Guide_Images/3_Metacarpal/Metacarpal_I/Real/Slide2.PNG",
                "../Guide_Images/3_Metacarpal/Metacarpal_I/Real/Slide3.PNG",
                "../Guide_Images/3_Metacarpal/Metacarpal_I/Real/Slide4.PNG",
                "../Guide_Images/3_Metacarpal/Metacarpal_I/Real/Slide5.PNG"
            ],
            "text": [
                "File to remove small irregularities.",
                "Screw in 8mm long screw with a washer.",
                "Push in a 15mm metal pin.",
                "Push in a 15mm metal pin.",
                "Screw in 8mm long screw."
            ]
        }, // DONE
        "tab2": {   //prep metacarpal branch
            "digital": [
                "../Guide_Images/3_Metacarpal/MetacarpalBranch_I/Digital/MetacarpalBranchDOC.PNG"
            ],
            "real": [
                "../Guide_Images/3_Metacarpal/MetacarpalBranch_I/Real/Slide2.PNG"
            ],
            "text": [
                "Place potentiometer as shown in tutorial."
            ]
        }, // DONE
        "tab3": {   //assemble joint
            "digital": [
                "../Guide_Images/3_Metacarpal/Joint_I/Digital/Slide1.PNG",
                "../Guide_Images/3_Metacarpal/Joint_I/Digital/Slide2.PNG",
                "../Guide_Images/3_Metacarpal/Joint_I/Digital/Slide3.PNG",
                "../Guide_Images/3_Metacarpal/Joint_I/Digital/Slide4.PNG",
                "../Guide_Images/3_Metacarpal/Joint_I/Digital/Slide5.PNG",
                "../Guide_Images/3_Metacarpal/Joint_I/Digital/Slide6.PNG",
                "../Guide_Images/3_Metacarpal/Joint_I/Digital/Slide7.PNG",
                "../Guide_Images/3_Metacarpal/Joint_I/Digital/Slide8.PNG"
            ],
            "real": [
                "../Guide_Images/3_Metacarpal/Joint_I/Real/Slide1.PNG",
                "../Guide_Images/3_Metacarpal/Joint_I/Real/Slide2.PNG",
                "../Guide_Images/3_Metacarpal/Joint_I/Real/Slide3.PNG",
                "../Guide_Images/3_Metacarpal/Joint_I/Real/Slide4.PNG",
                "../Guide_Images/3_Metacarpal/Joint_I/Real/Slide5.PNG",
                "../Guide_Images/3_Metacarpal/Joint_I/Real/Slide6.PNG",
                "../Guide_Images/3_Metacarpal/Joint_I/Real/Slide7.PNG",
                "../Guide_Images/3_Metacarpal/Joint_I/Real/Slide8.PNG"
            ],
            "text": [
                "File to remove any irregularities.",
                "Align both springs, and slide metal pin into place.",
                "Place the metacarpal.",
                "Place the metacarpal branch on the other side. The potentiometer should fit into the proximal.",
                "Screw in the screw.",
                "Check the friction at the joint. If it doesn't flick back correctly, try to loosen the potentiometer or the data pin as shown in the tutorial.",
                "Cut the excess.",
                "Final result"
            ]
        } // DONE
    }, // DONE
    "wiring": {
        "tab1": {   //finger
            "real": [
                "../Guide_Images/4_Wiring/Finger/Slide1.PNG",
                "../Guide_Images/4_Wiring/Finger/Slide2.PNG",
                "../Guide_Images/4_Wiring/Finger/Slide3.PNG",
                "../Guide_Images/4_Wiring/Finger/Slide4.PNG",
                "../Guide_Images/4_Wiring/Finger/Slide5.PNG",
                "../Guide_Images/4_Wiring/Finger/Slide6.PNG",
                "../Guide_Images/4_Wiring/Finger/Slide7.PNG",
                "../Guide_Images/4_Wiring/Finger/Slide8.PNG",
                "../Guide_Images/4_Wiring/Finger/Slide9.PNG",
                "../Guide_Images/4_Wiring/Finger/Slide10.PNG"
            ],
            "text": [
                "You should be careful how you wire each of the potentiometers to ensure each pin is connected correctly. It is conventional to use red for current (5V), black for ground (GND) and any other color for data pins. If you want to use different colors, you may, but make sure you won’t mix up which cable leads to what as that could cause errors in the electrical circuit.",
                "Cut 6 25cm long wires (0.5mm diameter) and strip the ends.",
                "Place the wire in the correct space with the stripped end over the potentiometer pin, and solder it.",
                "Repeat for all 3 wires.",
                "Twist the three wires together and pass them inside the dip.",
                "Add a piece of electrical tape to hold them in place.",
                "Pass the wires behind the spring and to the front of the finger.",
                "Solder the remaining wires to the second potentiometer.",
                "Twist the wires from the second potentiometer until it reaches the other wires. Fold the finger, and twist all the wires together.",
                "Twist the wires to the end, and pass them in the dedicated dip along the side of the finger. You may use a bit of glue to hold them in place."
            ]
        }, //
        "tab2": {   //metacarpal
            "real": [
                "../Guide_Images/4_Wiring/Metacarpal/Slide11.PNG",
                "../Guide_Images/4_Wiring/Metacarpal/Slide12.PNG",
                "../Guide_Images/4_Wiring/Metacarpal/Slide13.PNG",
                "../Guide_Images/4_Wiring/Metacarpal/Slide14.PNG",
                "../Guide_Images/4_Wiring/Metacarpal/Slide15.PNG"
            ],
            "text": [
                "Cut 3 15cm long wires (0.5mm diameter) and strip the ends.",
                "Solder the three wires to the third potentiometer.",
                "Pass the wires along the edge, in the dip, twisting them as they encounter each other.",
                "Twist the wires until the end, and pass them in the dedicated angle, using a bit of hot glue to hold it in place.",
                "Final result"
            ]
        },
        "tab3": {   //DC motor
            "real": [
                "../Guide_Images/4_Wiring/DCMotor/Frame1.PNG",
                "../Guide_Images/4_Wiring/DCMotor/Frame8.PNG",
                "../Guide_Images/4_Wiring/DCMotor/Frame9.PNG",
                "../Guide_Images/4_Wiring/DCMotor/Frame10.PNG",
                "../Guide_Images/4_Wiring/DCMotor/Frame11.PNG",
            ],
            "text": [
                "Using tape, fix the metacarpal completely flexed.",
                "Pass the stripped end of a female Dupont wire through the motor pin hole, and twist the strands around the pin.",
                "Repeat with another wire on the other pin, and tape both to the finger.",
                "Solder the each wire to the pin.",
                "Use hot glue to stabilise the wires, and untape them from the finger."
            ]
        },
    }, // DONE
    "T_CMC": {
        "tab1": { //Main
            "real": [
                "../Guide_Images/5_Thumb/1_CMC/Prepare/Frame9.PNG",
            ],
            "text": [
                "Push 8mm metal pin in."
            ]
        }, // DONE
        "tab2": { //Link
            "real": [
                "../Guide_Images/5_Thumb/1_CMC/Prepare/Frame2.PNG",
                "../Guide_Images/5_Thumb/1_CMC/Prepare/Frame3.PNG"
            ],
            "text": [
                "Place potentiometer as shown in tutorial.",
                "Press in 2x6x3mm bearing."
            ]
        }, // DONE
        "tab3": { //to palm
            "real": [
                "../Guide_Images/5_Thumb/1_CMC/Prepare/Frame4.PNG",
                "../Guide_Images/5_Thumb/1_CMC/Prepare/Frame5.PNG",
                "../Guide_Images/5_Thumb/1_CMC/Prepare/Frame6.PNG",
                "../Guide_Images/5_Thumb/1_CMC/Prepare/Frame7.PNG",
                "../Guide_Images/5_Thumb/1_CMC/Prepare/Frame8.PNG",
            ],
            "text": [
                "Place potentiometer as shown in tutorial.",
                "Solder three 20cm long 0.5mm diameter wires to the pins.",
                "Twist the wires together, passing them along the edge dip.",
                "Check the soldering doesn't protrude from the surface. If it does, cut off the excess.",
                "Screw in the cover with two 10mm M2 screws and a washer with the bottom screw."
            ]
        } // DONE
    }, // DONE
    "T_assemble": {
        "tab1": {   //assemble components
            "real": [
                "../Guide_Images/2_AssembleFinger/Thumb/Slide13.png",
                "../Guide_Images/2_AssembleFinger/Thumb/Slide14.png",
                "../Guide_Images/2_AssembleFinger/Thumb/Slide15.png",
                "../Guide_Images/2_AssembleFinger/Thumb/Slide16.png",
                "../Guide_Images/2_AssembleFinger/Thumb/Slide17.png",
                "../Guide_Images/2_AssembleFinger/Thumb/Slide18.png",
                "../Guide_Images/2_AssembleFinger/Thumb/Slide19.png",
                "../Guide_Images/2_AssembleFinger/Thumb/Slide20.png",
                "../Guide_Images/2_AssembleFinger/Thumb/Slide21.png",
                "../Guide_Images/2_AssembleFinger/Thumb/Slide22.png",
                "../Guide_Images/2_AssembleFinger/Thumb/Slide23.png",
                "../Guide_Images/2_AssembleFinger/Thumb/Slide24.png",
                "../Guide_Images/2_AssembleFinger/Thumb/Slide25.png",
                "../Guide_Images/2_AssembleFinger/Thumb/Frame1.png"
            ],
            "text": [
                "Hold the spring in position with the fingertip and pass a 10mm metal pin through.",
                "Place the medial half. The potentiometer should fit into the fingertip.",
                "Check the friction at the 1rst joint. If it doesn't flick back correctly, try to loosen the potentiometer or the data pin as shown in the tutorial.",
                "Add the pulley",
                "Place the washer",
                "Add the other half of the medial.",
                "Hold the spring in position and pass a 13mm metal pin through.",
                "Place the proximal half, the potentiometer should fit into the medial.",
                "Check the friction at the 2nd joint. If it doesn't flick back correctly, try to loosen the potentiometer or the data pin as shown in the tutorial.",
                "Add the other half of the proximal. Make sure the tendon comes out correctly.",
                "Screw in the screws.",
                "Cut the springs.",
                "Final Result"
            ]
        }, // DONE
        "tab2": {   //CMC joint
            "real": [
                "../Guide_Images/5_Thumb/1_CMC/Assemble/Frame1.png",
                "../Guide_Images/5_Thumb/1_CMC/Assemble/Frame8.png",
                "../Guide_Images/5_Thumb/1_CMC/Assemble/Frame9.png",
                "../Guide_Images/5_Thumb/1_CMC/Assemble/Frame10.png",
                "../Guide_Images/5_Thumb/1_CMC/Assemble/Frame11.png",
                "../Guide_Images/5_Thumb/1_CMC/Assemble/Frame12.png",
                "../Guide_Images/5_Thumb/1_CMC/Assemble/Frame13.png"
            ],
            "text": [
                "Holding two springs in place, slide in a metal pin.",
                "Pass the metal pin through the hole of the main platform.",
                "Position the CMC palm support underneath, fitting the potentiometer into the main platform.",
                "Slide the CMC joint link into position, the potentiometer should fit into the thumb.",
                "Screw in two 10mm M2 screws, with a washer on the right screw.",
                "Screw in a 6mm M2 screw at the bottom.",
                "Cut the excess of the springs.",
                "Final result"
            ]
        },
        "tab3": {   //DC motors
            "real": [
                "../Guide_Images/5_Thumb/2_DCMotor/Frame1.png",
                "../Guide_Images/5_Thumb/2_DCMotor/Frame8.png",
                "../Guide_Images/5_Thumb/2_DCMotor/Frame9.png",
                "../Guide_Images/5_Thumb/2_DCMotor/Frame10.png",
                "../Guide_Images/5_Thumb/2_DCMotor/Frame11.png",
                "../Guide_Images/5_Thumb/2_DCMotor/Frame12.png",
                "../Guide_Images/5_Thumb/2_DCMotor/Frame13.png",
                "../Guide_Images/5_Thumb/2_DCMotor/Frame14.png"
            ],
            "text": [
                "Slide the right motor into place, the top of the axle should fit into the hole, and the wires orientated towards the left.",
                "Pass the tendon into the hole, and lift the two wires upwards.",
                "Slide the second motor into place, holding its wires upwards as well.",
                "Pass the second motor's tendon into the same hole as the first.",
                "Tape the two motor together with electrical tape, and wrap it around the right of the thumb.",
                "On the left side, remove the screw with the washer and wrap the tape down.",
                "Recreate the screw hole with a screw driver and screw the screw and washer back in.",
                "Using hot glue, glue the four wires at the edge of the motors as shown. It shouldn't touch the CMC link at all."
            ]
        },
        "tab4": {   //Tendon
            "real": [
                "../Guide_Images/5_Thumb/3_Tendon/Frame1.png",
                "../Guide_Images/5_Thumb/3_Tendon/Frame8.png",
                "../Guide_Images/5_Thumb/3_Tendon/Frame9.png",
                "../Guide_Images/5_Thumb/3_Tendon/Frame10.png",
                "../Guide_Images/5_Thumb/3_Tendon/Frame11.png",
                "../Guide_Images/5_Thumb/3_Tendon/Frame12.png",
                "../Guide_Images/5_Thumb/3_Tendon/Frame13.png",
                "../Guide_Images/5_Thumb/3_Tendon/Frame14.png",
                "../Guide_Images/5_Thumb/3_Tendon/Frame15.png",
                "../Guide_Images/5_Thumb/3_Tendon/Frame16.png",
                "../Guide_Images/5_Thumb/3_Tendon/Frame17.png",
                "../Guide_Images/5_Thumb/3_Tendon/Frame18.png",
                "../Guide_Images/5_Thumb/3_Tendon/Frame19.png",
            ],
            "text": [
                "Both tendons should come out as shown on the picture, behind the metal bar. Make sure they aren't twisted.",
                "To start, only consider the right tendon. Pass it behind the pulley.",
                "Pass it back around the pulley, over the bottom metal pin.",
                "Pass it under the fingertip metal pin.",
                "Unscrew the right screw slightly, pass the tendon under the washer, and screw it back in.",
                "When pulling on the tendon, the first joint should flex first, then the second.",
                "Cut the excess tendon.",
                "Now take the second tendon, and pass it under the first spring to the back.",
                "Pass the tendon back to the front of the thumb, around the spring.",
                "Pass the tendon under the fingertip metal pin.",
                "Unscrew the left screw slightly, pass the tendon under the washer, and screw it back in.",
                "When pulling on this tendon, only the second joint should flex.",
                "Cut the excess tendon."
            ]
        },
        "tab5": {   //Wiring
            "real": [
                "../Guide_Images/5_Thumb/4_Wiring/Frame1.png",
                "../Guide_Images/5_Thumb/4_Wiring/Frame8.png",
                "../Guide_Images/5_Thumb/4_Wiring/Frame9.png",
                "../Guide_Images/5_Thumb/4_Wiring/Frame10.png",
                "../Guide_Images/5_Thumb/4_Wiring/Frame11.png",
                "../Guide_Images/5_Thumb/4_Wiring/Frame12.png",
                "../Guide_Images/5_Thumb/4_Wiring/Frame13.png",
                "../Guide_Images/5_Thumb/4_Wiring/Frame14.png",
                "../Guide_Images/5_Thumb/4_Wiring/Frame15.png",
                "../Guide_Images/5_Thumb/4_Wiring/Frame16.png",
                "../Guide_Images/5_Thumb/4_Wiring/Frame17.png"
            ],
            "text": [
                "Solder three 30cm long 0.5mm diameter wires to the three pins of the first potentiometer.",
                "Twist the wires together for about 10cm.",
                "Pass the wires under the spring, to the front, on the right of the tendons.",
                "Make sure they pass in the correct dip in the back.",
                "Solder three 25cm long 0.5mm diameter wires to the second potentiometer.",
                "Twist the strands for a few centimeters.",
                "Flex the thumb, and twist all the wires together, then release.",
                "Using hot glue, immobilise the wires. There should be enough slack to enable the thumb to flex.",
                "Twist the wires to the end.",
                "Solder three 20cm long 0.5mm diameter wires to the CMC potentiometer. Twist the wires together.",
                "Tape these down. You may also use hot glue."
            ]
        },
        "tab6": {   //Padding
            "real": [
                "../Guide_Images/5_Thumb/5_Padding/Frame1.png",
                "../Guide_Images/5_Thumb/5_Padding/Frame8.png",
                "../Guide_Images/5_Thumb/5_Padding/Frame9.png"
            ],
            "text": [
                "Cut a 3mm thick foam rectangle with the dimensions shown above.",
                "Place it on the thumb fingertip.",
                "Wrap the fingertip in fabric tape. You may add silicone tape over it if you would like to have more friction."
            ]
        }
    }, // DONE
    "palm_prep": {
        "tab1": { //Main
            "real": [
                "../Guide_Images/6_Palm/Prepare/Frame1.png",
                "../Guide_Images/6_Palm/Prepare/Frame8.png",
                "../Guide_Images/6_Palm/Prepare/Frame9.png",
                "../Guide_Images/6_Palm/Prepare/Frame10.png",
                "../Guide_Images/6_Palm/Prepare/Frame11.png",
                "../Guide_Images/6_Palm/Prepare/Frame12.png",
                "../Guide_Images/6_Palm/Prepare/Frame13.png",
                "../Guide_Images/6_Palm/Prepare/Frame14.png"
            ],
            "text": [
                "File to remove any irregularities.",
                "Screw in a first servo motor using the small self-tapering screws that come with. Be aware of the servo orientation!",
                "Screw in the rest of the servos with the appropriate orientation.",
                "Place small pieces of masking tape on the back of each servo (these will serve as labels).",
                "Wrap a piece of masking tape around the ends of the servo motors.",
                "Label each servo motor with the same numbers as shown in the picture.",
                "Write the same number on the end of the servo wire, and repeat for all.",
                "Pass all the wires around the servos, and group them."
            ]
        },
        "tab2": { //ADC block
            "real": [
                "../Guide_Images/6_Palm/ADC_Block/Frame1.png",
                "../Guide_Images/6_Palm/ADC_Block/Frame8.png",
                "../Guide_Images/6_Palm/ADC_Block/Frame9.png",
                "../Guide_Images/6_Palm/ADC_Block/Frame10.png",
                "../Guide_Images/6_Palm/ADC_Block/Frame11.png",
                "../Guide_Images/6_Palm/ADC_Block/Frame12.png",
                "../Guide_Images/6_Palm/ADC_Block/Frame13.png",
                "../Guide_Images/6_Palm/ADC_Block/Frame14.png",
                "../Guide_Images/6_Palm/ADC_Block/Frame15.png",
                "../Guide_Images/6_Palm/ADC_Block/Frame16.png",
                "../Guide_Images/6_Palm/ADC_Block/Frame17.png",
                "../Guide_Images/6_Palm/ADC_Block/Frame18.png",
                "../Guide_Images/6_Palm/ADC_Block/Frame19.png",
                "../Guide_Images/6_Palm/ADC_Block/Frame20.png",
            ],
            "text": [
                "The color of the wires are essential in this section. Connect 15cm long 0.5mm diameter wires of the correct colors to the pins of an ADC module.",
                "Fold the wires at the back of the module as shown.",
                "Trim the solder and excess wire tips.",
                "Place a strip of electrical tape at the back of the module, holding the wires into position and wrap around the front.",
                "Repeat the last four steps for the other three ADC module. Attention! There is a slight different in wiring for each at the ADDR pin.",
                "Take one ADC module and pass in two 12mm long M2 screws.",
                "Screw in two M2 nuts tightly.",
                "Layer over a second ADC module and screw in two other M2 nuts tightly.",
                "Repeat with a third ADC module.",
                "And with the fourth.",
                "This is what you should obtain.",
                "Gather all the red wires and twist them together.",
                "Repeat with the black, orange and yellow wires."
            ]
        }
    }, // DONE
    "palm_assemble": {
        "tab1": { //Add fingers
            "real": [
                "../Guide_Images/6_Palm/AddFingers/1.png",
                "../Guide_Images/6_Palm/AddFingers/2.png",
                "../Guide_Images/6_Palm/AddFingers/3.png",
                "../Guide_Images/6_Palm/AddFingers/4.png",
                "../Guide_Images/6_Palm/AddFingers/5.png",
                "../Guide_Images/6_Palm/AddFingers/6.png",
                "../Guide_Images/6_Palm/AddFingers/7.png",
                "../Guide_Images/6_Palm/AddFingers/8.png",
                "../Guide_Images/6_Palm/AddFingers/9.png",
                "../Guide_Images/6_Palm/AddFingers/10.png",
                "../Guide_Images/6_Palm/AddFingers/11.png",
                "../Guide_Images/6_Palm/AddFingers/12.png",
                "../Guide_Images/6_Palm/AddFingers/13.png",
                "../Guide_Images/6_Palm/AddFingers/14.png",
                "../Guide_Images/6_Palm/AddFingers/15.png",
                "../Guide_Images/6_Palm/AddFingers/16.png",
                "../Guide_Images/6_Palm/AddFingers/17.png",
                "../Guide_Images/6_Palm/AddFingers/18.png",
                "../Guide_Images/6_Palm/AddFingers/19.png"
            ],
            "text": [
                "Cut a 25 cm long tendon.",
                "Unscrew the bottom screw until you can reach behind the washer. Make sure to hold both bottom pieces together to they don't move.",
                "Pass the tendon behind the washer as shown and cut off the excess.",
                "Thread the tendon into the hole next to the bottom screw, and grab it from the exit as shown.",
                "Push the excess tendon into the hole as well.",
                "Cut another 25 cm long tendon.",
                "Fold the tendon in half and pass it between both springs to the back of the finger.",
                "Unscrew the screw located at the back of the metacarpal joint, and pass the tendon behind the washer before screwing it back in.",
                "Grab the right side of the tendon and pass it through the hole as shown.",
                "Grab the other side and pass through the left hole. Make sure not to trap the end of the spring.",
                "Repeat for all other fingers.",
                "Place the finger on the left most support. Make sure the wires and tendons are above the palm.",
                "Slide a metal dowel through the hole until it reaches the back face.",
                "Push the wires through the hole, ensuring they aren't strained when the finger is fully extended.",
                "Use a hot glue gun to hold the wires in place.",
                "Repeat the process for the ring finger. This finger shouldn't be able to rotate.",
                "Repeat the process for the middle finger.",
                "Final result"
            ]
        }, // DONE
        "tab2": { //Add Knuckes
            "real": [
                "../Guide_Images/6_Palm/Assembly/Slide1.PNG",
                "../Guide_Images/6_Palm/Assembly/Slide2.PNG",
                "../Guide_Images/6_Palm/Assembly/Slide3.PNG",
                "../Guide_Images/6_Palm/Assembly/Slide4.PNG",
                "../Guide_Images/6_Palm/Assembly/Slide5.PNG",
                "../Guide_Images/6_Palm/Assembly/Slide6.PNG",
                "../Guide_Images/6_Palm/Assembly/Slide7.PNG"
            ],
            "text": [
                "Place a potentiometer into the dedicated slot.",
                "Repeat in the other 3 slots.",
                "Cover the second with tape, and solder wires appropriately for the other 3.",
                "Arrange the wires so they come downwards and cover them with tape.",
                "What the prepared knucked piece should look like.",
                "Place the knuckles as shown, making sure the potentiometers fit into the finger's metacarpals.",
                "Screw the knuckles in with 3 screws."
            ]
        },
        "tab3": { //connect potentiometers
            "real": [
                "../Guide_Images/6_Palm/Assembly/Slide8.PNG",
                "../Guide_Images/6_Palm/Assembly/Slide9.PNG",
                "../Guide_Images/6_Palm/Assembly/Slide10.PNG",
                "../Guide_Images/6_Palm/Assembly/Slide11.PNG",
                "../Guide_Images/6_Palm/Assembly/Slide12.PNG",
                "../Guide_Images/6_Palm/Assembly/Slide13.PNG",
                "../Guide_Images/6_Palm/Assembly/Slide14.PNG",
                "../Guide_Images/6_Palm/Assembly/Slide15.PNG",
                "../Guide_Images/6_Palm/Assembly/Slide16.PNG"
            ],
            "text": [
                "Place the ADC Block on the back of the palm.",
                "Place the twisted wires from each finger as shown, make sure they aren't strained when the finger bends and glue them down.",
                "Untwist the wires and retwist the ground wires and the power wires seperately for the first finger you will work on.",
                "Seperate one of the data strands from the ADC block and untwist the wires.",
                "Grab one of the data strands from the ADC module you just untwisted and one of the data wired from the finger. Cut off some excess.",
                "Strip the ends, twist them together, solder and cover with tape.",
                "Fold the wires away.",
                "Repeat with the finger's other data wires. Then tape them all together.",
                "Repeat the process for the fingers."
            ]
        },
        "tab4": { //Add thumb
            "real": [
                "../Guide_Images/6_Palm/Assembly/Slide17.PNG",
                "../Guide_Images/6_Palm/Assembly/Slide18.PNG",
                "../Guide_Images/6_Palm/Assembly/Slide19.PNG",
                "../Guide_Images/6_Palm/Assembly/Slide20.PNG",
                "../Guide_Images/6_Palm/Assembly/Slide21.PNG",
                "../Guide_Images/6_Palm/Assembly/Slide22.PNG",
                "../Guide_Images/6_Palm/Assembly/Slide23.PNG"
            ],
            "text": [
                "Place a potentiometer in the palm support and solder wires on.",
                "Slide a metal dowel into the thumb support.",
                "Place the thumb, ensuring the potentiometer fits into the thumb's CMC. Then place the thumb support, pushing the metal pin until it touches the potentiometer.",
                "Screw in two screw into the thumb support from the back of the palm.",
                "Pass the twisted wires into the hole and glue them into place, ensuring they don't get strained when the thumb rotates.",
                "Twist the other two thumb wires together and glue them onto the back of the palm, ensuring they don't get strained when the thumb moves.",
                "Twist the ground wires and the power wires together.",
            ]
        },
        "tab5": { //Final wiring
            "real": [
                "../Guide_Images/6_Palm/Assembly/Slide24.PNG",
                "../Guide_Images/6_Palm/Assembly/Slide25.PNG",
                "../Guide_Images/6_Palm/Assembly/Slide26.PNG",
                "../Guide_Images/6_Palm/Assembly/Slide27.PNG",
                "../Guide_Images/6_Palm/Assembly/Slide28.PNG",
                "../Guide_Images/6_Palm/Assembly/Slide29.PNG",
                "../Guide_Images/6_Palm/Assembly/Slide30.PNG",
                "../Guide_Images/6_Palm/Assembly/Slide31.PNG"
            ],
            "text": [
                "Get a wire with an exposed end.",
                "Cut one of the twisted wire group about 2cm from the palm.",
                "Strip the ends and twist them all together.",
                "Solder the wire with the twisted end, and cover with tape.",
                "Repeat with all the other groups of wires.",
                "Pass all the wires between the two servos at the bottom of the palm, and tape them together.",
                "Place each of the finger's DC wires as shown, ensuring they don't get strained when the finger bends.",
                "To finish, solder each of the remaining thin wires to another with a crimped end."
            ]
        }
    },
    "palm_tendon": {
        "tab1": { //Digits
            "real": [
                "../Guide_Images/not_ready.png"
            ],
            "text": [
                " "
            ]
        },
        "tab2": { //Thumb
            "real": [
                "../Guide_Images/not_ready.png"
                // "../Guide_Images/6_Palm/MCPTendonThumb/Slide1.PNG",
                // "../Guide_Images/6_Palm/MCPTendonThumb/Slide2.PNG",
                // "../Guide_Images/6_Palm/MCPTendonThumb/Slide3.PNG",
                // "../Guide_Images/6_Palm/MCPTendonThumb/Slide4.PNG",
                // "../Guide_Images/6_Palm/MCPTendonThumb/Slide5.PNG",
                // "../Guide_Images/6_Palm/MCPTendonThumb/Slide6.PNG",
                // "../Guide_Images/6_Palm/MCPTendonThumb/Slide7.PNG",
                // "../Guide_Images/6_Palm/MCPTendonThumb/Slide8.PNG",
                // "../Guide_Images/6_Palm/MCPTendonThumb/Slide9.PNG",
                // "../Guide_Images/6_Palm/MCPTendonThumb/Slide10.PNG",
                // "../Guide_Images/6_Palm/MCPTendonThumb/Slide11.PNG",
                // "../Guide_Images/6_Palm/MCPTendonThumb/Slide12.PNG",
                // "../Guide_Images/6_Palm/MCPTendonThumb/Slide13.PNG",
                // "../Guide_Images/6_Palm/MCPTendonThumb/Slide14.PNG",
                // "../Guide_Images/6_Palm/MCPTendonThumb/Slide15.PNG",
                // "../Guide_Images/6_Palm/MCPTendonThumb/Slide16.PNG",
                // "../Guide_Images/6_Palm/MCPTendonThumb/Slide17.PNG",
                // "../Guide_Images/6_Palm/MCPTendonThumb/Slide18.PNG",
                // "../Guide_Images/6_Palm/MCPTendonThumb/Slide19.PNG",
                // "../Guide_Images/6_Palm/MCPTendonThumb/Slide20.PNG",
                // "../Guide_Images/6_Palm/MCPTendonThumb/Slide21.PNG"
            ],
            "text": [
                " "
                // "Take the long servo arm and cut to achieve the shape shown above.",
                // "Trim the corners",
                // "Pass the thumb tendon through the servo arm in the furthest hole.",
                // "Place on the servo as shown.",
                // "Screw in the small servo screw slightly, pass the tendon around it and tighten.",
                // "Cut off the excess tendon.",
                // "Cut another 25cm long tendon.",
                // "Pass through the hole as shown.",
                // "Pass through the servo bar and make a knot.",
                // "Slightly unscrew the screw, pass the tendon around it then tighten slightly. The tendon should be able to glide.",
                // "Pass the other end through the servo bar and make another knot.",
                // "Position the thumb as shown, place the servo bar on the servo, then pull on the free end until it's tight.",
                // "Using the servo screw, attach the tendon.",
                // "Cut off the excess.",
                // "Cut another 25cm long tendon.",
                // "Pass as shown."
            ]
        }
    }
};

function showTabContent(button, slideIndex = 0) {
    const data = button.id;
    const carousel_content = document.getElementById('step-slides');
    const carousel_dots = document.getElementById('carousel_dots');
    var tabButtons = document.querySelectorAll('.tab-button');

    // Remove 'active' class from all tab buttons
    tabButtons.forEach(function(button) {
        button.classList.remove('active');
    });
    button.classList.add('active');

    var parentDiv = button.parentNode;
    var parentId = parentDiv.id;

    function getQueryParameter(name) {
        const urlParams = new URLSearchParams(window.location.search);
        return urlParams.get(name);
    }
    const source = getQueryParameter('source');
    if (source == "I") {
        parentId = "I_" + parentId;
    }

    const tab_content = database[parentId][data];
    var set_image_type = localStorage.getItem('image_type');

    if (tab_content[set_image_type] == undefined) {
        set_image_type = "real";
    }
    var step_length = tab_content[set_image_type].length;

    for (var i = 1; i <= step_length; i++) {
        if (i==1) {
            carousel_content.innerHTML = `
                <div class="carousel-slide" style="display: block;">
                    <div style="display: flex;">
                        <p class="stepNB">1</p>
                        <img src=${tab_content[set_image_type][i-1]}>
                    </div>
                    <p class="stepText">${database[parentId][data]["text"][i-1]}</p>
                </div>
            `;
            carousel_dots.innerHTML = `
                <span class="dot" onclick="currentSlide(1)"></span>
            `;
        } else {
            carousel_content.innerHTML += `
                <div class="carousel-slide" style="display: block;">
                    <div style="display: flex;">
                        <p class="stepNB">${i}</p>
                        <img src=${tab_content[set_image_type][i-1]}>
                    </div>
                    <p class="stepText">${database[parentId][data]["text"][i-1]}</p>
                </div>
            `;
            carousel_dots.innerHTML += `
                <span class="dot" onclick="currentSlide(${i})"></span>
            `;
        }
    }
    showSlide(slideIndex);
}

document.addEventListener('DOMContentLoaded', () => {
    const divWithClasses = document.querySelector('button.tab-button.active');
    divWithClasses.click();
});
