ClemenceSul/FALCON_Hand/(commit log)

2024-06-19 initial commit assemble fingers images
2024-06-19 initial commit wiring image
2024-10-20 Upload Palm Assembly Content
