ClemenceSul/FALCON_Hand/FALCONHand.JPG

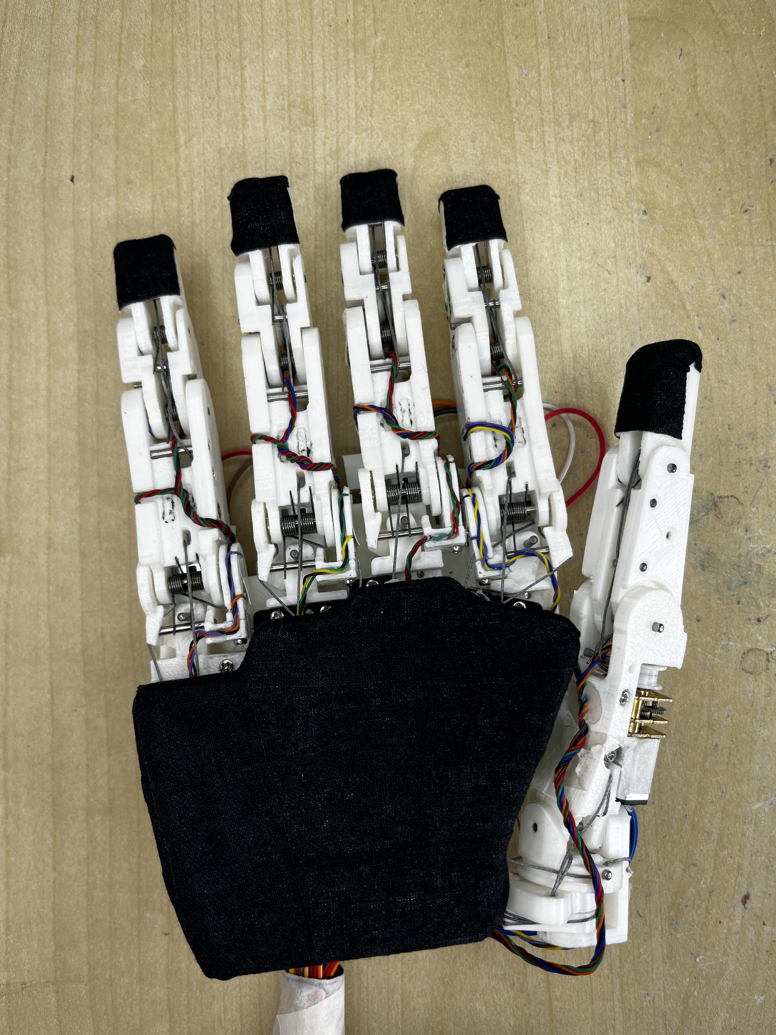
[picture p1: FALCONHand.JPG]
FALCONHand.JPG
